HecVelaz/keepon-pro/docs/hardware/README.md

# Hardware

El detalle técnico (calibración de cada servo, alimentación, pines y problemas encontrados) está en
[`../HARDWARE.md`](../HARDWARE.md). Acá están las imágenes y los documentos de apoyo.

| Carpeta | Contenido |
|---|---|
| [`fotos/`](fotos/) | Wall-E armado (`Wall-e_frontal.jpeg`, `Wall-e_costado1.jpeg`, `Wall-e_costado2.jpeg`) y fotos o capturas de cada componente: Raspberry Pi 5, Camera Module 3 NoIR, ESP32-C3, servos, buzzer, powerbank y brazo de servo |
| [`diagrama_sistema/`](diagrama_sistema/index.html) | Diagrama eléctrico y del sistema, interactivo (abrir `index.html` en el navegador), con sus fotos |
| [`hojas_de_datos/`](hojas_de_datos/) | Hojas de datos y capturas de los servos que se probaron y no quedaron en el robot (SG90, MG90S, HS-7955TG) |

El diagrama de componentes del informe y del README (`../img/diagrama_componentes.png`) se genera con
`scripts/diagrama_componentes.py` a partir de estas fotos.
