HecVelaz/keepon-pro/docs/revisiones/README.md

# Revisiones externas

Durante el proyecto se pidieron revisiones a otro modelo (Codex, en modo solo lectura) para encontrar fallas antes de
construir. Cada una dice sobre qué versión se hizo; lo que se corrigió quedó anotado en
[`../HOJA_DE_RUTA.md`](../HOJA_DE_RUTA.md) y en [`../DECISIONES.md`](../DECISIONES.md).

| Archivo | Qué se revisó |
|---|---|
| [`REVISION_CODEX.md`](REVISION_CODEX.md) | El plan inicial frente a la consigna (30/09) |
| [`REVISION_CODEX_M0.md`](REVISION_CODEX_M0.md) | El primer código del robot: 8 fallos, todos corregidos y con test de regresión en `tests/test_regresiones_codex.py` |
| [`REVISION_CODEX_PI.md`](REVISION_CODEX_PI.md) | La Raspberry Pi real y el rendimiento de la percepción |
| [`REVISION_CODEX_ARQ.md`](REVISION_CODEX_ARQ.md) | La arquitectura: qué va en la Pi y qué en la ESP32 |
| [`REVISION_CODEX_HW.md`](REVISION_CODEX_HW.md) | El hardware: servos, pines de la ESP32 y alimentación |
