HecVelaz/keepon-pro/docs/HARDWARE.md

# Hardware real de Keepon pro

Movido desde `CLAUDE.md` el 22/10/2026. Referencia del hardware: Pi, cámara, ESP32-C3, servos y alimentación.
Las pruebas de banco de los servos están en `pruebas_servos/` (ver `pruebas_servos/CLAUDE.md`).

- **Raspberry Pi 5, 4 GB**, Ubuntu 24.04 + ROS 2 Jazzy. **No se puede cambiar el SO**: la Pi se usa en otros proyectos.
- **Camera Module 3 NoIR estándar** (RSP-CAM-V3-NOIR, **no la Wide**: 66° H nominal, lente de 11,5 mm; la foto de `docs/hardware/fotos/camera_Noir_module_3/` es de la Wide, solo ilustrativa) (IMX708) en `i2c@88000` desde el 03/11 (antes `i2c@80000`), **montada invertida: `orientation_deg: 180`** en `config.yaml`, que aplica `camera_ros`. Cinta disponible: **~150 mm** (15→22 pines): por eso la Pi tiene que ir en la cabeza, sobre roll (`docs/revisiones/REVISION_CODEX_ARQ.md`). Es NoIR, sin filtro IR, así que hay riesgo con los colores de las camisetas. La segunda NoIR (`i2c@88000`) aparece en libcamera pero no transmite ("Camera frontend has timed out": revisar el flex) y corre los índices: los scripts eligen la cámara **por nombre** (`camera.ros_camera` de `config.yaml`; `CAMARA=...` la cambia), no con `camera:=0`.
- **ESP32-C3-DevKitM-1** (no S3) para los 3 servos y el buzzer, por el micro-USB con puente UART (`/dev/ttyUSB0`; preferir `/dev/serial/by-id/...`). Pines: yaw GPIO0, pitch GPIO1, roll **GPIO4** (antes GPIO3; se cambió el 12/10 buscando una vibración que al final era del servo, y quedó así: el GPIO3 está al lado del GPIO2, de strapping), buzzer **GPIO5** desde el 03/11 (`buzzer.pin` de `config.yaml`; en el GPIO10 dejó de sonar con la cabeza v6 armada) (módulo pasivo MH-FMD desde el 26/10: VCC a **3V3**, activo en bajo, ver `pruebas_buzzer/README.md`); evitar 2/8/9 (strapping), 18/19 (USB) y 20/21 (UART0). Análisis completo en `docs/revisiones/REVISION_CODEX_HW.md` (escrito para microservos). Es un **clon con conversor CH340** (`1a86:7523`, `/dev/serial/by-id/usb-1a86_USB_Serial-if00-port0`). **Desde el 14/10 está conectada a la Pi y tiene cargado el firmware del robot** (`firmware/keepon_fw/`). Abrir el puerto no la reinicia; un pulso de RTS (con DTR bajo) sí. Para volver a las pruebas de banco, cargar `pruebas_servos/prueba_servo/prueba_servo.ino`.
- **Servos (asignación del 12/10, todos en `neck.servos` de `config.yaml`; planilla completa en `pruebas_servos/README.md`).** En el modelo vigente (v6 R4, `docs/diseno_v6/LEEME_GIT.md`): el RDS3218 va en la base y gira la horquilla; un MG996R va en la horquilla y mueve la cuna (pitch); otro MG996R va en la cuna y mueve la cabeza con el disco de 25T (roll). **Desde el 05/11 pitch y roll son dos TowerPro MG996R nuevos** (reemplazan al HS-7955TG y al MG996R con zona muerta). **Calibración montada (05/11):** ceros yaw 1500 / pitch 1500 / roll 1500 µs, signos −1 / −1 / −1 (el del roll sin verificar montado), sin compensación de zona muerta; detalle en `config.yaml`.
  - **yaw = DSSERVO RDS3218 n.º 2** (GPIO0): 270°, asimétrico 0,13/0,136 °/µs (lista `[lado <1500, lado >1500]`), ±70° ≈ 960/2010 µs, límites 950/2020 (no tiene tope: los límites protegen el cableado), banda muerta ≤ 2 µs abajo y 4–6 µs arriba, picos de ~1 A a 260 °/s. **Sin pulso mantiene la posición.**
  - **pitch = TowerPro MG996R nuevo** (GPIO1, desde el 05/11, ~10 kgf·cm a 6 V): 0,092 °/µs; montado, +30° = 1174 µs y −20° = 1717 µs (pulso mayor = la cara BAJA, signo −1); límites 1100/1800 µs. **Sin pulso queda flojo: la cabeza cae** al cortar el pulso o los 6 V (sostenerla al cargar el firmware y al apagar).
  - Antes (09/10–05/11), **pitch = Hitec HS-7955TG** (GPIO1, ~18 kgf·cm): 0,090 °/µs lineal, límites electrónicos 750/2250 µs (≈ ±68°; en el firmware 760/2240), banda muerta ≤ 2 µs, holgura ≤ 1°, 6 mA en reposo. **Sin pulso mantiene la posición con fuerza**: el STOP/watchdog la congela, no la afloja (para aflojarlo hay que cortar los 6 V). El primer pulso después de encender salta a velocidad máxima: el firmware tiene que arrancar en una postura conocida. Es el servo que más ruido mete en la alimentación.
  - **roll = TowerPro MG996R nuevo** (GPIO4, desde el 05/11): sin carga, +217 µs = +20° justos y −217 µs casi 20°; vuelve a 0 sin la zona muerta del anterior. Montado vibra un poco quieto en 0 al volver de −20°. Sin pulso queda flojo.
  - Antes (13/10–05/11), **roll = TowerPro MG996R n.º 1** (GPIO4): lineal y simétrico 0,092 °/µs, límites 1000/2000 µs (roll pide ±20°), sin tope hasta 800/2300 µs. **Banda muerta de ~100–110 µs (≈ 10°) e intermitente**: de +10° a 0° no volvió en 3 de 10 intentos; pasos de 20° andan siempre. Se aceptó porque roll hace gestos grandes; el firmware tiene que mandarle el objetivo de un solo movimiento. **Sin pulso queda flojo**. Pesa 55 g. Sentido de giro sin anotar. El MG90S (0,090/0,085 °/µs, banda muerta 20–30 µs, al máximo de su tensión a 6 V) queda de repuesto.
  - **Sentido de giro** (12/10, visto de frente al eje): pulso mayor = **antihorario** en los RDS3218 y el MG90S (el MG996R, sin anotar); **horario** en el HS. Para que yaw y pitch giren juntos en el banco hay que mandarle al HS el pulso en espejo (1500 − Δ). En el robot lo resuelve `signo` por eje, que se define al montar.
  - **Descartado: RDS3218 n.º 1.** Vibra (≈ 0,5 A) al quedar quieto cerca de 1500 µs, sobre todo con el HS activo; intercambiándolo con el n.º 2, la vibración siguió al servo (no era pin, señal ni cableado). Repuestos: SG90 (0,090 °/µs, engranajes plásticos, sin pulso queda flojo). El SM-S4315R es de rotación continua.
  - Los tres juntos andan bien a velocidad alta (12/10, fuente de laboratorio a 6 V). GND en estrella. El capacitor de 2200 µF + 100 nF en la bornera **se sacó del diseño el 26/10** (con la fuente de laboratorio los tres anduvieron bien sin él): si en el robot armado los servos tiemblan en los giros rápidos, es lo primero que hay que volver a poner. **Sin GND común entre la ESP32 y la fuente, ningún servo se mueve.** Son servos estándar (13–65 g). **No hay rodamiento de yaw** (no se consigue): desde el 14/10 la v3 apoya el plato solo en el horn del RDS3218 (≈ 330 g, ≈ 1,3 kgf·cm de vuelco; ver `docs/cad_anteriores/keepon_v3_cad/README.md`).
- **Alimentación (decisión del 14/10): fuente de laboratorio para los servos y powerbank para la Pi.** La LiPo Zeee y los reguladores salieron del diseño. Son dos fuentes separadas, unidas solo por el GND.
  - **Servos:** fuente de laboratorio externa a **6,0 V** (máximo 7,4 V), con el **límite de corriente en 4–5 A** (≥ 6 A ideal). En uso normal piden 2–3 A; trabados, 2,5–4,2 A por servo. Entra por dos bornes banana en la pared de atrás de la caja → interruptor (solo +6 V, ≥ 10 A: parada de emergencia y única forma de aflojar el HS) → bornera de 6 V.
  - **Pi 5:** powerbank **Xiaomi PB2020MI** (el mismo del recolector de frutas: se usan por separado; 20 000 mAh, 74 Wh, 5 V/3 A por puerto; ficha en `docs/hardware/fotos/Bateria_powerbank_xiaomi/`), desde su salida **USB-A** (da 5 V sin negociar: no hace falta placa USB-C con 5,1 kΩ en CC) con un cable USB-A cortado a 2 hilos (≥ 22 AWG) → bornera de 5 V en la base → pines 2/4 y 6 del GPIO, con cable de 20 AWG. **Conectado directo por USB-C, el powerbank alimenta bien a la Pi** (14/10, en el banco): si al armar la cabeza el USB-C queda libre (`PI_CSI_SALIDA`), usar un cable USB-C acodado directo y eliminar el camino por el GPIO. Sin los 5 A de PD, la Pi limita los USB a 600 mA (a la ESP32 le alcanza): no forzar `usb_max_current_enable`. Dura ~9 h. Medir ≥ 4,9 V en los pines.
  - **Encender:** primero el powerbank y después los 6 V, con la cabeza cerca de home. **Apagar:** al revés.
- La ALP002 ajustable (3–24 V, **1,5 A**, **entrada 100–120 V de alterna: no enchufar a 220 V sin transformador**) sirve solo para probar un servo sin carga. Para las pruebas individuales, mejor la fuente de laboratorio con límite de corriente.
- La notebook (x86, GPU vieja, sin CUDA) sirve solo para desarrollar.
