HecVelaz/keepon-pro/docs/diseno_v6/INFORME_ENTREGA_V6.md

# Resultado de la entrega V6

Se guardaron y reabrieron 18 piezas individuales y
el ensamblaje SolidWorks 2021 con cuatro grupos rígidos, seis relaciones y
diez poses resueltas. Los tres acoples eje/horn se identificaron por pareja y
volumen; no hubo otras interferencias nativas reportadas.

R2 retira la tapa14 y sus cuatro M3, crea dos aberturas posteriores simétricas
de36 ×26 mm y conserva la cuna R1. Actualiza soporte15 al PCB medido RLBZ23
de13 ×31,8 ×1,5 mm, agujeroØ3 con centro a6,3/16,4 desde bordes; buzzer abajo
y pines arriba. Carcasas16/17 espejadas con estética WALL-E y lentes19/20
pegables aparte; arandela21 y M3×5 para el PCB.

Se repitió el barrido B-Rep completo de 495 poses con los M3×6 finales.
Una reserva USB de diseño pasa 41 poses de roll cada grado, con mínimo
muestreado 0,69 mm del lado Y negativo. No representa un enchufe físico.
Los 17 STEP/STL de revisión pasaron geometría de archivo y
orientación; 13 regresiones están aprobadas.

La base V5 no se modificó. El modelo integrado incorpora soportes, encastres
nominales, retenciones, salida USB, cámara, portamódulo y ojos. El perfil de
pitch es una referencia de estudio de una rama. Se modela el PCB del RLBZ23;
alturas/componentes/pines y enchufes aún faltan medir. Por eso el conjunto
no se libera para fabricar. Consultar README y MEDICIONES_PENDIENTES.

Para abrir la entrega, extraer el ZIP y mantener todos los SLDPRT junto al
SLDASM dentro de SOLIDWORKS_V6. Se leyeron las dependencias guardadas de
los cuatro grupos: no tienen referencias externas ni requieren los STEP.
Para regenerar el CAD se requiere el repositorio con las fuentes V2–V5,
CadQuery y la instalación local indicada; el ZIP permite revisar los modelos
sin disponer de Python.
