HecVelaz/keepon-pro/docs/diseno_v6/revision_R4/interfaces_R4.csv

pieza | uso | eje | diametro_mm | centro_x_mm | centro_y_mm | centro_z_mm | inicio_eje_mm | fin_eje_mm | nota
Soporte_servo_base | Paso M3 centrado en pilar | Z | 3.4 | -18 | -6 | 0 | 38 | 44
Base_con_pilares | Alojamiento inserto M3 L5 | Z | 4 | -18 | -6 | 0 | 31.4 | 38 | Diámetro de inserto provisional
Soporte_servo_base | Paso M3 centrado en pilar | Z | 3.4 | -18 | 6 | 0 | 38 | 44
Base_con_pilares | Alojamiento inserto M3 L5 | Z | 4 | -18 | 6 | 0 | 31.4 | 38 | Diámetro de inserto provisional
Soporte_servo_base | Paso M3 centrado en pilar | Z | 3.4 | 38 | -6 | 0 | 38 | 44
Base_con_pilares | Alojamiento inserto M3 L5 | Z | 4 | 38 | -6 | 0 | 31.4 | 38 | Diámetro de inserto provisional
Soporte_servo_base | Paso M3 centrado en pilar | Z | 3.4 | 38 | 6 | 0 | 38 | 44
Base_con_pilares | Alojamiento inserto M3 L5 | Z | 4 | 38 | 6 | 0 | 31.4 | 38 | Diámetro de inserto provisional
Carcasa_cabeza | Piloto Pi | Z | 2.2 | -3.5 | -44 | 0 | 111.4 | 119.4 | Poste Ø9×8
Carcasa_cabeza | Piloto Pi | Z | 2.2 | -3.5 | 5 | 0 | 111.4 | 119.4 | Poste Ø9×8
Carcasa_cabeza | Piloto Pi | Z | 2.2 | 54.5 | -44 | 0 | 111.4 | 119.4 | Poste Ø9×8
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
