HecVelaz/keepon-pro/docs/consigna/README.md

# Consigna

| Archivo | Contenido |
|---|---|
| [`2026S2uTP_RoboticaSocial.pdf`](2026S2uTP_RoboticaSocial.pdf) | Enunciado original de la cátedra (Robótica II, FIUNA) |
| [`2026S2uTP_RoboticaSocial.md`](2026S2uTP_RoboticaSocial.md) | El mismo enunciado en Markdown, para leerlo y buscar en GitHub |
| [`CHECKLIST_TP.md`](CHECKLIST_TP.md) | Cada punto de la consigna (T1 a T7 y la entrega) con su estado y dónde está en el código |
| [`checklist_robotica_social.html`](checklist_robotica_social.html) | El mismo checklist, interactivo (se abre en el navegador) |
