HecVelaz/keepon-pro/docs/diseno_v6/revision_R4/ESTADO_TRABAJO.md

# R4 actualizada: extremo del buzzer despejado

Se retiraron los dos apoyos cilindricos y la guia rectangular seleccionados por el usuario. Se conserva el poste con piloto ciego para el unico tornillo trasero del buzzer.

33 regresiones geometricas y barrido sin interferencias imprevistas aprobados; 12 STL cerrados y orientados. Cuatro grupos nativos verificados, seis relaciones, diez posiciones y ensamblaje guardado y reabierto. Copia de los archivos nativos anteriores en HISTORIAL/antes_retirar_apoyos_buzzer/.

Ensamblaje actualizado: SOLIDWORKS_R4/Keepon_V6_R4.SLDASM, abierto en SolidWorks. Entrega actualizada: ../Keepon_V6_R4.zip.
