HecVelaz/keepon-pro/docs/cad_anteriores/keepon_v4_cad/cabeza.png

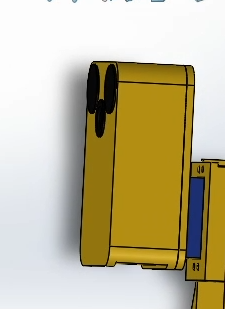
docs/cad_anteriores/keepon_v4_cad/cabeza.png
