HecVelaz/keepon-pro/docs/cad_anteriores/keepon_v4_cad/cuerpo.png

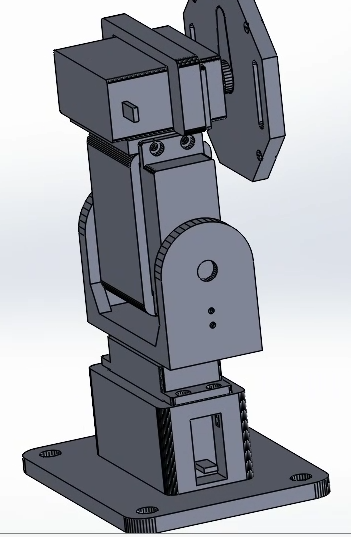
docs/cad_anteriores/keepon_v4_cad/cuerpo.png
