HecVelaz/keepon-pro/docs/cad_anteriores/keepon_v4_cad/vistas/02_atras_iso.png

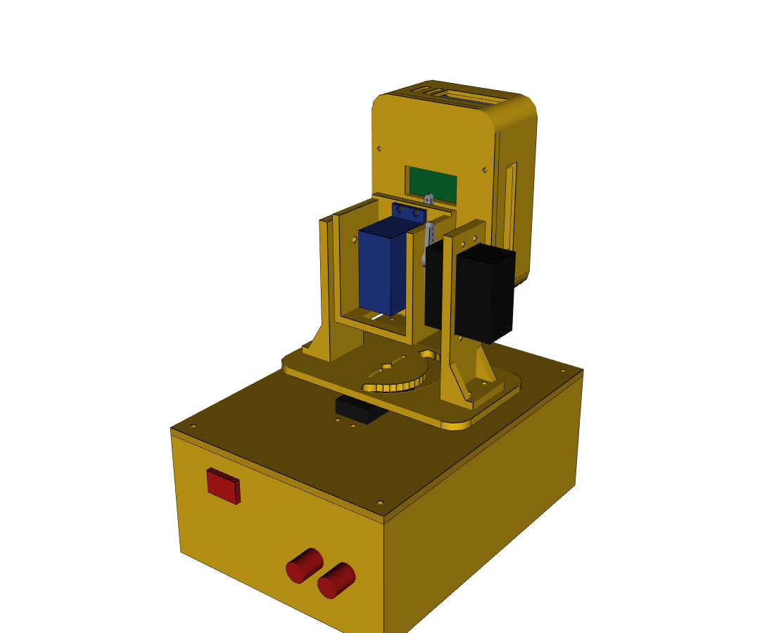
docs/cad_anteriores/keepon_v4_cad/vistas/02_atras_iso.png
