HecVelaz/keepon-pro/docs/cad_anteriores/keepon_v4_cad/vistas/03_costado.png

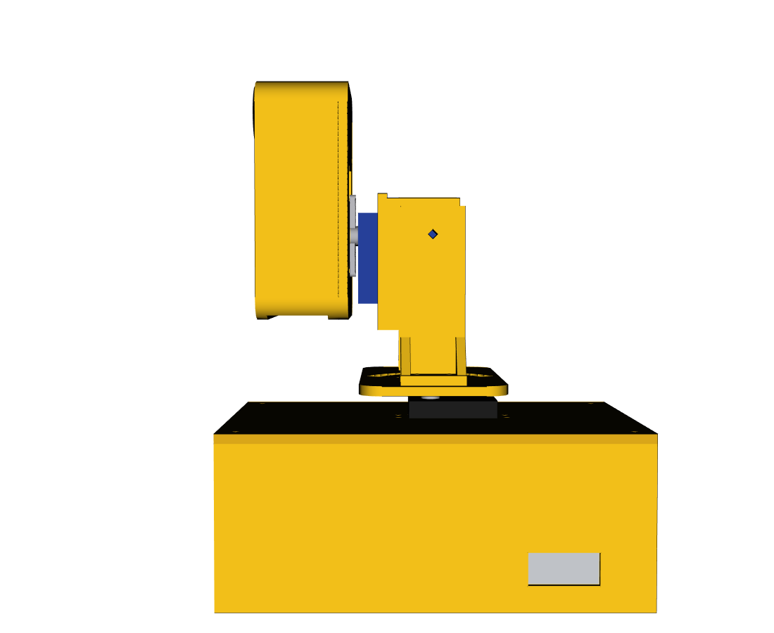
docs/cad_anteriores/keepon_v4_cad/vistas/03_costado.png
