HecVelaz/keepon-pro/docs/cad_anteriores/keepon_v4_cad/vistas/04_frente.png

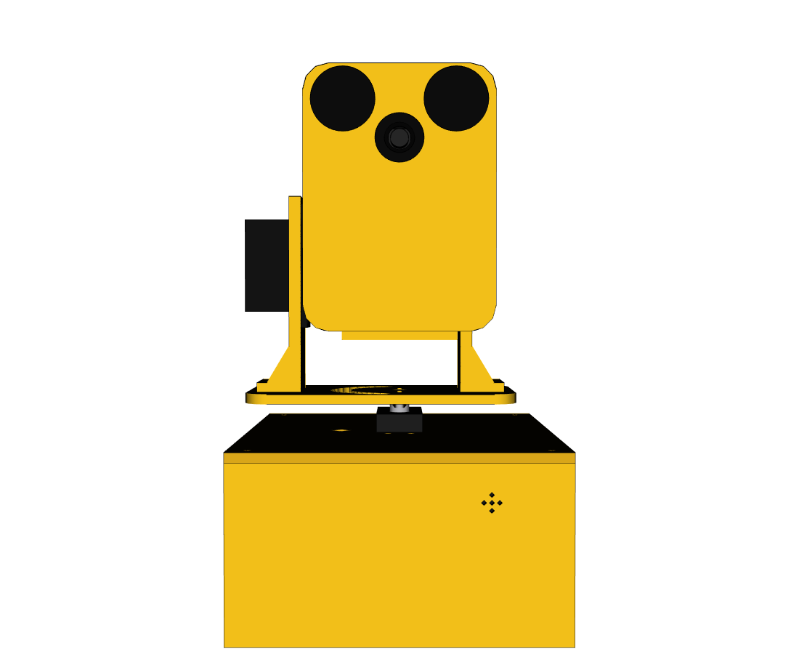
docs/cad_anteriores/keepon_v4_cad/vistas/04_frente.png
