HecVelaz/keepon-pro/docs/cad_anteriores/keepon_v4_cad/vistas/07_mira_arriba_yaw.png

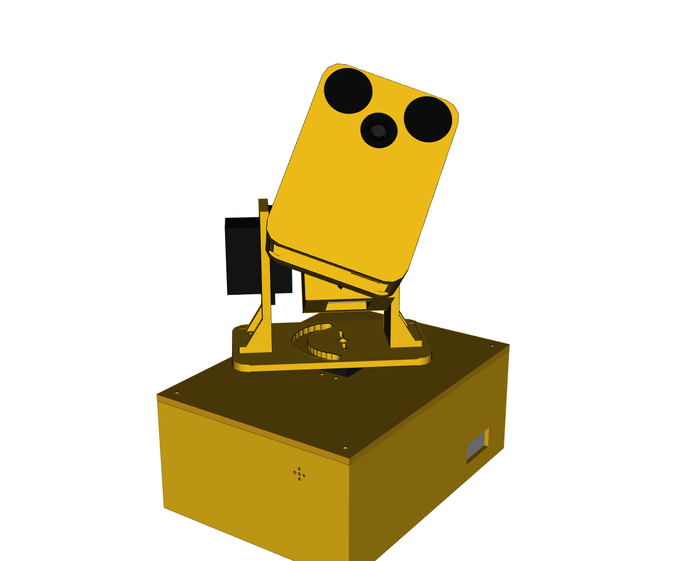
docs/cad_anteriores/keepon_v4_cad/vistas/07_mira_arriba_yaw.png
