HecVelaz/keepon-pro/docs/diseno_v6/revision_R4/vistas/02_R4_disco_roll.png

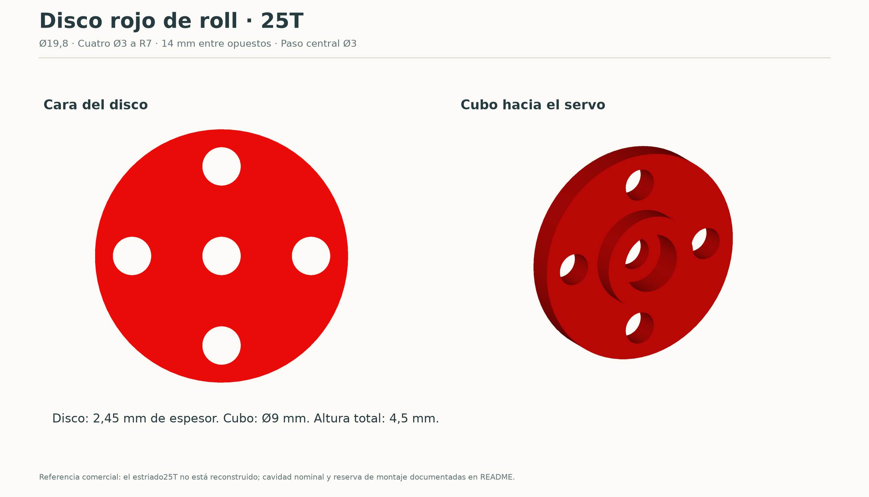
docs/diseno_v6/revision_R4/vistas/02_R4_disco_roll.png
