HecVelaz/keepon-pro/docs/hardware/diagrama_sistema/fotos/camara.jpg

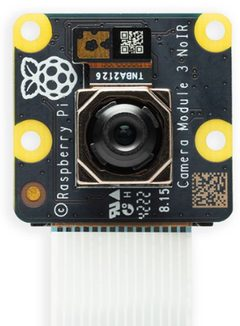
docs/hardware/diagrama_sistema/fotos/camara.jpg
