HecVelaz/keepon-pro/docs/hardware/diagrama_sistema/fotos/hs7955tg.jpg

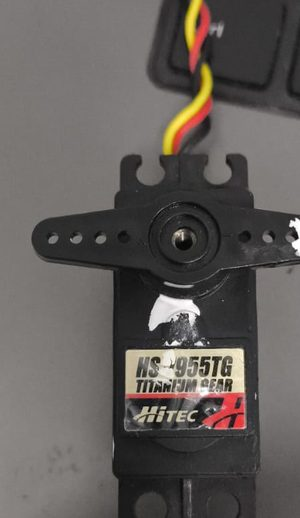
docs/hardware/diagrama_sistema/fotos/hs7955tg.jpg
