HecVelaz/keepon-pro/docs/hardware/diagrama_sistema/fotos/mg996r.jpg

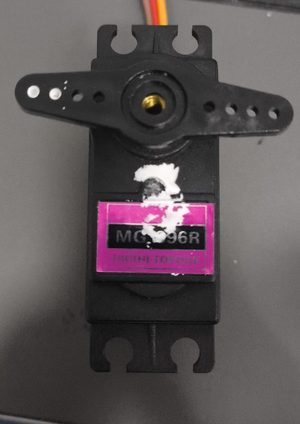
docs/hardware/diagrama_sistema/fotos/mg996r.jpg
