HecVelaz/keepon-pro/docs/hardware/diagrama_sistema/fotos/mg996r_nuevo.jpg

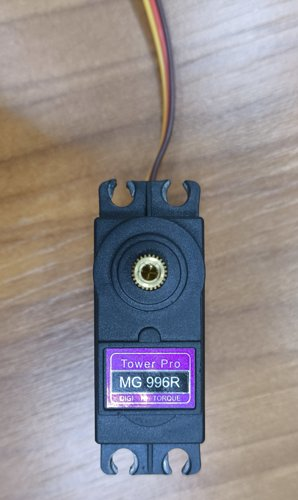
docs/hardware/diagrama_sistema/fotos/mg996r_nuevo.jpg
