HecVelaz/keepon-pro/docs/hardware/diagrama_sistema/fotos/pi5.jpg

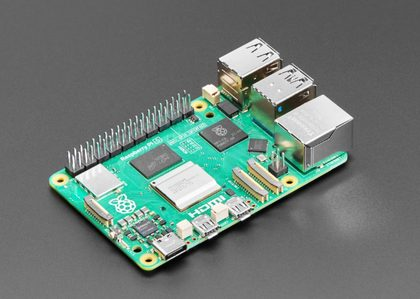
docs/hardware/diagrama_sistema/fotos/pi5.jpg
