HecVelaz/keepon-pro/docs/hardware/diagrama_sistema/fotos/powerbank.jpg

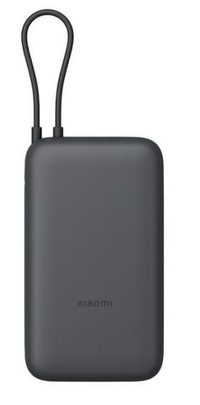
docs/hardware/diagrama_sistema/fotos/powerbank.jpg
