HecVelaz/keepon-pro/docs/hardware/diagrama_sistema/fotos/rds3218.jpg

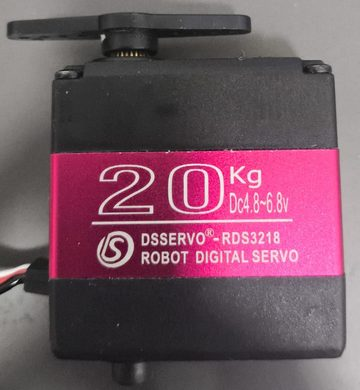
docs/hardware/diagrama_sistema/fotos/rds3218.jpg
