HecVelaz/keepon-pro/docs/hardware/fotos/Bateria_powerbank_xiaomi/Captura_desde_2026-10-14_18-55-17.png

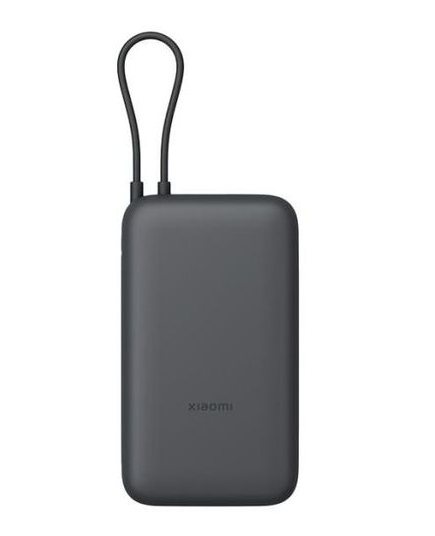
docs/hardware/fotos/Bateria_powerbank_xiaomi/Captura_desde_2026-10-14_18-55-17.png
