HecVelaz/keepon-pro/docs/hardware/fotos/bateria_zee/Captura_desde_2026-10-05_20-32-26.png

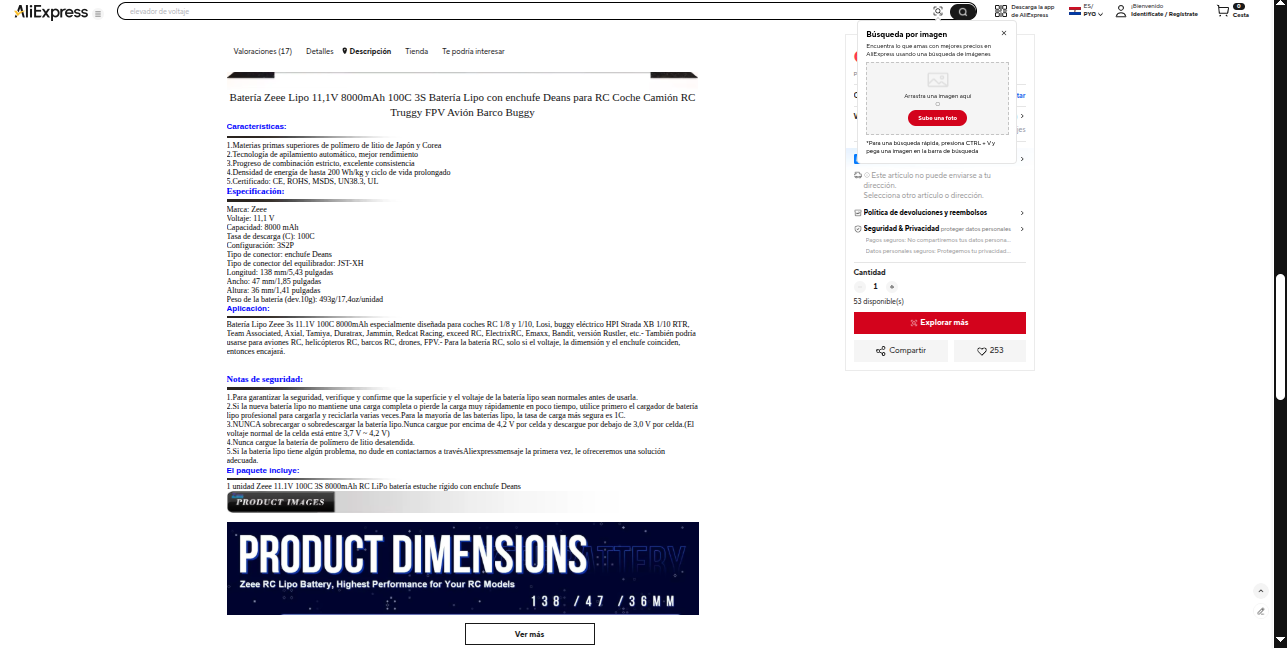
docs/hardware/fotos/bateria_zee/Captura_desde_2026-10-05_20-32-26.png
