HecVelaz/keepon-pro/docs/hardware/fotos/brazo_servo/brazo_servo.jpeg

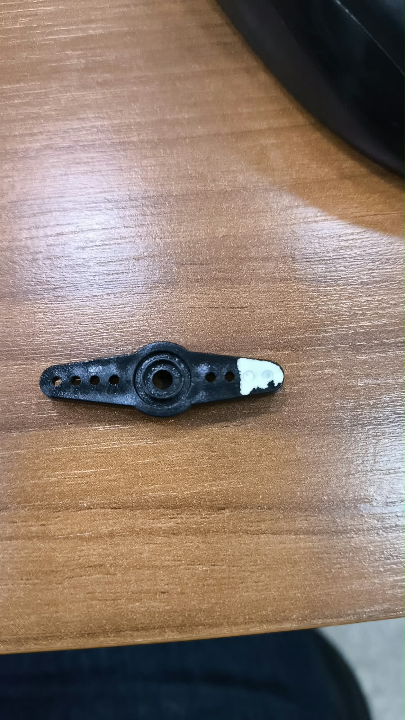
docs/hardware/fotos/brazo_servo/brazo_servo.jpeg
