HecVelaz/keepon-pro/docs/hardware/fotos/camera_Noir_module_3/Captura_desde_2026-10-14_11-50-46.png

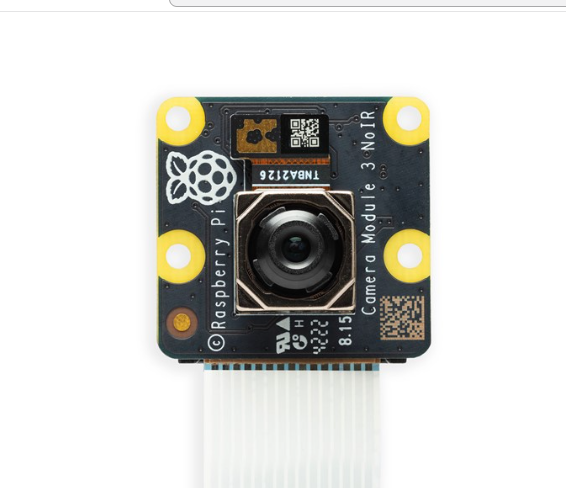
docs/hardware/fotos/camera_Noir_module_3/Captura_desde_2026-10-14_11-50-46.png
