HecVelaz/keepon-pro/docs/hardware/fotos/esp32_c3_mini_1/51aC5YsjEjL.webp

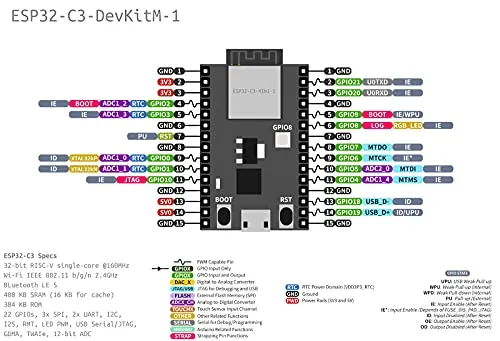
docs/hardware/fotos/esp32_c3_mini_1/51aC5YsjEjL.webp
