HecVelaz/keepon-pro/docs/hardware/fotos/esp32_c3_mini_1/51gB6Uad4BL._AC_SX425_.jpg

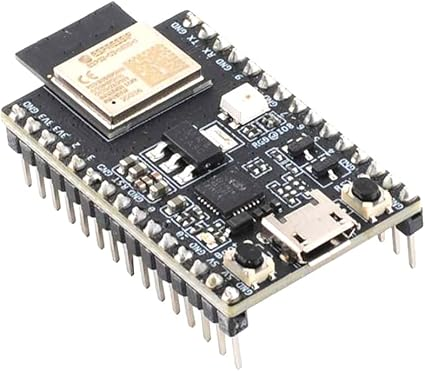
docs/hardware/fotos/esp32_c3_mini_1/51gB6Uad4BL._AC_SX425_.jpg
