HecVelaz/keepon-pro/docs/hardware/fotos/esp32_c3_mini_1/Captura_desde_2026-10-07_15-21-32.png

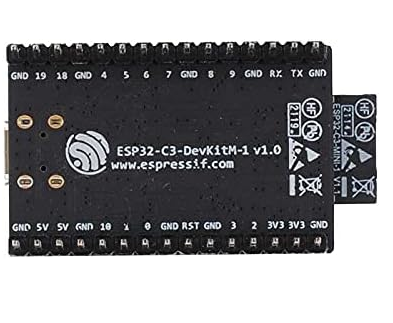
docs/hardware/fotos/esp32_c3_mini_1/Captura_desde_2026-10-07_15-21-32.png
