HecVelaz/keepon-pro/docs/hardware/fotos/MG_996r_nuevo/mg_996r.jpg

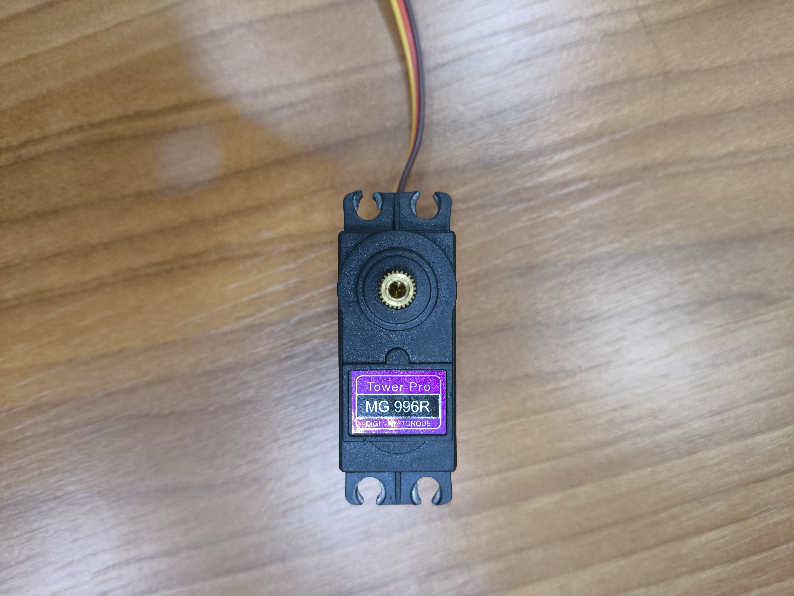
docs/hardware/fotos/MG_996r_nuevo/mg_996r.jpg
