HecVelaz/keepon-pro/docs/hardware/fotos/modulo_buzzer_pasivo/buzzer_pasivo.png

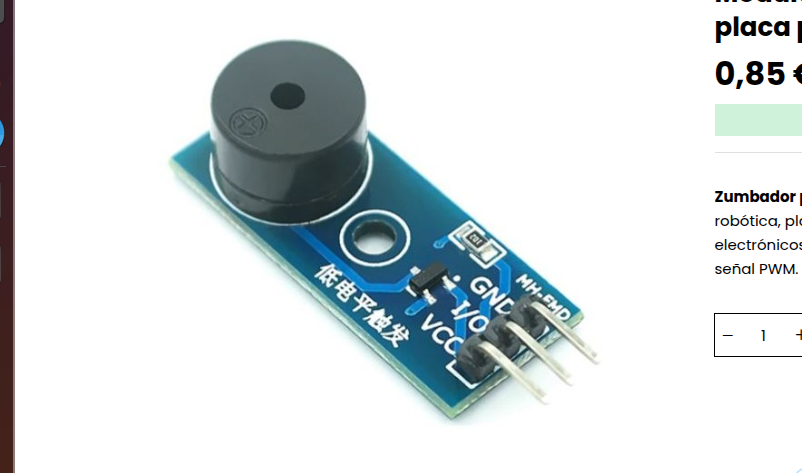
docs/hardware/fotos/modulo_buzzer_pasivo/buzzer_pasivo.png
