HecVelaz/keepon-pro/docs/hardware/fotos/raspberry_pi/Captura_desde_2026-10-14_11-07-33.png

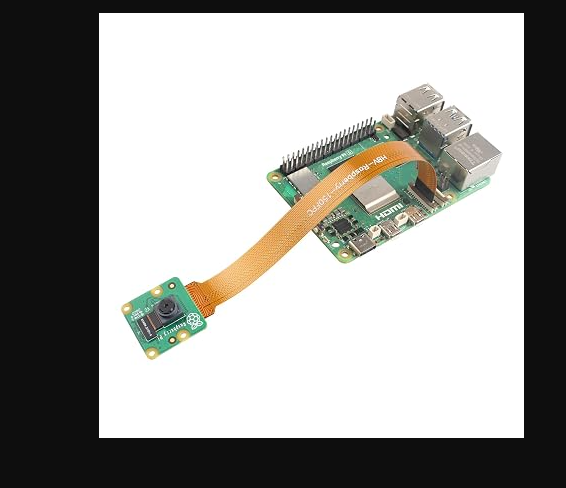
docs/hardware/fotos/raspberry_pi/Captura_desde_2026-10-14_11-07-33.png
