HecVelaz/keepon-pro/docs/hardware/fotos/servo_HS_7955TG/hs7955tg.jpeg

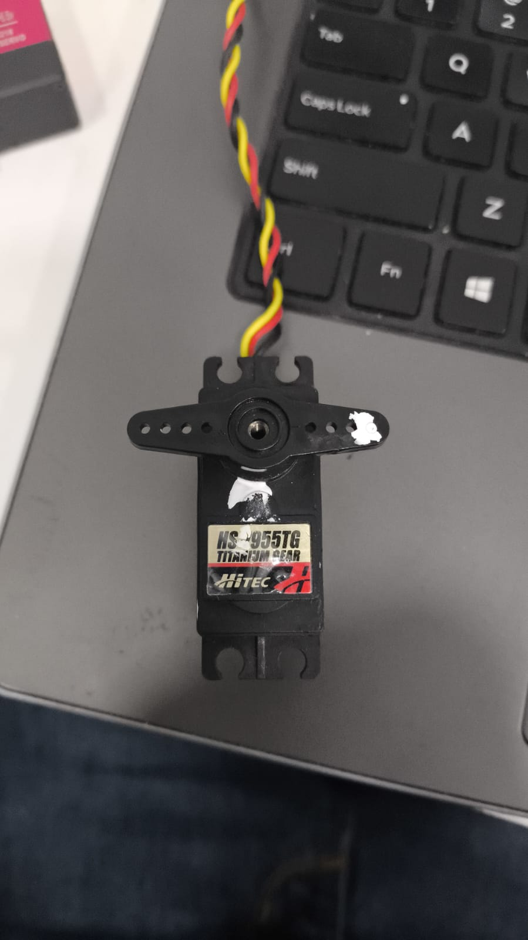
docs/hardware/fotos/servo_HS_7955TG/hs7955tg.jpeg
