HecVelaz/keepon-pro/docs/hardware/fotos/servo_MG_996R/mg996r.jpeg

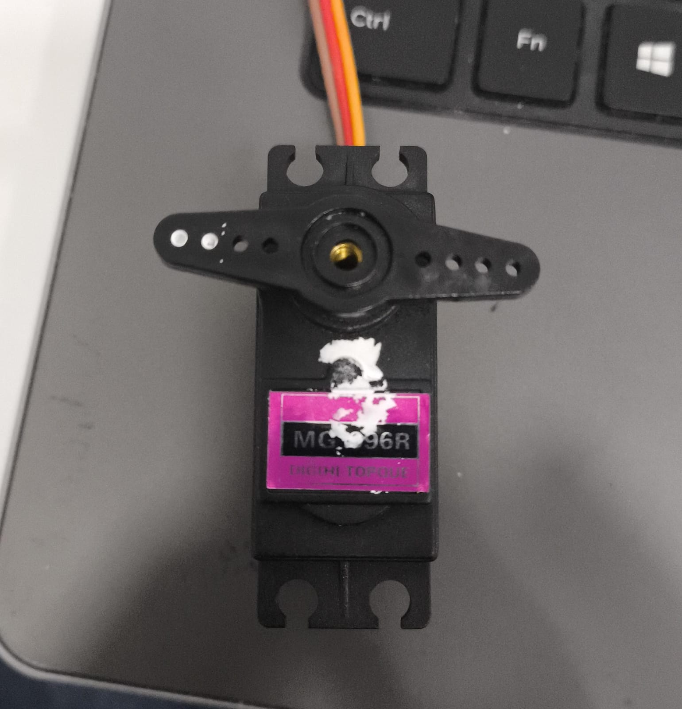
docs/hardware/fotos/servo_MG_996R/mg996r.jpeg
