HecVelaz/keepon-pro/docs/hardware/fotos/servo_RDS3218/rds3218.jpeg

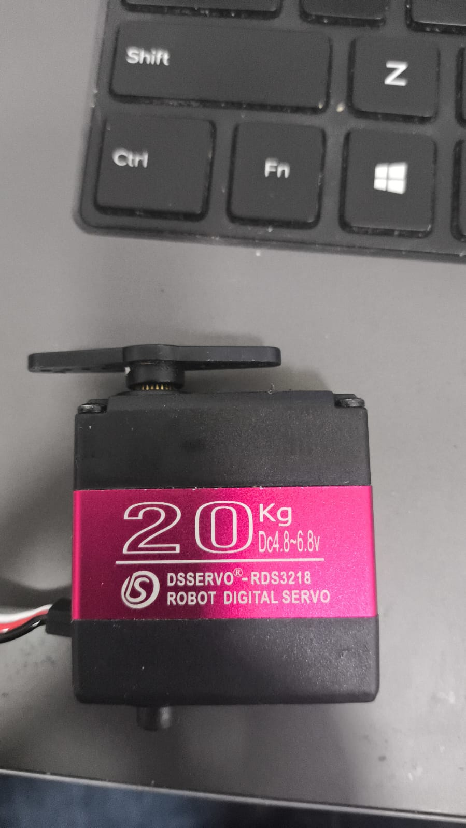
docs/hardware/fotos/servo_RDS3218/rds3218.jpeg
