HecVelaz/keepon-pro/docs/hardware/hojas_de_datos/micro_servo_mg90s/Captura_desde_2026-10-07_15-32-10.png

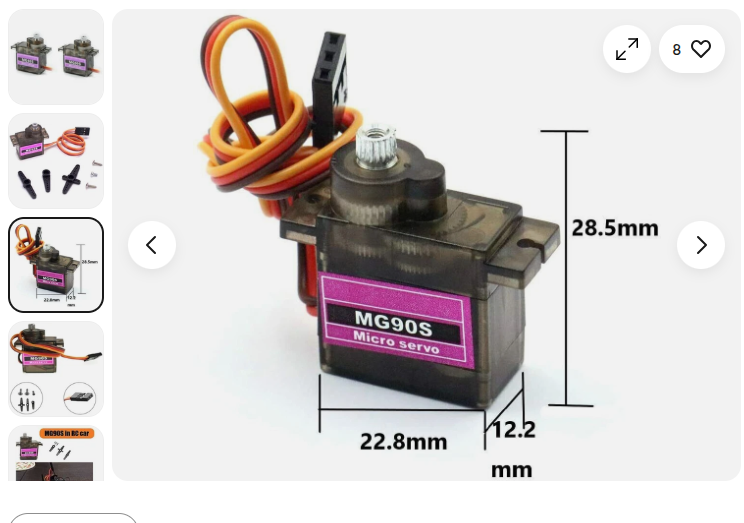
docs/hardware/hojas_de_datos/micro_servo_mg90s/Captura_desde_2026-10-07_15-32-10.png
