HecVelaz/keepon-pro/docs/hardware/hojas_de_datos/micro_servo_sg90/Captura_desde_2026-10-07_15-35-38.png

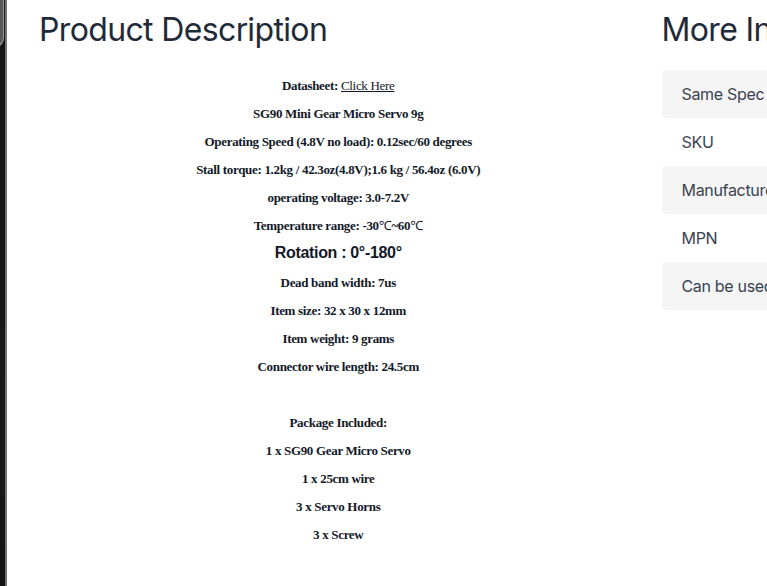
docs/hardware/hojas_de_datos/micro_servo_sg90/Captura_desde_2026-10-07_15-35-38.png
