HecVelaz/keepon-pro/docs/hardware/hojas_de_datos/servo_HS-7955TG_titanium_gear/Captura_desde_2026-10-07_16-58-57.png

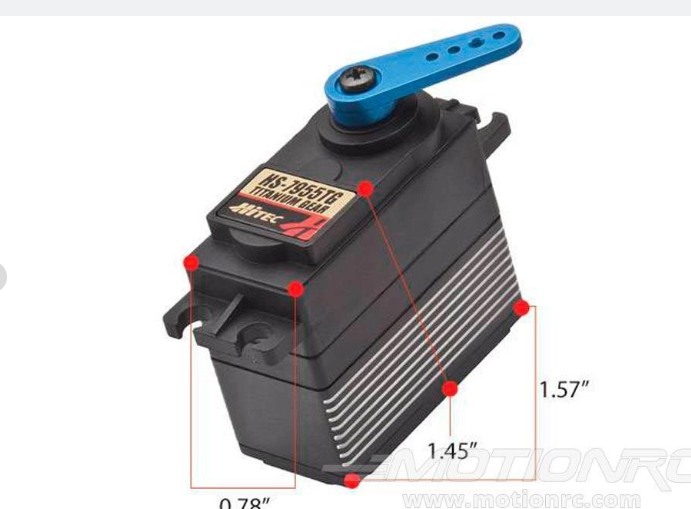
docs/hardware/hojas_de_datos/servo_HS-7955TG_titanium_gear/Captura_desde_2026-10-07_16-58-57.png
