HecVelaz/keepon-pro/docs/img/panel_celular_completo.png

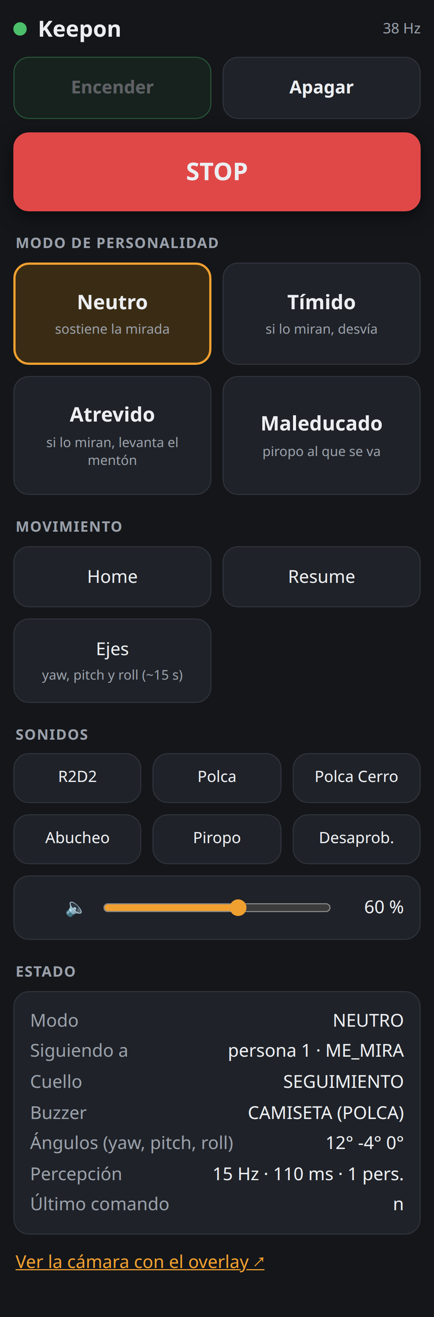
docs/img/panel_celular_completo.png
