HecVelaz/keepon-pro/docs/benchmark_pi_20260930_2personas.csv

fecha | label | modelo | imgsz | hilos | yolo | face | pose | cam_hz | proc_hz | yolo_ms | yolo_p95 | face_ms | pose_ms | total_ms | total_p95 | edad_ms | edad_p95 | cpu_pct | ram_mb | personas | rostros | poses | temp_c
2026-09-30 20:35:21 | P_yolo256_t4 | yolo26n_256_ncnn_model | 256 | 0 | 1 | 0 | 0 | 29.8 | 29.9 | 18.6 | 19.5 | 0.0 | 0.0 | 18.6 | 19.5 | 33.9 | 35.1 | 203 | 786 | 2 | nan | nan | 54.55
2026-09-30 20:35:42 | P_mediapipe | yolo26n_320_ncnn_model | 320 | 0 | 0 | 1 | 1 | 29.6 | 11.5 | 0.0 | 0.0 | 22.6 | 63.5 | 86.2 | 105.8 | 118.9 | 141.9 | 120 | 296 | nan | 0.72 | 1.28 | 52.9
2026-09-30 20:36:04 | P_full256 | yolo26n_256_ncnn_model | 256 | 0 | 1 | 1 | 1 | 26.6 | 9.0 | 20.2 | 24.2 | 24.2 | 66.4 | 110.8 | 132.8 | 144.6 | 166.0 | 153 | 951 | 2 | 0.39 | 1.96 | 52.9
2026-09-30 20:36:27 | P_full320 | yolo26n_320_ncnn_model | 320 | 0 | 1 | 1 | 1 | 24.5 | 8.0 | 29.5 | 32.0 | 26.1 | 68.7 | 124.3 | 129.7 | 156.4 | 168.4 | 166 | 954 | 2 | 0.62 | 1.95 | 54.55
