HecVelaz/keepon-pro/docs/cad_anteriores/keepon_mg996r_step/0_ensamble_referencia.step

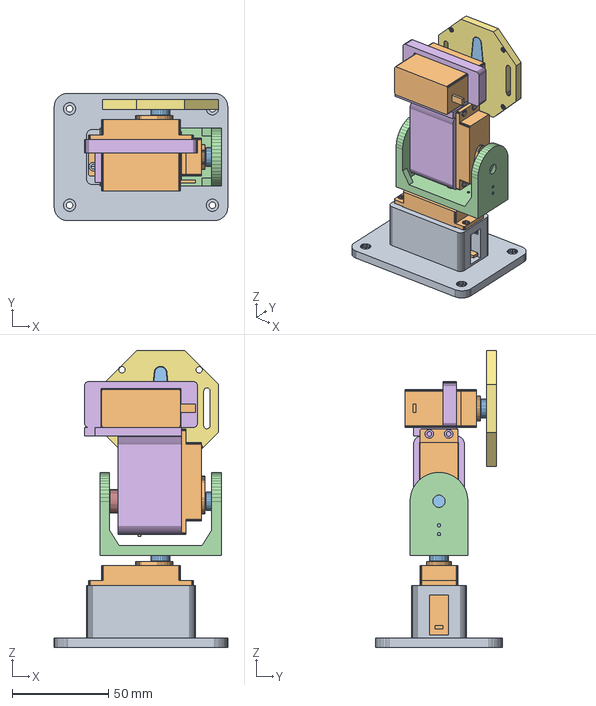
[picture p58: CAD file, 2026-10-14]
docs/cad_anteriores/keepon_mg996r_step/0_ensamble_referencia.step
90.0 x 66.0 x 153.9 mm
