HecVelaz/keepon-pro/docs/cad_anteriores/keepon_v4_cad/step/keepon_v4_ensamble.step

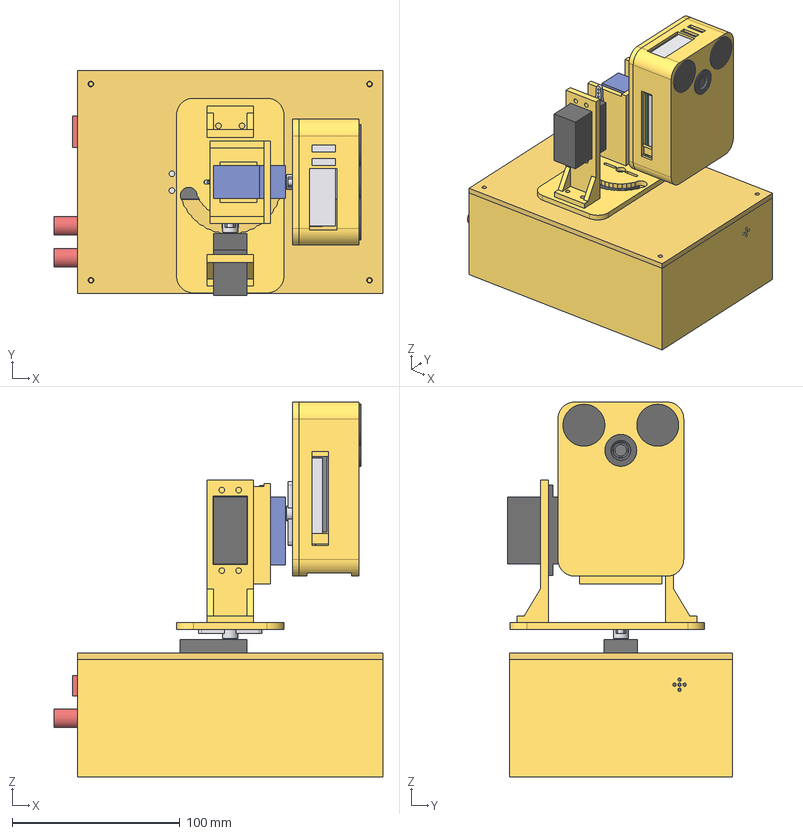
[picture p59: CAD file, 2026-10-14]
docs/cad_anteriores/keepon_v4_cad/step/keepon_v4_ensamble.step
196.0 x 134.0 x 223.5 mm
caja_base
tapa_base
powerbank_xiaomi_pb2020mi
bornera_6v
capacitor_2200uf
bornes_fuente_6v
esp32c3
porta_esp32
buzzer
interruptor
bornera_5v
plato_yaw
servo_yaw_rds3218
horn_yaw
soporte_pitch_izq
soporte_pitch_der
servo_pitch_hs7955tg
horn_pitch
horquilla_cabeza
servo_roll_mg996r
horn_roll
placa_roll
pi5_pcb
pi5_puertos
pi5_conectores_csi
pi5_active_cooler
camara_pcb
camara_lente
camara_conector
cinta_ffc
caja_cabeza
nariz_camara
ojo_izq
ojo_der
