HecVelaz/keepon-pro/docs/diseno_v6/revision_R4/STEP_V6/00_ensamble_V6_R4.step

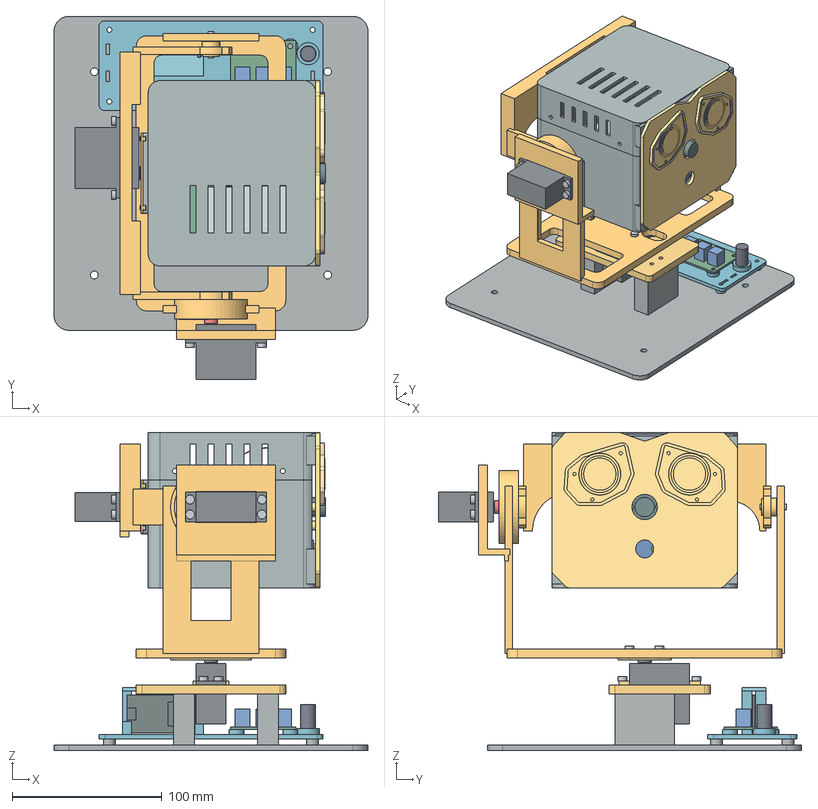
[picture p60: CAD file, 2026-11-08]
docs/diseno_v6/revision_R4/STEP_V6/00_ensamble_V6_R4.step
210.0 x 243.0 x 213.0 mm
01_base_con_pilares
02_horquilla_de_giro
03_cuna_de_inclinacion
04_carcasa_inferior_cabeza
05_tapa_superior_ventilada
06_cara_con_ojos_integrados
Referencia_pivote_M4
Referencia_Raspberry_Pi_5
Reserva_refrigerador_Raspberry_Pi
Referencia_camara_NoIR_3
Referencia_cinta_camara_150
08_bandeja_de_electronica
09_abrazadera_ESP32
Referencia_ESP32_C3_CH340
Referencia_placa_distribucion
Referencia_conector_base
Referencia_conector_inclinacion
Referencia_conector_balanceo
Referencia_capacitor_2200uF
10_soporte_centrado_servo_base
11_retencion_brazo_doble_base
13_retencion_disco_balanceo
Referencia_modulo_buzzer_31_8x12_8x10
Referencia_servo_base_RDS3218
Referencia_servo_inclinacion_HS7955TG
Referencia_servo_balanceo_MG996R
Referencia_brazo_doble_base
Referencia_disco_balanceo
Referencia_brazo_simple_inclinacion
Tornillo_M3_retencion_base_0
Tornillo_M3_retencion_base_1
Tornillo_M3_retencion_base_2
Tornillo_M3_retencion_base_3
Tornillo_M3_retencion_balanceo_0
Tornillo_M3_retencion_balanceo_1
Tornillo_M3_retencion_balanceo_2
Tornillo_M3_retencion_balanceo_3
Tornillo_M3_servo_base_0
Tornillo_M3_servo_base_1
Tornillo_M3_servo_base_2
Tornillo_M3_servo_base_3
Tornillo_M3_servo_inclinacion_0
Tornillo_M3_servo_inclinacion_1
Tornillo_M3_servo_inclinacion_2
Tornillo_M3_servo_inclinacion_3
Tornillo_M3_servo_balanceo_0
Tornillo_M3_servo_balanceo_1
Tornillo_M3_servo_balanceo_2
Tornillo_M3_servo_balanceo_3
Tornillo_M3_buzzer_placa
22_casquillo_extraible_pivote_inclinacion
