HecVelaz/keepon-pro/docs/diseno_v6/revision_R4/SOLIDWORKS_R4/Keepon_V6_R4.SLDASM

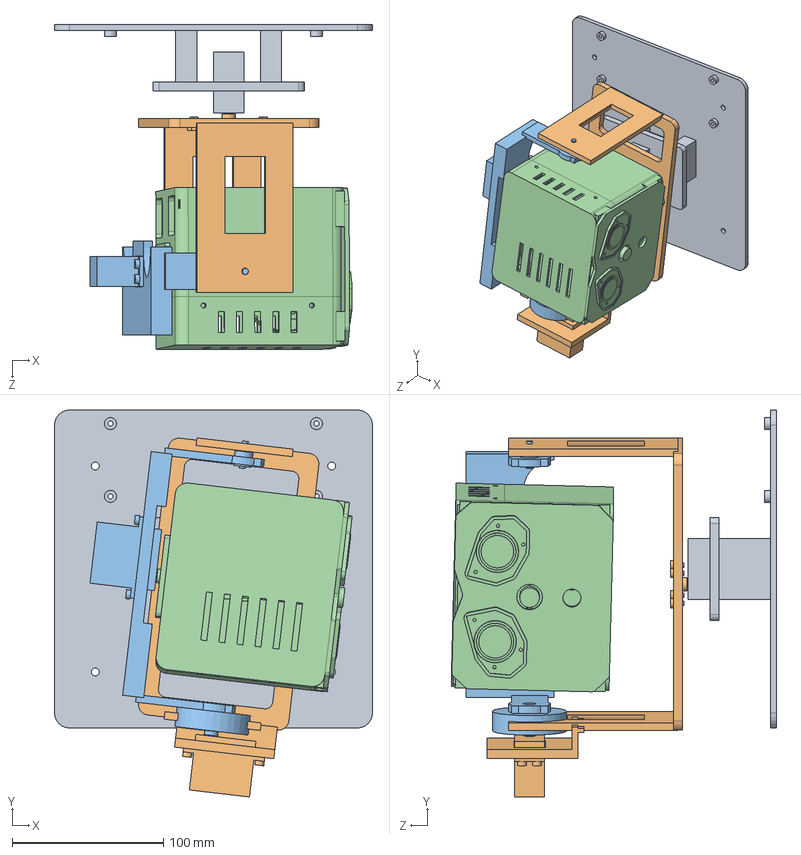
[picture p61: CAD file, 2026-11-08]
docs/diseno_v6/revision_R4/SOLIDWORKS_R4/Keepon_V6_R4.SLDASM
210.0 x 255.6 x 214.5 mm
Base_y_electronica
Horquilla_de_giro
Cuna_de_inclinacion
Cabeza_y_cara
