HecVelaz/keepon-pro/docs/cad_anteriores/keepon_mg996r_step/3_soporte_tilt_y_roll.step

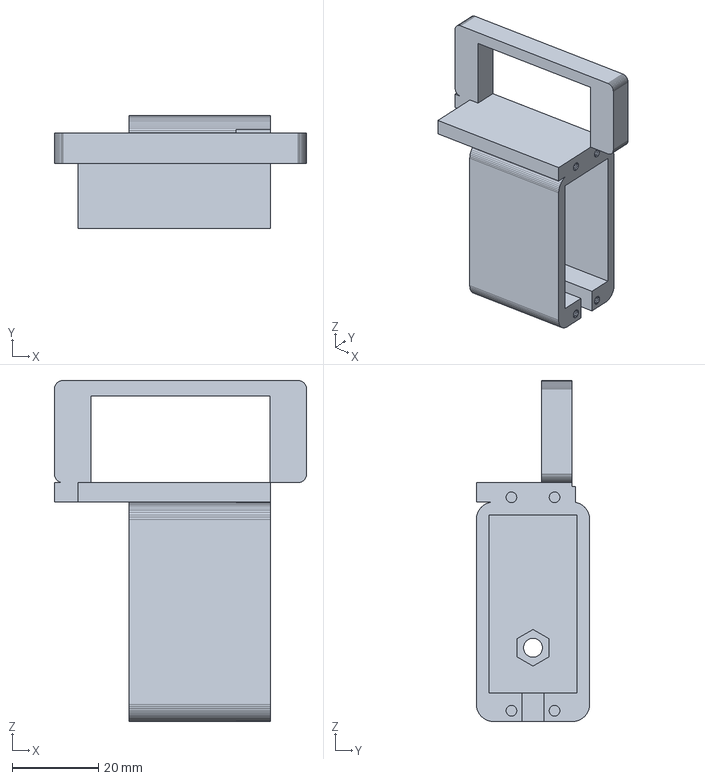
[picture p62: CAD file, 2026-10-14]
docs/cad_anteriores/keepon_mg996r_step/3_soporte_tilt_y_roll.step
58.5 x 26.3 x 79.1 mm
