HecVelaz/keepon-pro/docs/cad_anteriores/keepon_v4_cad/step/componentes/bornera_6v.step

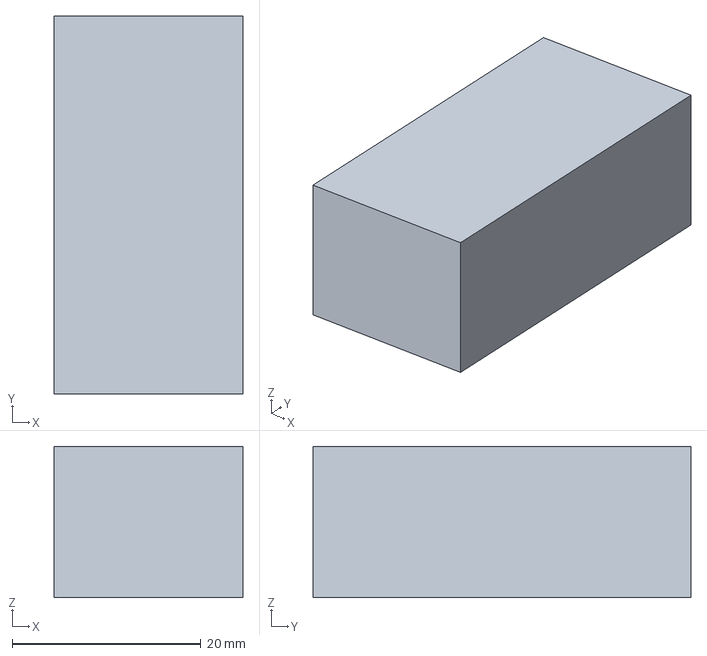
[picture p63: CAD file, 2026-10-14]
docs/cad_anteriores/keepon_v4_cad/step/componentes/bornera_6v.step
20.0 x 40.0 x 16.0 mm
