HecVelaz/keepon-pro/docs/cad_anteriores/keepon_v4_cad/step/soporte_pitch_izq.step

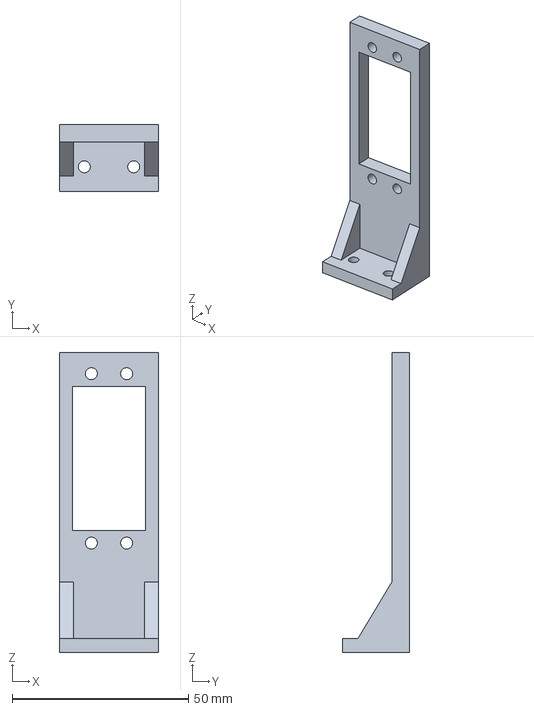
[picture p64: CAD file, 2026-10-14]
docs/cad_anteriores/keepon_v4_cad/step/soporte_pitch_izq.step
28.0 x 19.0 x 85.0 mm
