HecVelaz/keepon-pro/docs/diseno_v6/IMPRESION_STL/18_cupon_insertos.stl

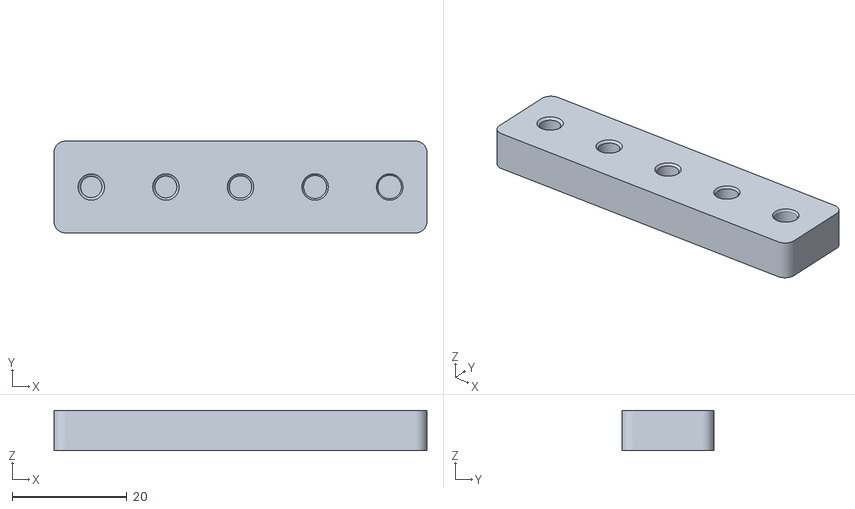
[picture p65: CAD file, 2026-11-08]
docs/diseno_v6/IMPRESION_STL/18_cupon_insertos.stl
65.0 x 16.0 x 7.00
