HecVelaz/keepon-pro/docs/diseno_v6/revision_R4/SOLIDWORKS_R4/Base_y_electronica.SLDPRT

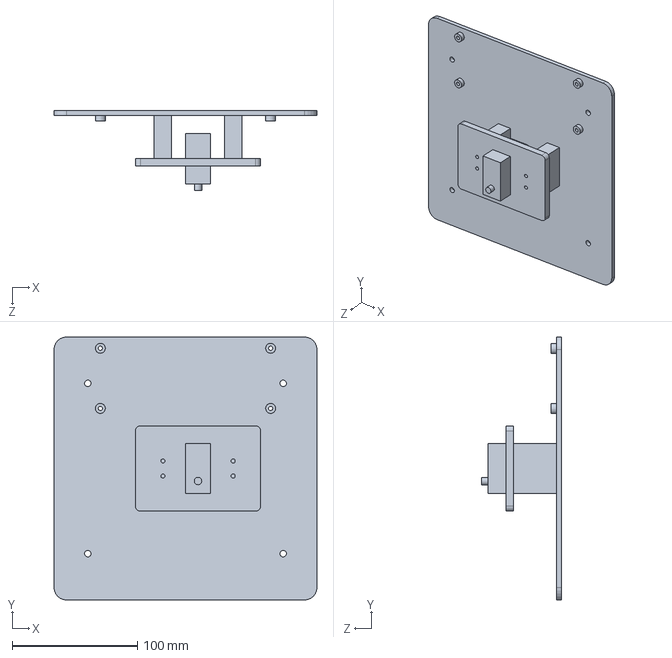
[picture p66: CAD file, 2026-11-08]
docs/diseno_v6/revision_R4/SOLIDWORKS_R4/Base_y_electronica.SLDPRT
210.0 x 210.0 x 63.5 mm
