HecVelaz/keepon-pro/docs/diseno_v6/revision_R4/STEP_V6/13_retencion_disco_balanceo.step

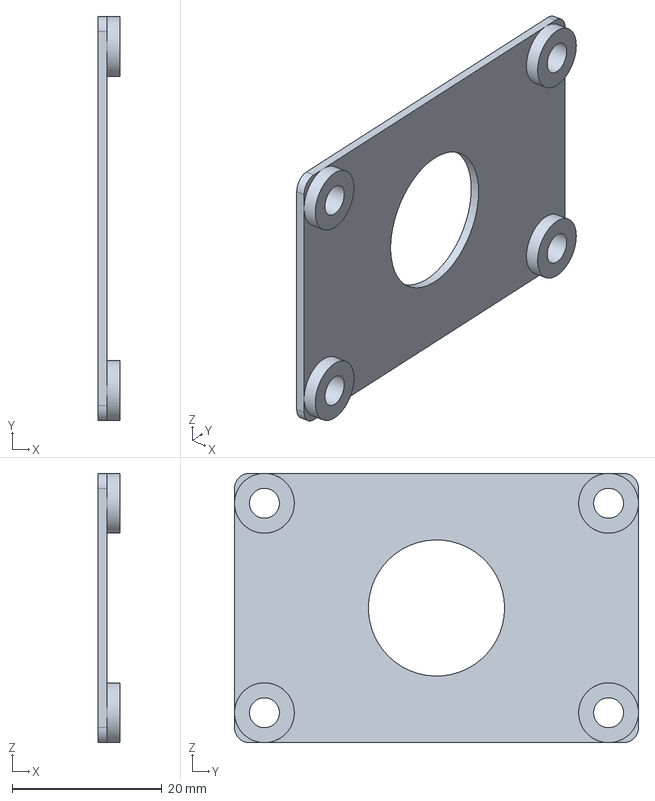
[picture p67: CAD file, 2026-11-08]
docs/diseno_v6/revision_R4/STEP_V6/13_retencion_disco_balanceo.step
3.00 x 54.0 x 36.0 mm
