HecVelaz/keepon-pro/docs/keepon_v4_cad/step/componentes/usb_c_bornera.step

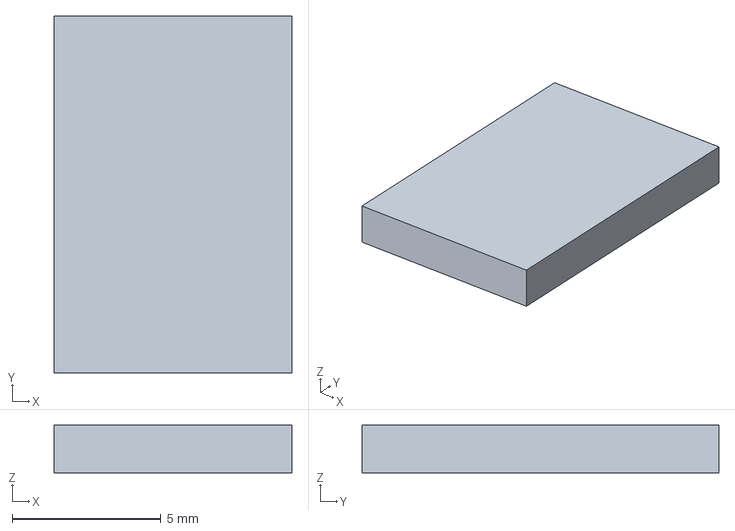
[picture p68: CAD file, 2026-10-14]
docs/keepon_v4_cad/step/componentes/usb_c_bornera.step
8.00 x 12.0 x 1.60 mm
