HecVelaz/keepon-pro/docs/cad_anteriores/keepon_v4_cad/step/componentes/pi5_pcb.step

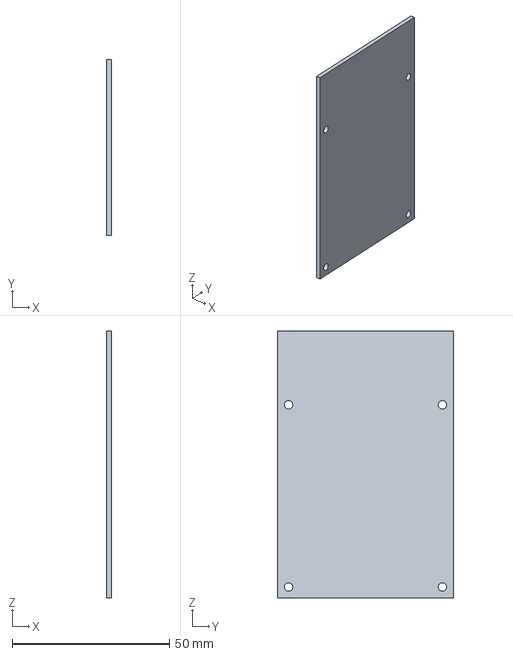
[picture p70: CAD file, 2026-10-14]
docs/cad_anteriores/keepon_v4_cad/step/componentes/pi5_pcb.step
1.60 x 56.0 x 85.0 mm
