HecVelaz/keepon-pro/docs/diseno_v6/revision_R4/SOLIDWORKS_R4/01_base_con_pilares.SLDPRT

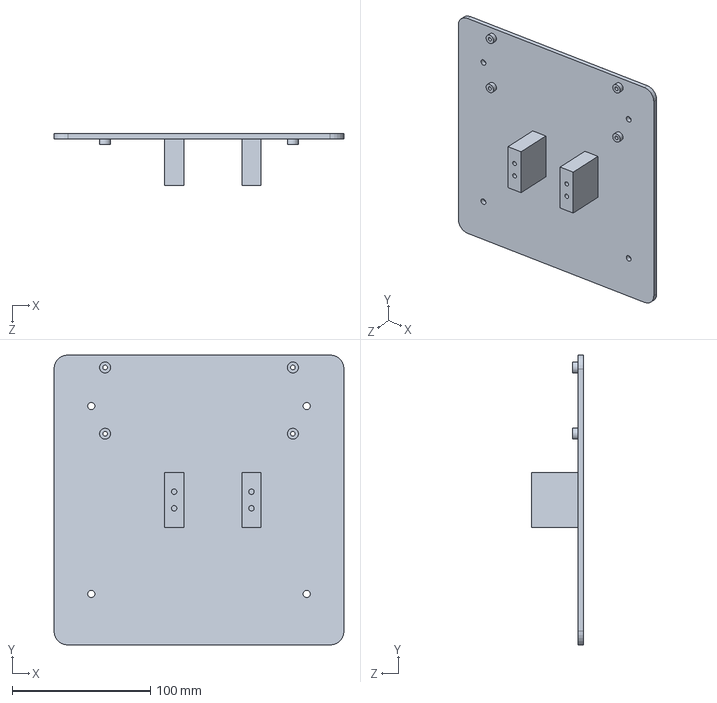
[picture p71: CAD file, 2026-11-08]
docs/diseno_v6/revision_R4/SOLIDWORKS_R4/01_base_con_pilares.SLDPRT
210.0 x 210.0 x 38.0 mm
