HecVelaz/keepon-pro/docs/diseno_v6/revision_R4/STEP_V6/11_retencion_brazo_doble_base.step

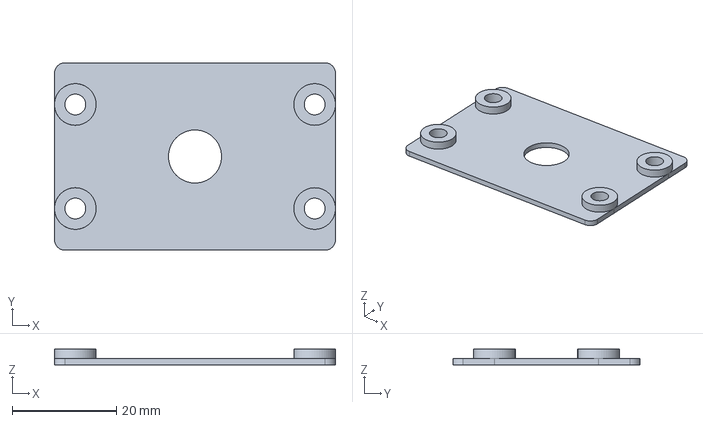
[picture p72: CAD file, 2026-11-08]
docs/diseno_v6/revision_R4/STEP_V6/11_retencion_brazo_doble_base.step
54.0 x 36.0 x 3.00 mm
