HecVelaz/keepon-pro/docs/keepon_v4_cad/step/componentes/bateria_zeee_3s_8000.step

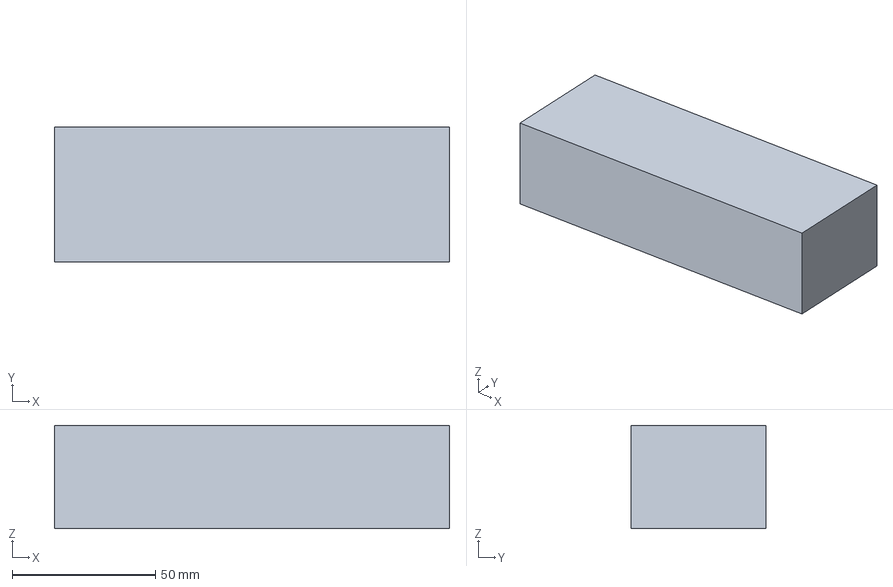
[picture p73: CAD file, 2026-10-14]
docs/keepon_v4_cad/step/componentes/bateria_zeee_3s_8000.step
138.0 x 47.0 x 36.0 mm
