HecVelaz/keepon-pro/docs/cad_anteriores/keepon_mg996r_step/5_separador_pivote.step

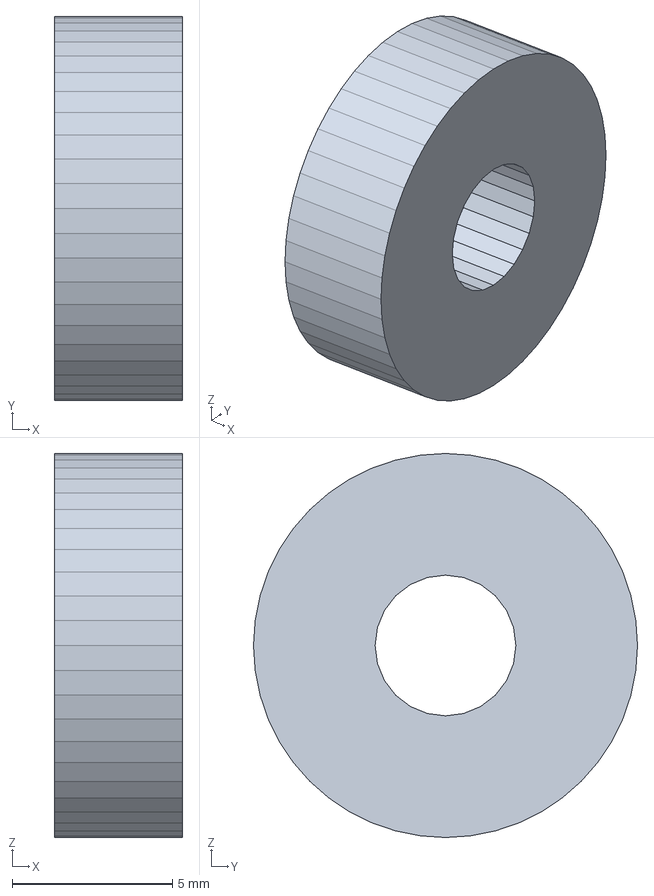
[picture p74: CAD file, 2026-10-14]
docs/cad_anteriores/keepon_mg996r_step/5_separador_pivote.step
4.00 x 12.0 x 12.0 mm
