HecVelaz/keepon-pro/docs/cad_anteriores/keepon_v4_cad/step/componentes/camara_pcb.step

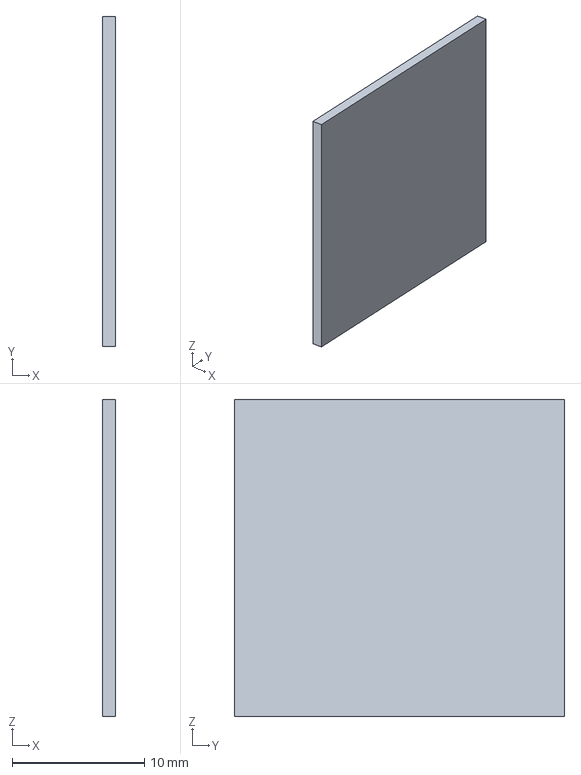
[picture p75: CAD file, 2026-10-14]
docs/cad_anteriores/keepon_v4_cad/step/componentes/camara_pcb.step
1.00 x 25.0 x 24.0 mm
