HecVelaz/keepon-pro/docs/diseno_v6/revision_R4/SOLIDWORKS_R4/09_abrazadera_ESP32.SLDPRT

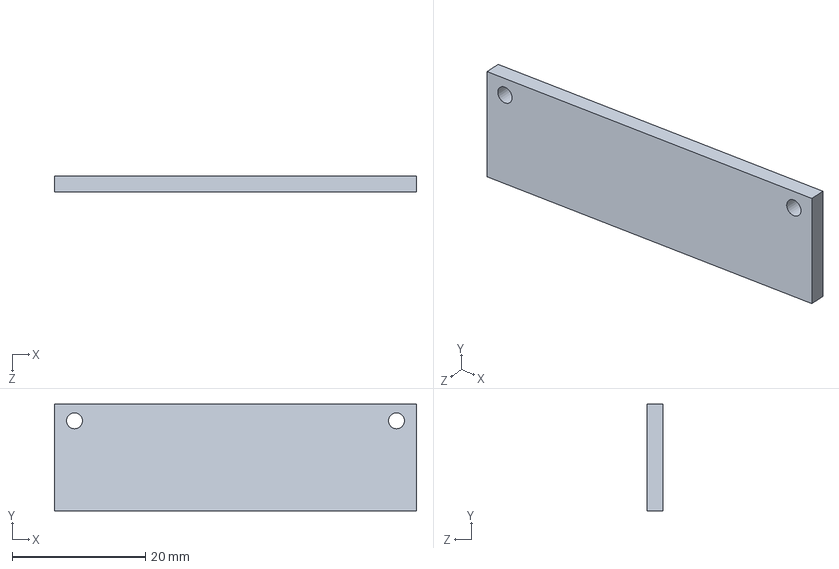
[picture p76: CAD file, 2026-11-08]
docs/diseno_v6/revision_R4/SOLIDWORKS_R4/09_abrazadera_ESP32.SLDPRT
54.3 x 16.0 x 2.40 mm
