HecVelaz/keepon-pro/docs/diseno_v6/revision_R4/STEP_V6/08_bandeja_de_electronica.step

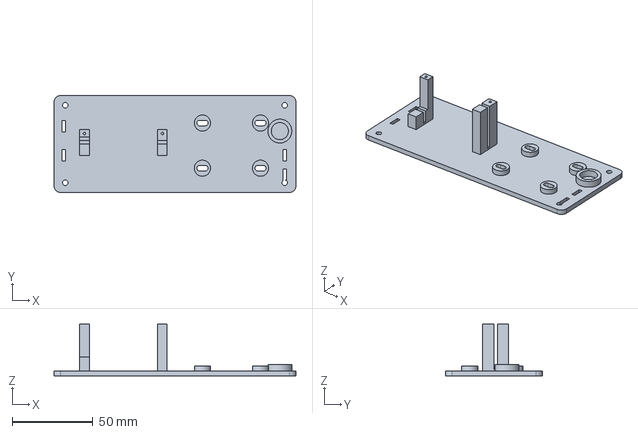
[picture p77: CAD file, 2026-11-08]
docs/diseno_v6/revision_R4/STEP_V6/08_bandeja_de_electronica.step
150.0 x 60.0 x 32.0 mm
