HecVelaz/keepon-pro/docs/cad_anteriores/keepon_mg996r_step/1_base.step

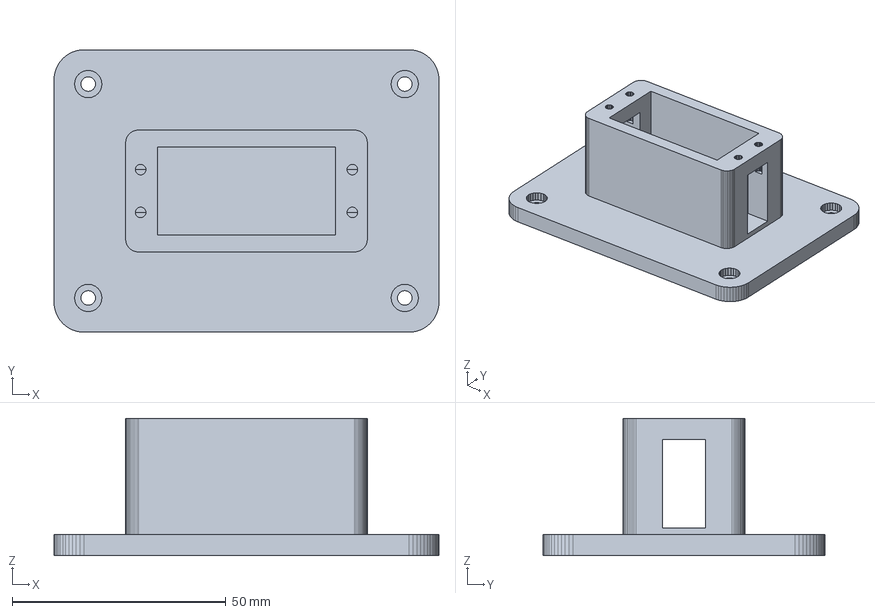
[picture p78: CAD file, 2026-10-14]
docs/cad_anteriores/keepon_mg996r_step/1_base.step
90.0 x 66.0 x 32.1 mm
