HecVelaz/keepon-pro/docs/cad_anteriores/keepon_v4_cad/step/componentes/esp32c3.step

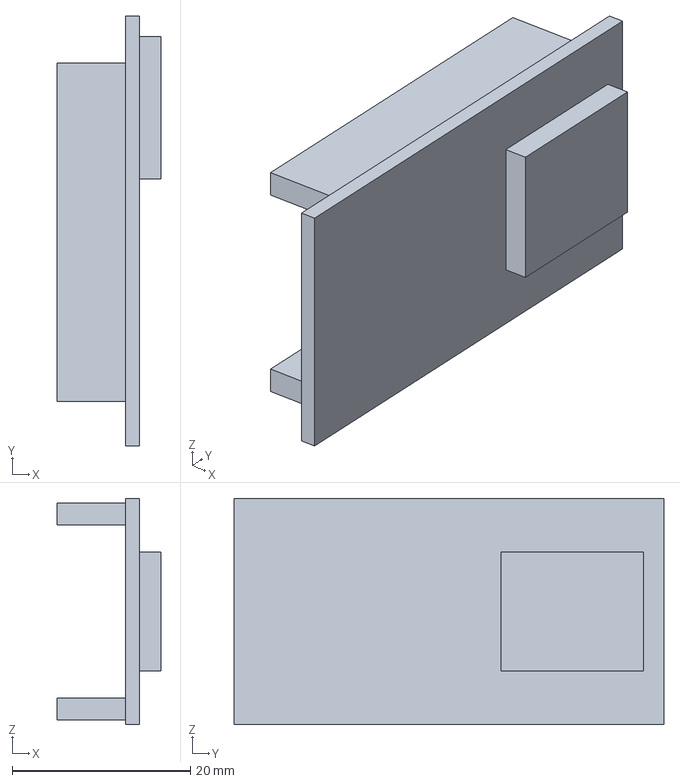
[picture p79: CAD file, 2026-10-14]
docs/cad_anteriores/keepon_v4_cad/step/componentes/esp32c3.step
11.7 x 48.3 x 25.4 mm
