HecVelaz/keepon-pro/docs/cad_anteriores/keepon_v4_cad/step/porta_esp32.step

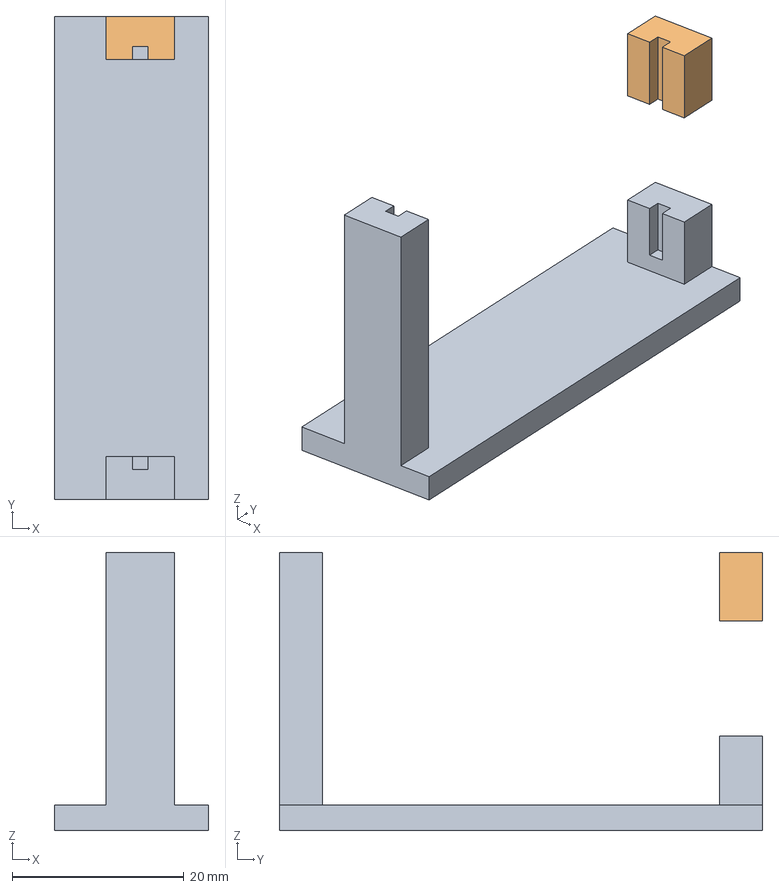
[picture p80: CAD file, 2026-10-14]
docs/cad_anteriores/keepon_v4_cad/step/porta_esp32.step
18.0 x 56.3 x 32.4 mm
