HecVelaz/keepon-pro/docs/diseno_v6/revision_R4/SOLIDWORKS_R4/04_carcasa_inferior_cabeza.SLDPRT

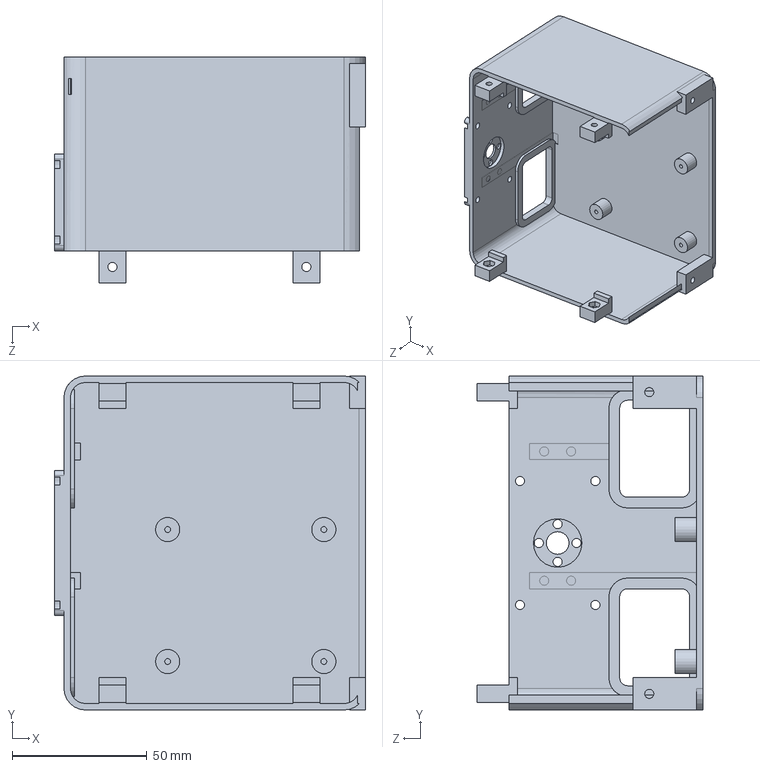
[picture p81: CAD file, 2026-11-08]
docs/diseno_v6/revision_R4/SOLIDWORKS_R4/04_carcasa_inferior_cabeza.SLDPRT
115.6 x 124.0 x 84.0 mm
