HecVelaz/keepon-pro/docs/diseno_v6/revision_R4/STEP_V6/R4_grupo_roll.step

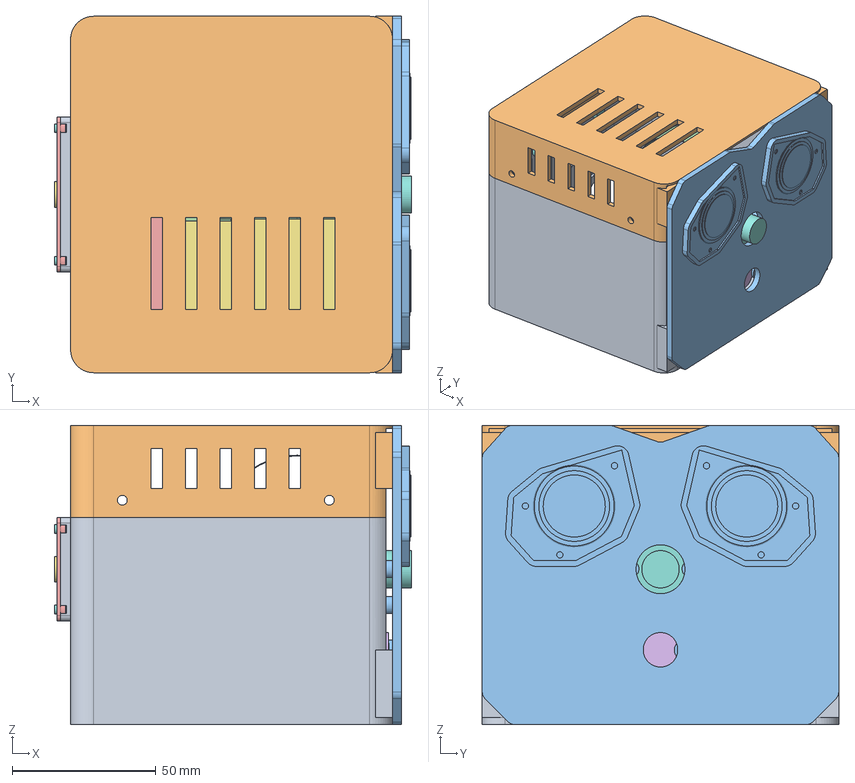
[picture p82: CAD file, 2026-11-08]
docs/diseno_v6/revision_R4/STEP_V6/R4_grupo_roll.step
124.2 x 124.0 x 104.0 mm
