HecVelaz/keepon-pro/docs/cad_anteriores/keepon_mg996r_step/2_soporte_pan_U.step

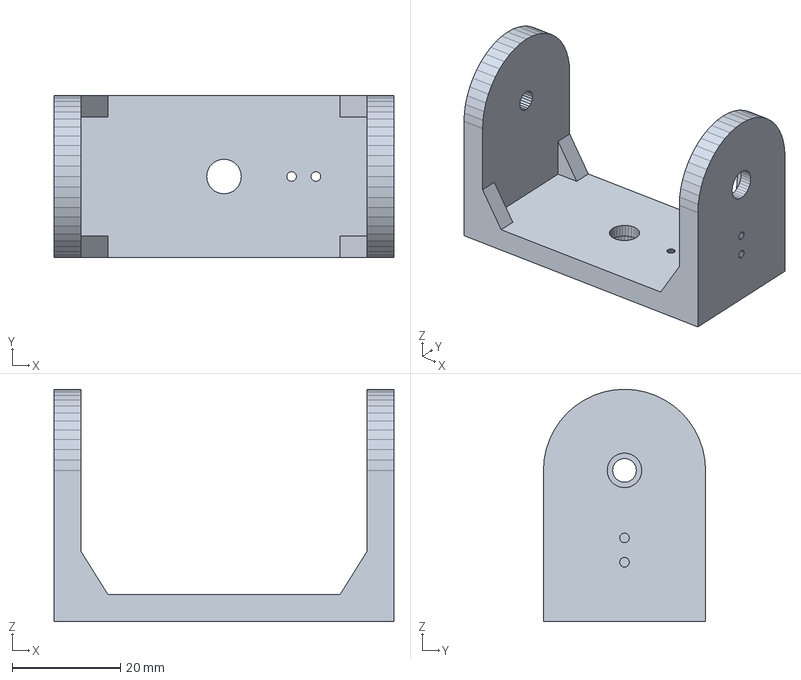
[picture p83: CAD file, 2026-10-14]
docs/cad_anteriores/keepon_mg996r_step/2_soporte_pan_U.step
62.9 x 30.0 x 43.0 mm
