HecVelaz/keepon-pro/docs/cad_anteriores/keepon_v4_cad/step/componentes/camara_conector.step

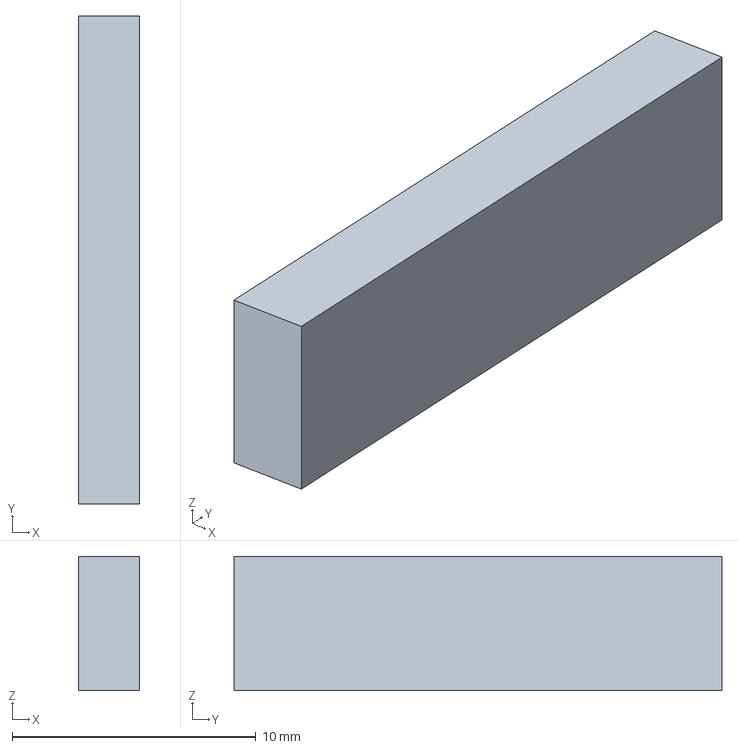
[picture p84: CAD file, 2026-10-14]
docs/cad_anteriores/keepon_v4_cad/step/componentes/camara_conector.step
2.50 x 20.0 x 5.50 mm
