HecVelaz/keepon-pro/docs/cad_anteriores/keepon_v4_cad/step/horquilla_cabeza.step

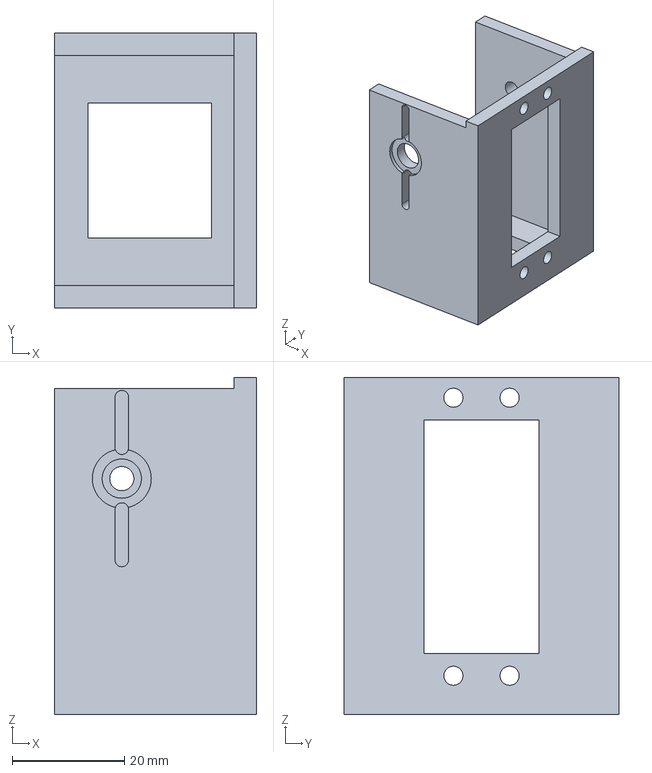
[picture p85: CAD file, 2026-10-14]
docs/cad_anteriores/keepon_v4_cad/step/horquilla_cabeza.step
36.0 x 49.0 x 60.0 mm
