HecVelaz/keepon-pro/docs/diseno_v6/revision_R4/SOLIDWORKS_R4/11_retencion_brazo_doble_base.SLDPRT

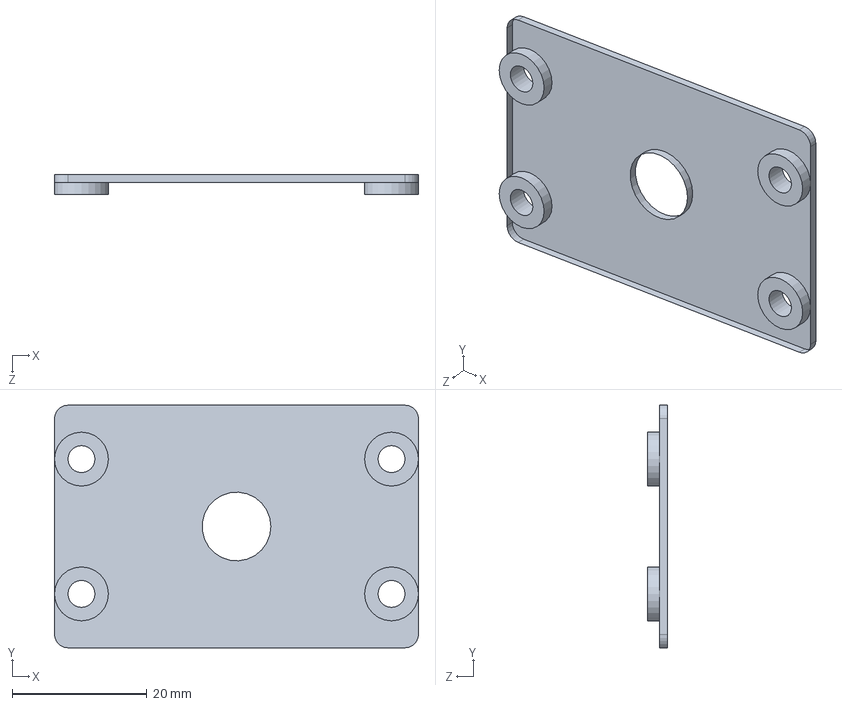
[picture p86: CAD file, 2026-11-08]
docs/diseno_v6/revision_R4/SOLIDWORKS_R4/11_retencion_brazo_doble_base.SLDPRT
54.0 x 36.0 x 3.00 mm
