HecVelaz/keepon-pro/docs/cad_anteriores/keepon_mg996r_step/4_placa_cabeza_roll.step

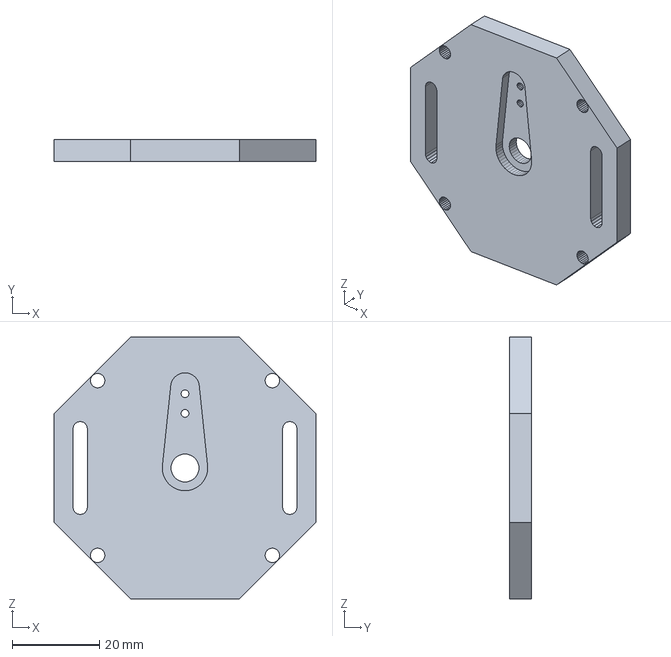
[picture p87: CAD file, 2026-10-14]
docs/cad_anteriores/keepon_mg996r_step/4_placa_cabeza_roll.step
60.0 x 5.00 x 60.0 mm
