HecVelaz/keepon-pro/docs/cad_anteriores/keepon_v4_cad/step/componentes/servo_roll_mg996r.step

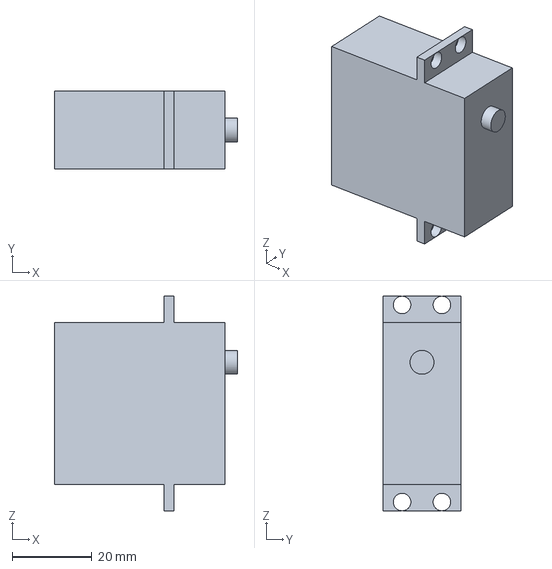
[picture p88: CAD file, 2026-10-14]
docs/cad_anteriores/keepon_v4_cad/step/componentes/servo_roll_mg996r.step
46.0 x 19.7 x 54.0 mm
