HecVelaz/keepon-pro/docs/cad_anteriores/keepon_v4_cad/step/plato_yaw.step

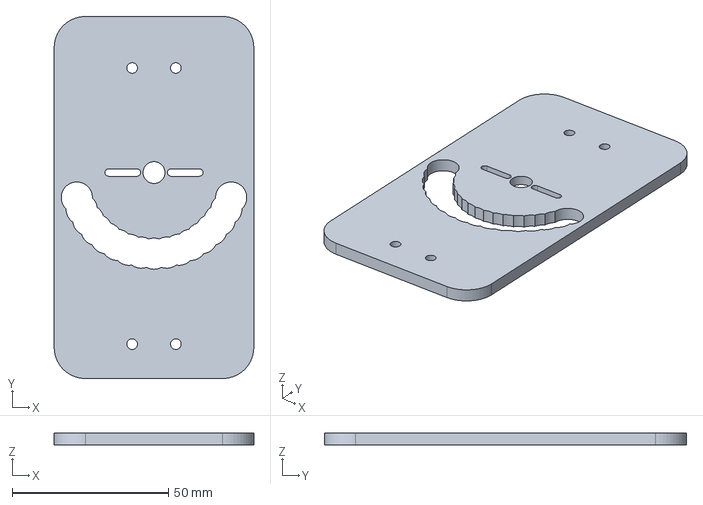
[picture p89: CAD file, 2026-10-14]
docs/cad_anteriores/keepon_v4_cad/step/plato_yaw.step
64.0 x 116.0 x 4.00 mm
