HecVelaz/keepon-pro/docs/diseno_v6/revision_R4/SOLIDWORKS_R4/02_horquilla_de_giro.SLDPRT

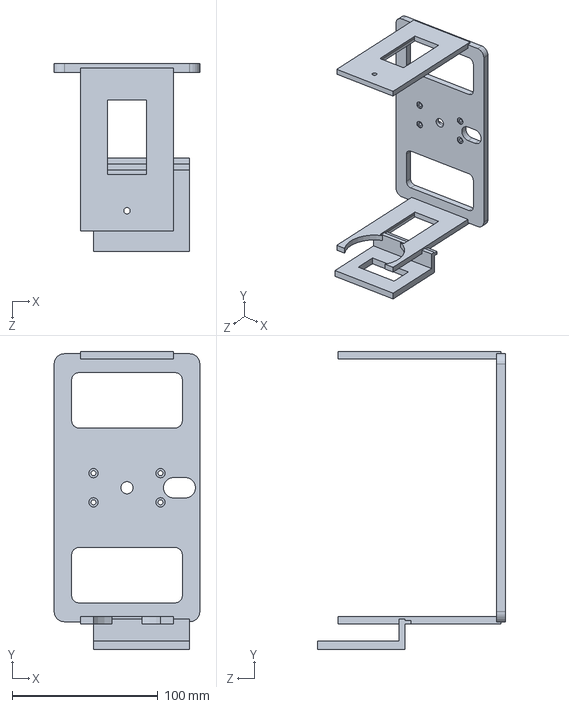
[picture p90: CAD file, 2026-11-08]
docs/diseno_v6/revision_R4/SOLIDWORKS_R4/02_horquilla_de_giro.SLDPRT
100.0 x 204.5 x 129.0 mm
