HecVelaz/keepon-pro/docs/cad_anteriores/keepon_v4_cad/step/componentes/servo_yaw_rds3218.step

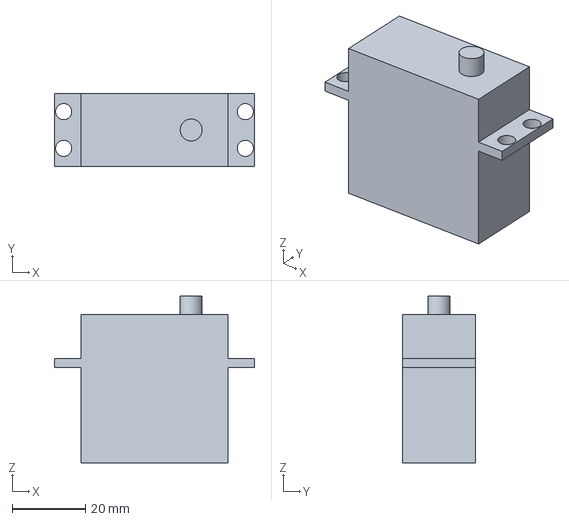
[picture p91: CAD file, 2026-10-14]
docs/cad_anteriores/keepon_v4_cad/step/componentes/servo_yaw_rds3218.step
54.5 x 20.0 x 45.5 mm
