HecVelaz/keepon-pro/docs/cad_anteriores/keepon_v4_cad/step/soporte_pitch_der.step

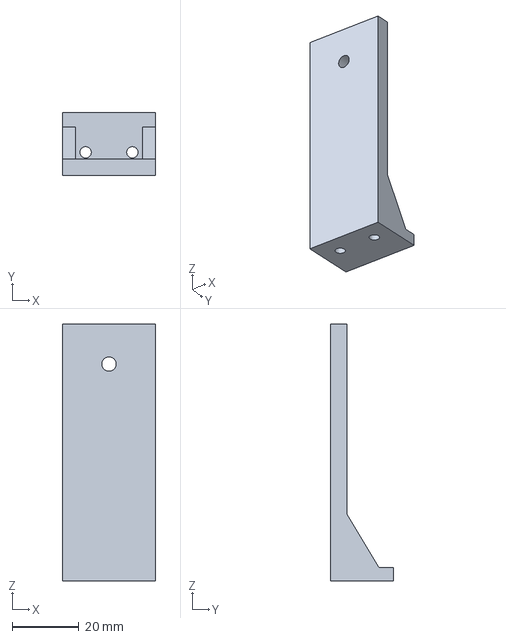
[picture p92: CAD file, 2026-10-14]
docs/cad_anteriores/keepon_v4_cad/step/soporte_pitch_der.step
28.0 x 19.0 x 77.0 mm
