HecVelaz/keepon-pro/docs/diseno_v6/revision_R4/SOLIDWORKS_R4/03_cuna_de_inclinacion.SLDPRT

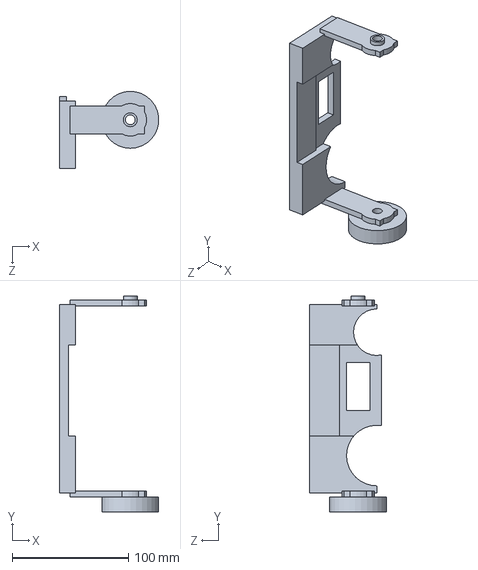
[picture p93: CAD file, 2026-11-08]
docs/diseno_v6/revision_R4/SOLIDWORKS_R4/03_cuna_de_inclinacion.SLDPRT
85.4 x 185.6 x 66.5 mm
