HecVelaz/keepon-pro/docs/diseno_v6/revision_R4/STEP_V6/10_soporte_centrado_servo_base.step

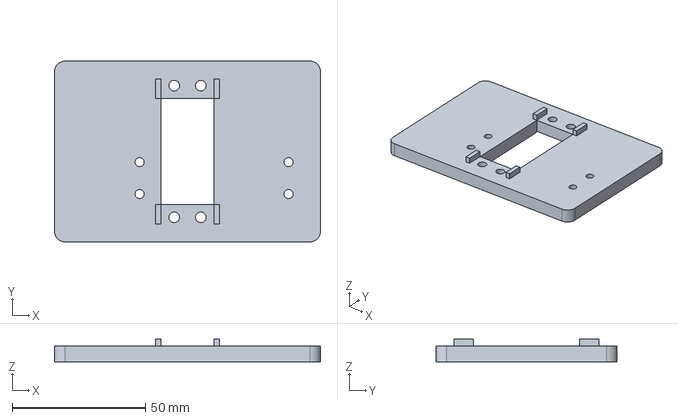
[picture p94: CAD file, 2026-11-08]
docs/diseno_v6/revision_R4/STEP_V6/10_soporte_centrado_servo_base.step
100.0 x 68.0 x 8.50 mm
