HecVelaz/keepon-pro/docs/cad_anteriores/keepon_v4_cad/step/caja_cabeza.step

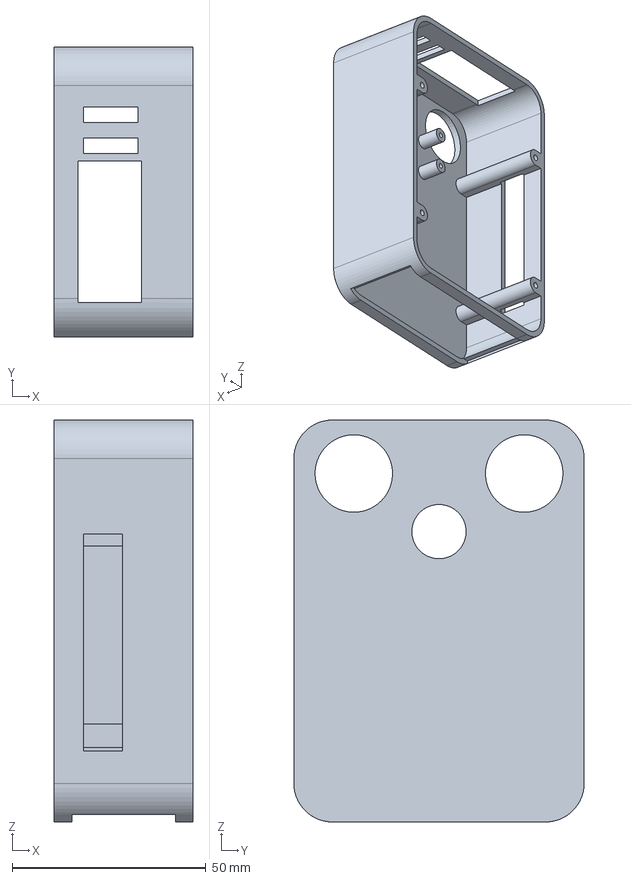
[picture p95: CAD file, 2026-10-14]
docs/cad_anteriores/keepon_v4_cad/step/caja_cabeza.step
35.8 x 75.0 x 103.8 mm
