HecVelaz/keepon-pro/docs/cad_anteriores/keepon_v4_cad/step/componentes/pi5_active_cooler.step

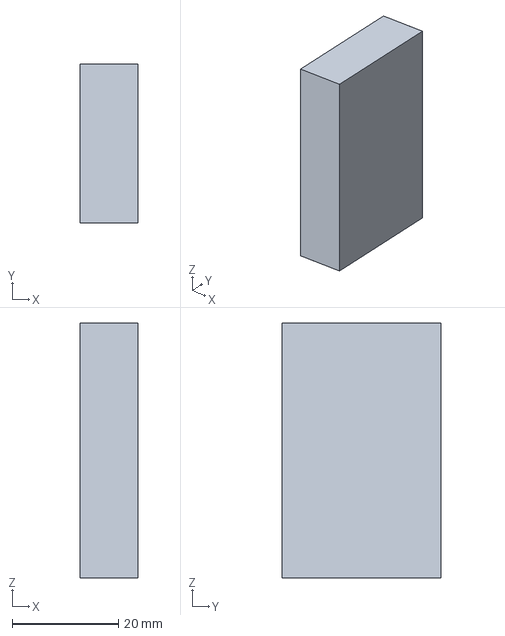
[picture p96: CAD file, 2026-10-14]
docs/cad_anteriores/keepon_v4_cad/step/componentes/pi5_active_cooler.step
11.0 x 30.0 x 48.0 mm
