HecVelaz/keepon-pro/docs/cad_anteriores/keepon_v4_cad/step/componentes/horn_pitch.step

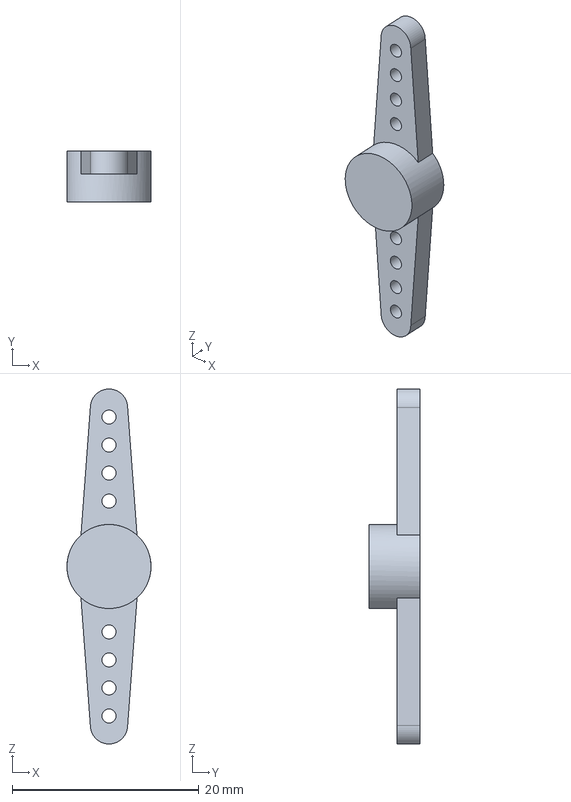
[picture p97: CAD file, 2026-10-14]
docs/cad_anteriores/keepon_v4_cad/step/componentes/horn_pitch.step
9.00 x 5.50 x 38.0 mm
