HecVelaz/keepon-pro/docs/cad_anteriores/keepon_v4_cad/step/ojo_der.step

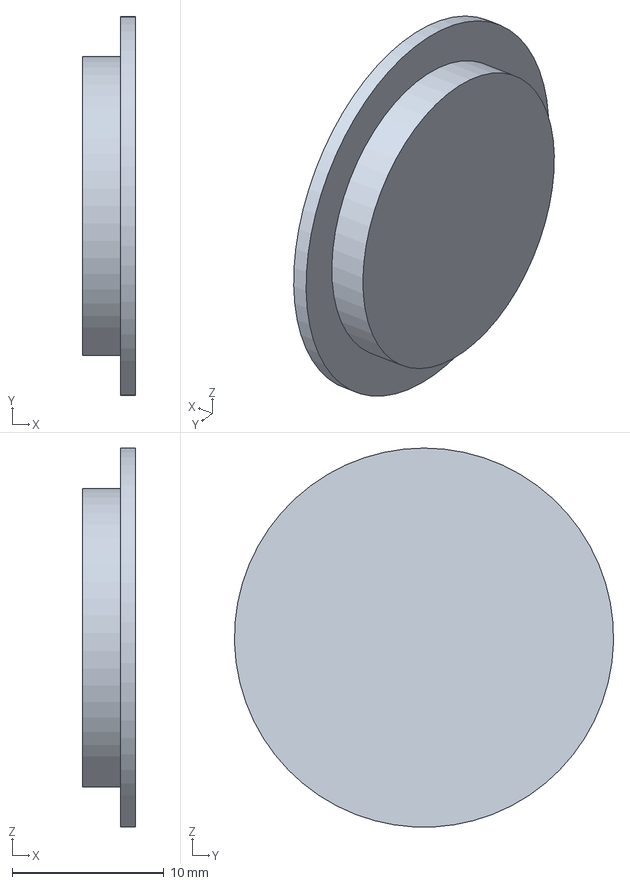
[picture p98: CAD file, 2026-10-14]
docs/cad_anteriores/keepon_v4_cad/step/ojo_der.step
3.50 x 25.0 x 25.0 mm
