HecVelaz/keepon-pro/docs/diseno_v6/revision_R4/SOLIDWORKS_R4/Horquilla_de_giro.SLDPRT

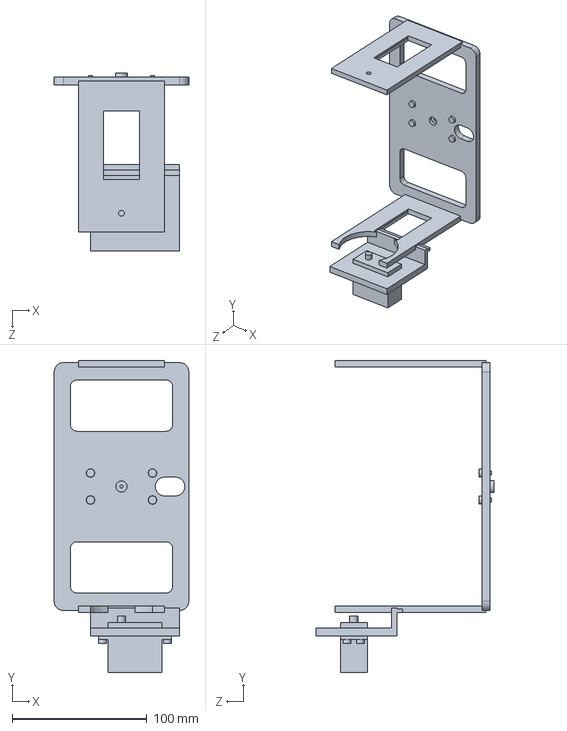
[picture p99: CAD file, 2026-11-08]
docs/diseno_v6/revision_R4/SOLIDWORKS_R4/Horquilla_de_giro.SLDPRT
100.0 x 231.5 x 132.0 mm
