HecVelaz/keepon-pro/docs/cad_anteriores/keepon_v4_cad/step/componentes/interruptor.step

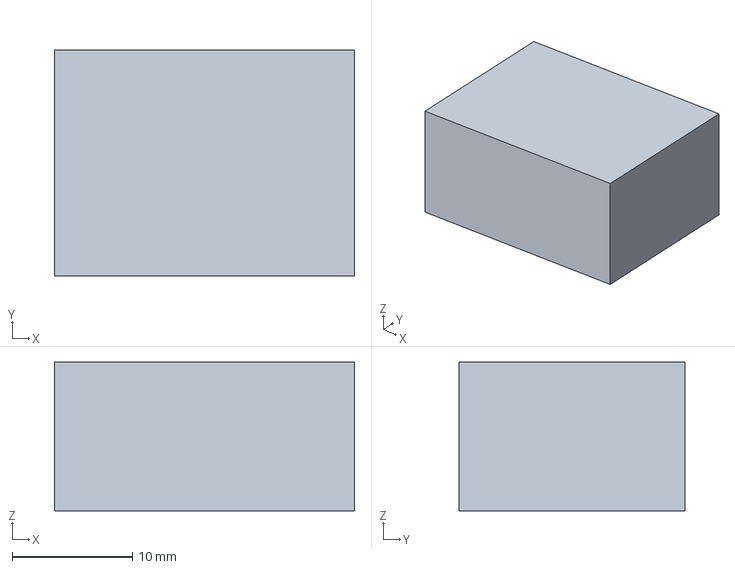
[picture p100: CAD file, 2026-10-14]
docs/cad_anteriores/keepon_v4_cad/step/componentes/interruptor.step
25.0 x 18.8 x 12.4 mm
