HecVelaz/keepon-pro/docs/cad_anteriores/keepon_v4_cad/step/tapa_base.step

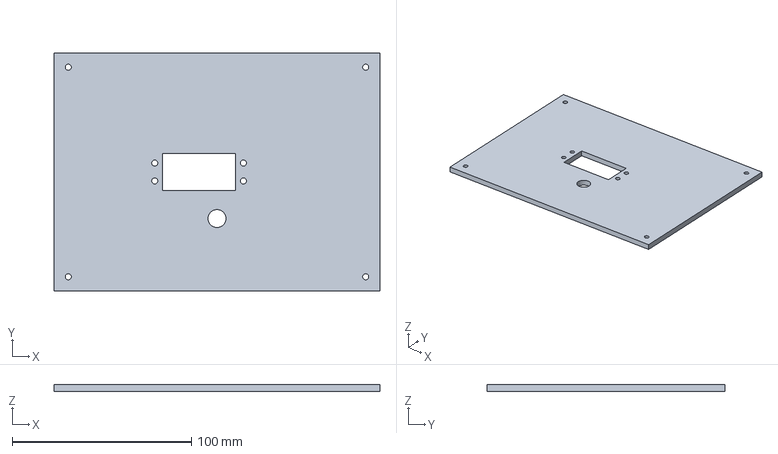
[picture p101: CAD file, 2026-10-14]
docs/cad_anteriores/keepon_v4_cad/step/tapa_base.step
182.0 x 133.0 x 4.00 mm
