HecVelaz/keepon-pro/docs/diseno_v6/revision_R4/SOLIDWORKS_R4/Cabeza_y_cara.SLDPRT

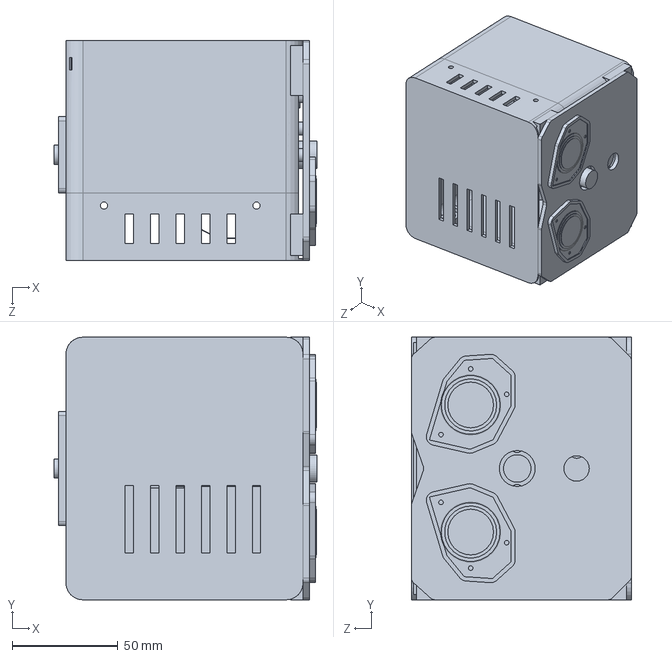
[picture p102: CAD file, 2026-11-08]
docs/diseno_v6/revision_R4/SOLIDWORKS_R4/Cabeza_y_cara.SLDPRT
124.2 x 124.0 x 104.0 mm
