HecVelaz/keepon-pro/docs/cad_anteriores/keepon_v4_cad/step/componentes/bornera_5v.step

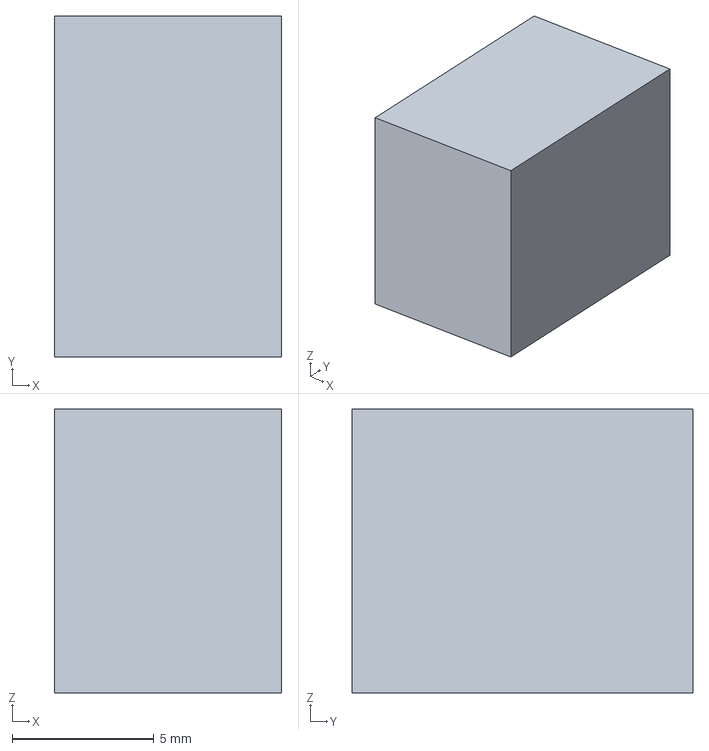
[picture p103: CAD file, 2026-10-14]
docs/cad_anteriores/keepon_v4_cad/step/componentes/bornera_5v.step
8.00 x 12.0 x 10.0 mm
