HecVelaz/keepon-pro/docs/diseno_v6/revision_R4/SOLIDWORKS_R4/Cuna_de_inclinacion.SLDPRT

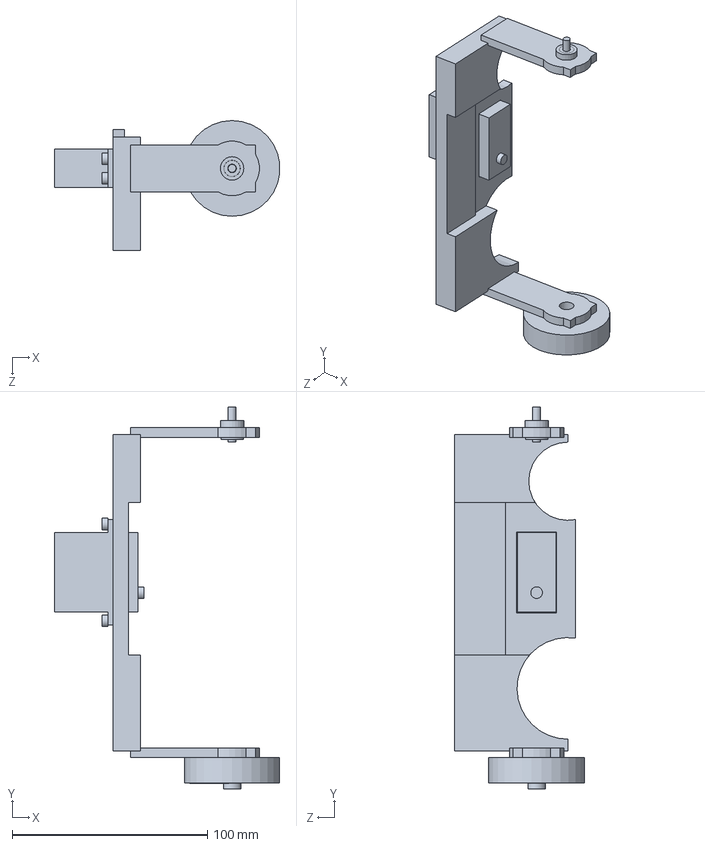
[picture p104: CAD file, 2026-11-08]
docs/diseno_v6/revision_R4/SOLIDWORKS_R4/Cuna_de_inclinacion.SLDPRT
115.4 x 195.5 x 66.5 mm
