HecVelaz/keepon-pro/docs/diseno_v6/revision_R4/STEP_V6/06_cara_con_ojos_integrados.step

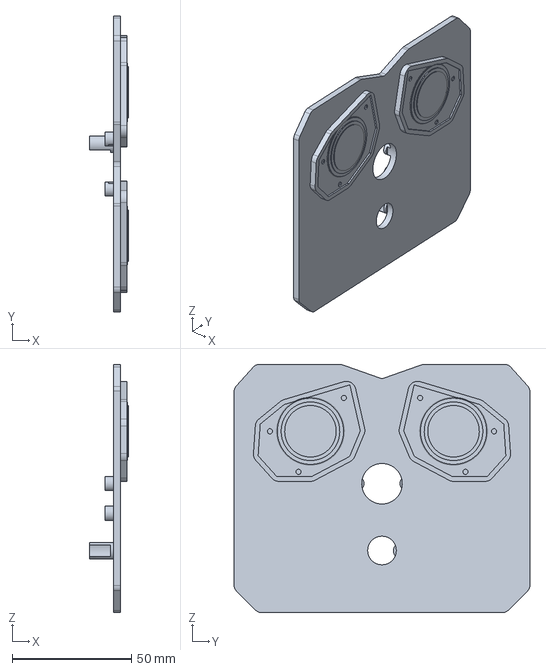
[picture p105: CAD file, 2026-11-08]
docs/diseno_v6/revision_R4/STEP_V6/06_cara_con_ojos_integrados.step
16.4 x 124.0 x 104.0 mm
