HecVelaz/keepon-pro/docs/cad_anteriores/keepon_v4_cad/step/componentes/cinta_ffc.step

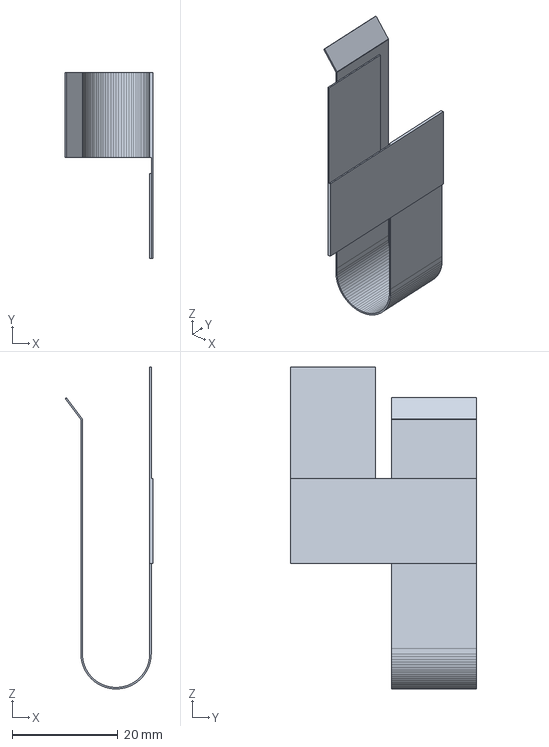
[picture p106: CAD file, 2026-10-14]
docs/cad_anteriores/keepon_v4_cad/step/componentes/cinta_ffc.step
16.6 x 35.1 x 60.8 mm
