HecVelaz/keepon-pro/docs/cad_anteriores/keepon_v4_cad/step/nariz_camara.step

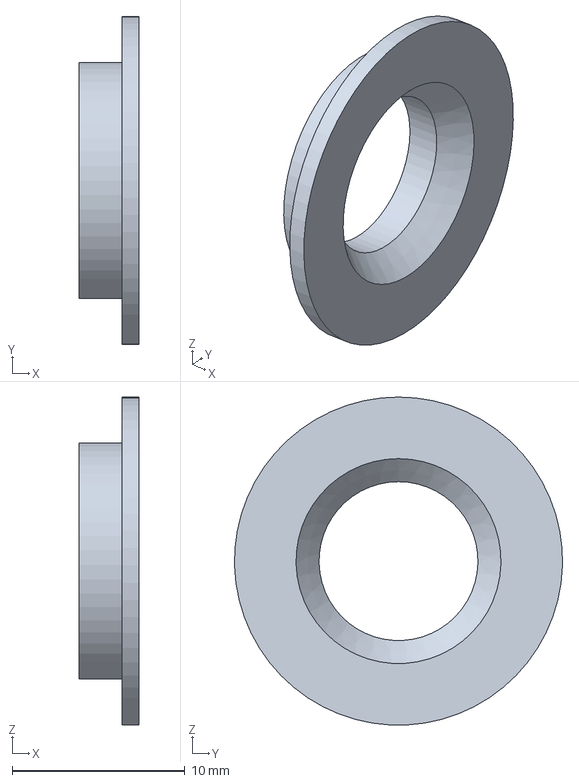
[picture p107: CAD file, 2026-10-14]
docs/cad_anteriores/keepon_v4_cad/step/nariz_camara.step
3.50 x 19.0 x 19.0 mm
