HecVelaz/keepon-pro/docs/cad_anteriores/keepon_v4_cad/step/componentes/bornes_fuente_6v.step

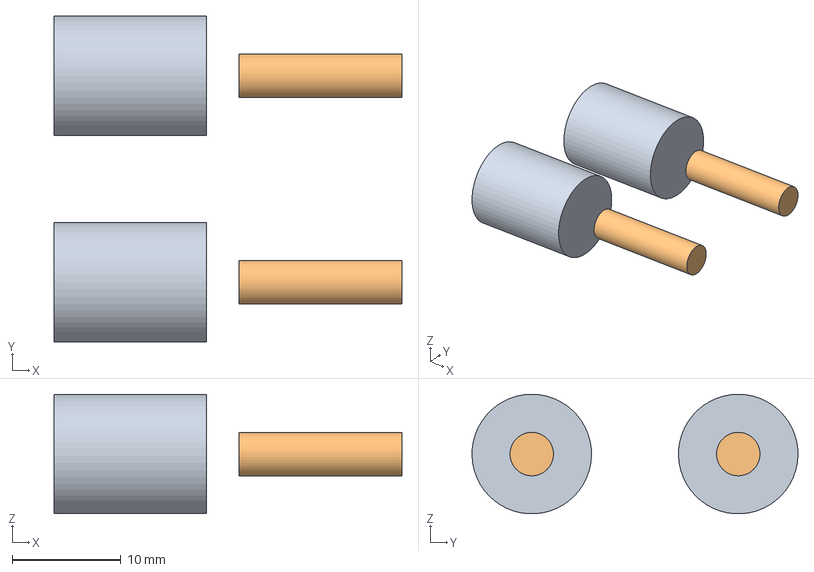
[picture p108: CAD file, 2026-10-14]
docs/cad_anteriores/keepon_v4_cad/step/componentes/bornes_fuente_6v.step
32.0 x 30.0 x 11.0 mm
