HecVelaz/keepon-pro/docs/cad_anteriores/keepon_v4_cad/step/placa_roll.step

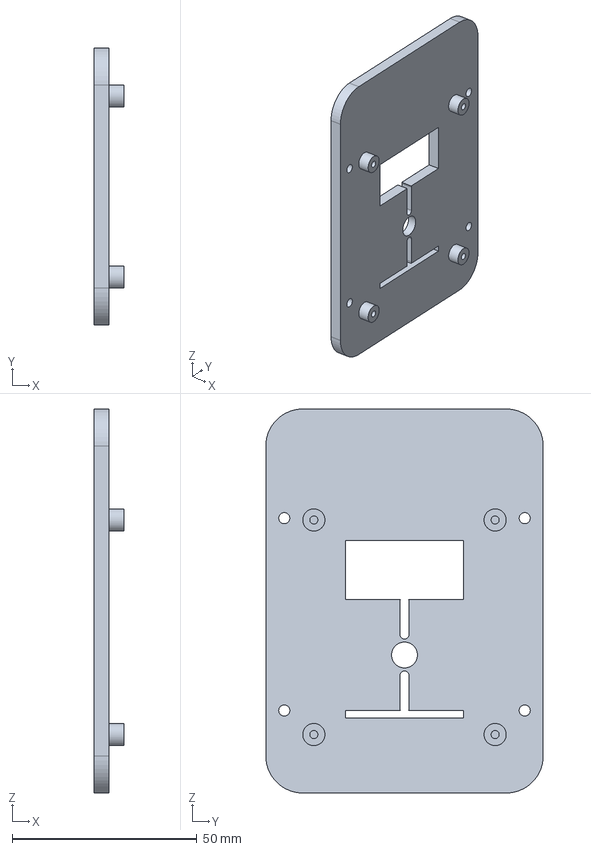
[picture p109: CAD file, 2026-10-14]
docs/cad_anteriores/keepon_v4_cad/step/placa_roll.step
8.00 x 75.0 x 103.8 mm
