HecVelaz/keepon-pro/docs/diseno_v6/revision_R4/STEP_V6/05_tapa_superior_ventilada.step

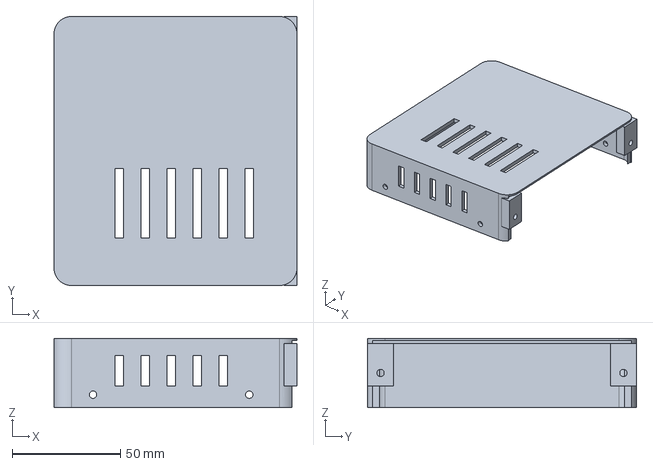
[picture p110: CAD file, 2026-11-08]
docs/diseno_v6/revision_R4/STEP_V6/05_tapa_superior_ventilada.step
112.0 x 124.0 x 32.0 mm
