HecVelaz/keepon-pro/docs/cad_anteriores/keepon_v4_cad/step/componentes/camara_lente.step

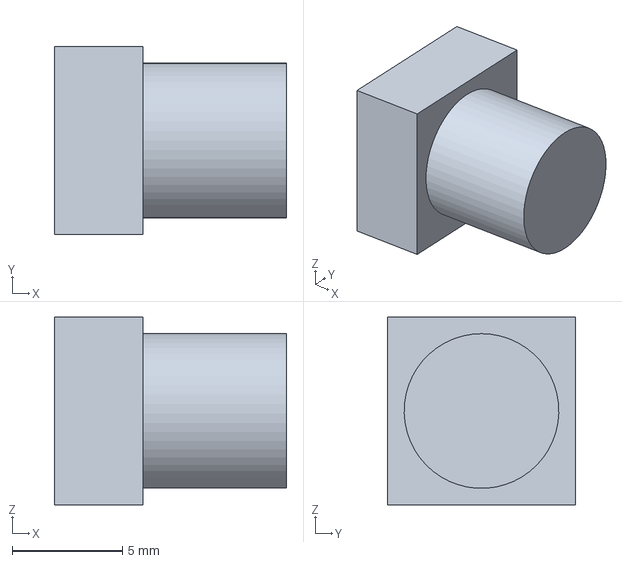
[picture p111: CAD file, 2026-10-14]
docs/cad_anteriores/keepon_v4_cad/step/componentes/camara_lente.step
10.5 x 8.50 x 8.50 mm
