HecVelaz/keepon-pro/docs/diseno_v6/revision_R4/STEP_V6/22_casquillo_extraible_pivote_inclinacion.step

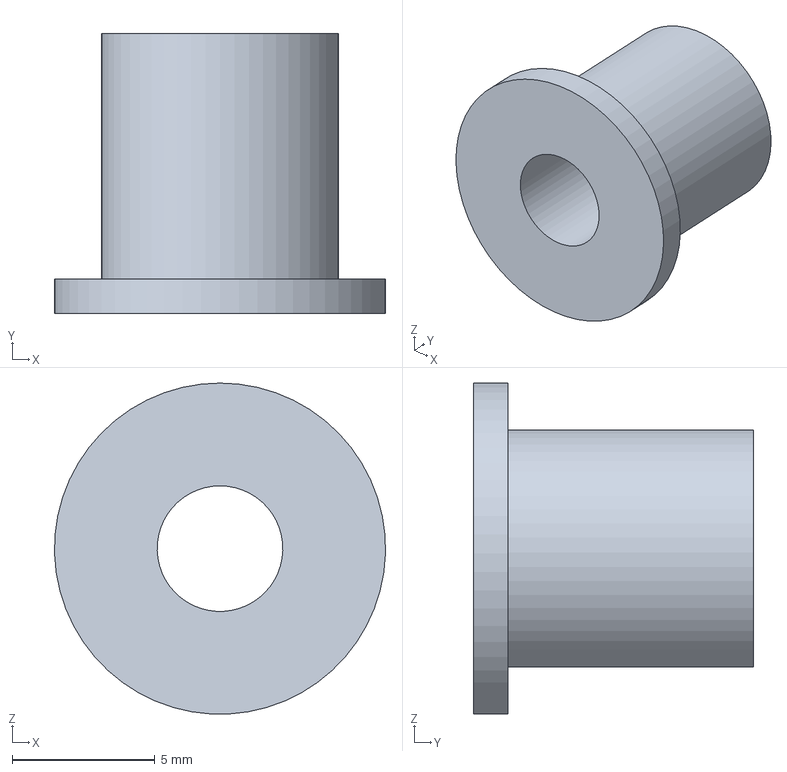
[picture p112: CAD file, 2026-11-08]
docs/diseno_v6/revision_R4/STEP_V6/22_casquillo_extraible_pivote_inclinacion.step
11.6 x 9.80 x 11.6 mm
