HecVelaz/keepon-pro/docs/cad_anteriores/keepon_v4_cad/step/componentes/capacitor_2200uf.step

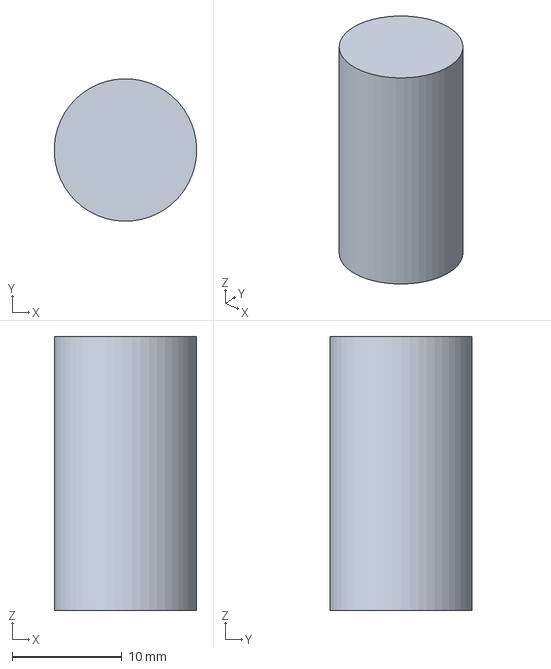
[picture p113: CAD file, 2026-10-14]
docs/cad_anteriores/keepon_v4_cad/step/componentes/capacitor_2200uf.step
13.0 x 13.0 x 25.0 mm
