HecVelaz/keepon-pro/docs/cad_anteriores/keepon_v4_cad/step/componentes/pi5_puertos.step

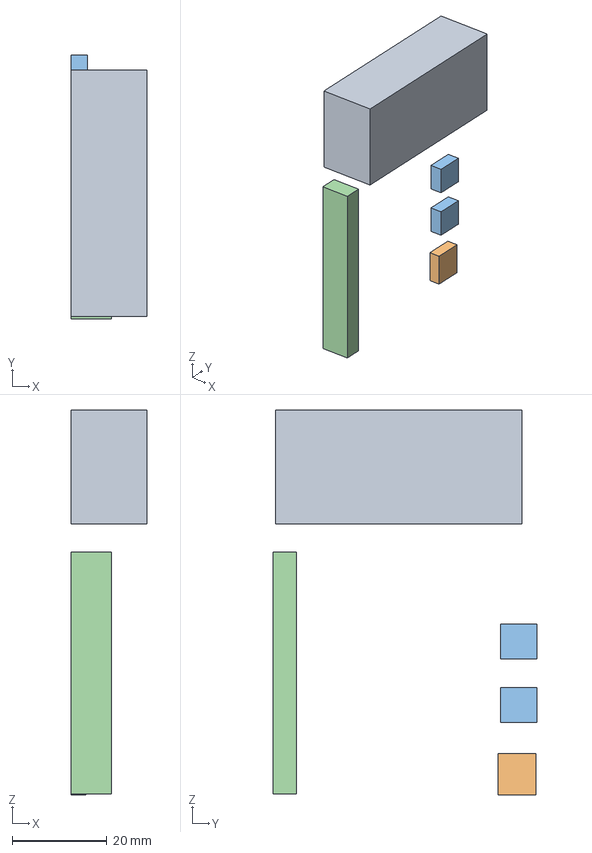
[picture p114: CAD file, 2026-10-14]
docs/cad_anteriores/keepon_v4_cad/step/componentes/pi5_puertos.step
16.0 x 55.7 x 81.2 mm
