HecVelaz/keepon-pro/docs/diseno_v6/revision_R4/STEP_V6/R4_grupo_yaw.step

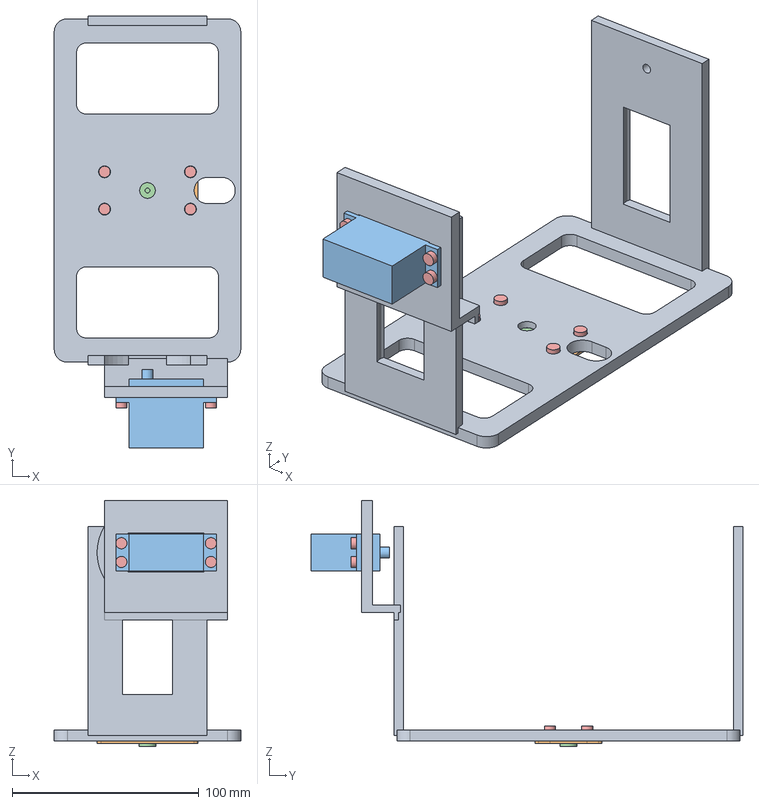
[picture p115: CAD file, 2026-11-08]
docs/diseno_v6/revision_R4/STEP_V6/R4_grupo_yaw.step
100.0 x 231.5 x 132.0 mm
