HecVelaz/keepon-pro/docs/diseno_v6/revision_R4/STEP_V6/R4_grupo_fixed.step

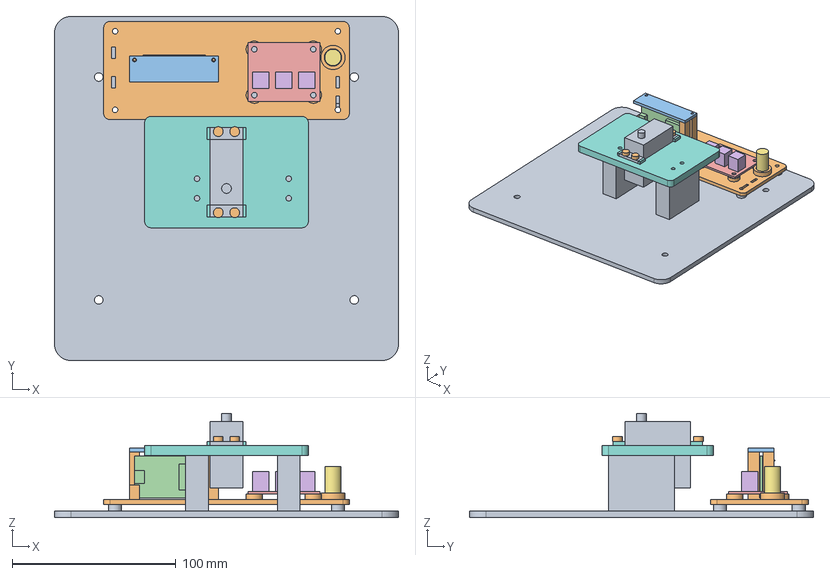
[picture p116: CAD file, 2026-11-08]
docs/diseno_v6/revision_R4/STEP_V6/R4_grupo_fixed.step
210.0 x 210.0 x 63.5 mm
