HecVelaz/keepon-pro/docs/cad_anteriores/keepon_v4_cad/step/componentes/horn_roll.step

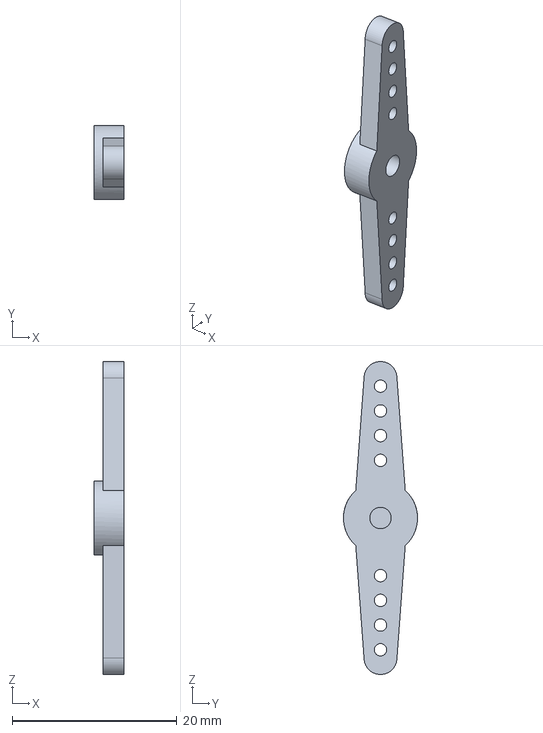
[picture p117: CAD file, 2026-10-14]
docs/cad_anteriores/keepon_v4_cad/step/componentes/horn_roll.step
3.60 x 9.00 x 38.0 mm
