HecVelaz/keepon-pro/docs/cad_anteriores/keepon_v4_cad/step/componentes/servo_pitch_hs7955tg.step

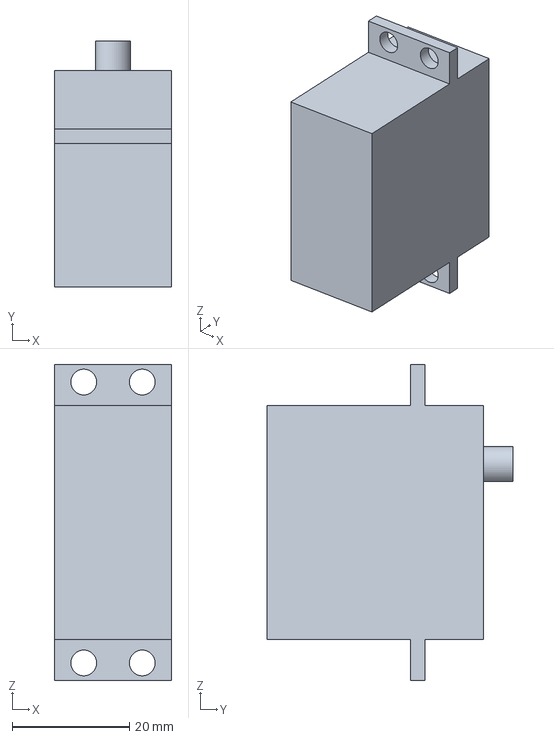
[picture p118: CAD file, 2026-10-14]
docs/cad_anteriores/keepon_v4_cad/step/componentes/servo_pitch_hs7955tg.step
20.0 x 42.0 x 54.0 mm
