HecVelaz/keepon-pro/docs/cad_anteriores/keepon_v4_cad/step/componentes/buzzer.step

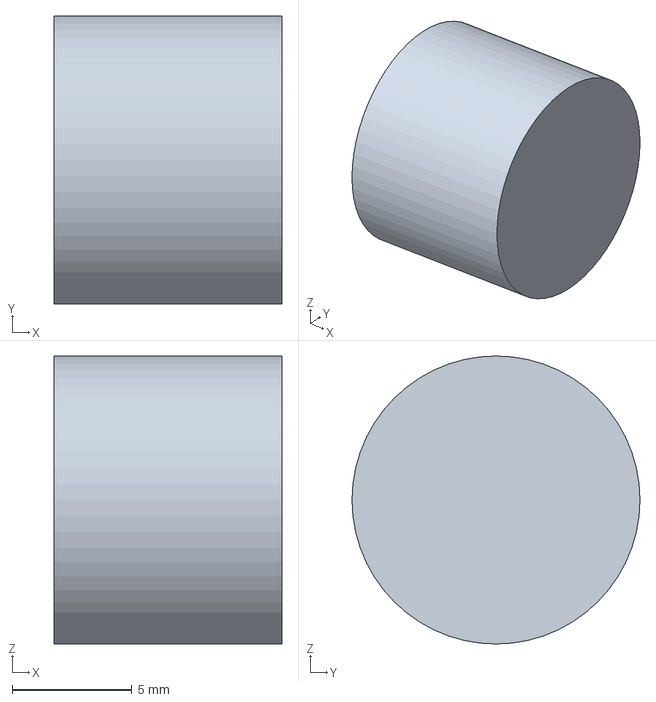
[picture p119: CAD file, 2026-10-14]
docs/cad_anteriores/keepon_v4_cad/step/componentes/buzzer.step
9.50 x 12.0 x 12.0 mm
