HecVelaz/keepon-pro/docs/cad_anteriores/keepon_v4_cad/step/componentes/powerbank_xiaomi_pb2020mi.step

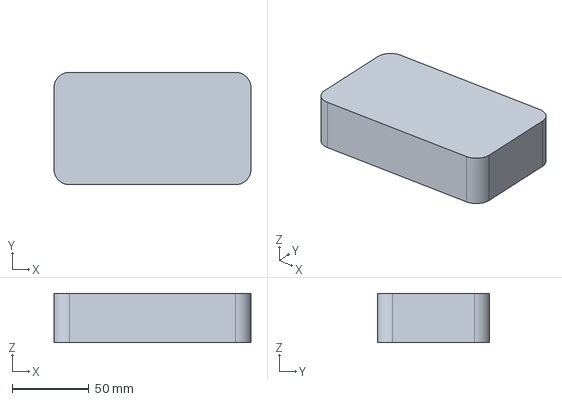
[picture p120: CAD file, 2026-10-14]
docs/cad_anteriores/keepon_v4_cad/step/componentes/powerbank_xiaomi_pb2020mi.step
128.0 x 73.0 x 32.0 mm
