HecVelaz/keepon-pro/docs/cad_anteriores/keepon_v4_cad/step/componentes/pi5_conectores_csi.step

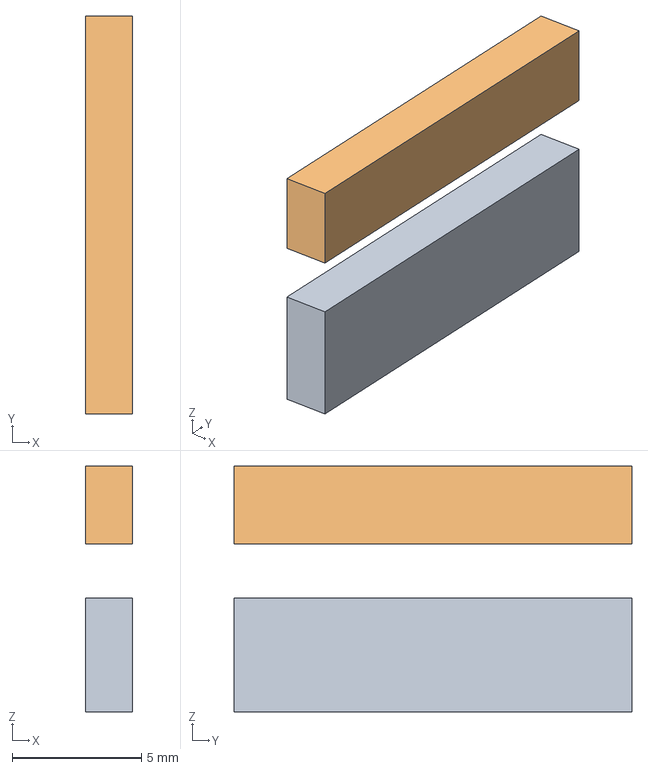
[picture p121: CAD file, 2026-10-14]
docs/cad_anteriores/keepon_v4_cad/step/componentes/pi5_conectores_csi.step
1.80 x 15.4 x 9.50 mm
