HecVelaz/keepon-pro/(list of files, cad)

Other CAD files:
docs/diseno_v6/revision_R4/STEP_V6/01_base_con_pilares.step
docs/diseno_v6/revision_R4/STEP_V6/04_carcasa_inferior_cabeza.step
docs/diseno_v6/revision_R4/SOLIDWORKS_R4/13_retencion_disco_balanceo.SLDPRT
docs/diseno_v6/revision_R4/STEP_V6/09_abrazadera_ESP32.step
docs/diseno_v6/revision_R4/STEP_V6/03_cuna_de_inclinacion.step
docs/diseno_v6/revision_R4/STEP_V6/02_horquilla_de_giro.step
docs/cad_anteriores/keepon_v4_cad/step/ojo_izq.step
docs/diseno_v6/revision_R4/SOLIDWORKS_R4/10_soporte_centrado_servo_base.SLDPRT
docs/diseno_v6/revision_R4/SOLIDWORKS_R4/08_bandeja_de_electronica.SLDPRT
docs/diseno_v6/revision_R4/SOLIDWORKS_R4/06_cara_con_ojos_integrados.SLDPRT
docs/diseno_v6/revision_R4/SOLIDWORKS_R4/22_casquillo_extraible_pivote_inclinacion.SLDPRT
docs/diseno_v6/revision_R4/STEP_V6/R4_grupo_pitch.step
docs/cad_anteriores/keepon_v4_cad/step/componentes/horn_yaw.step
docs/diseno_v6/revision_R4/SOLIDWORKS_R4/05_tapa_superior_ventilada.SLDPRT
docs/cad_anteriores/keepon_v2_cad/step/cabeza_der.step
docs/cad_anteriores/keepon_v2_cad/step/cabeza_izq.step
docs/cad_anteriores/keepon_v2_cad/step/caja_base.step
docs/cad_anteriores/keepon_v2_cad/step/cuerpo_der.step
docs/cad_anteriores/keepon_v2_cad/step/cuerpo_izq.step
docs/cad_anteriores/keepon_v2_cad/step/cuna_esp32.step
docs/cad_anteriores/keepon_v2_cad/step/horquilla_cabeza.step
docs/cad_anteriores/keepon_v2_cad/step/keepon_v2_ensamble.step
docs/cad_anteriores/keepon_v2_cad/step/ojo_der.step
docs/cad_anteriores/keepon_v2_cad/step/ojo_izq.step
docs/cad_anteriores/keepon_v2_cad/step/placa_cabeza.step
docs/cad_anteriores/keepon_v2_cad/step/plato_yaw.step
docs/cad_anteriores/keepon_v2_cad/step/porta_buzzer.step
docs/cad_anteriores/keepon_v2_cad/step/soporte_pitch_der.step
docs/cad_anteriores/keepon_v2_cad/step/soporte_pitch_izq.step
docs/cad_anteriores/keepon_v2_cad/step/tapa_base.step
docs/cad_anteriores/keepon_v2_cad/stl/cabeza_der.stl
docs/cad_anteriores/keepon_v2_cad/stl/cabeza_izq.stl
docs/cad_anteriores/keepon_v2_cad/stl/caja_base.stl
docs/cad_anteriores/keepon_v2_cad/stl/cuerpo_der.stl
docs/cad_anteriores/keepon_v2_cad/stl/cuerpo_izq.stl
docs/cad_anteriores/keepon_v2_cad/stl/cuna_esp32.stl
docs/cad_anteriores/keepon_v2_cad/stl/horquilla_cabeza.stl
docs/cad_anteriores/keepon_v2_cad/stl/ojo_der.stl
docs/cad_anteriores/keepon_v2_cad/stl/ojo_izq.stl
docs/cad_anteriores/keepon_v2_cad/stl/placa_cabeza.stl
docs/cad_anteriores/keepon_v2_cad/stl/plato_yaw.stl
docs/cad_anteriores/keepon_v2_cad/stl/porta_buzzer.stl
docs/cad_anteriores/keepon_v2_cad/stl/soporte_pitch_der.stl
docs/cad_anteriores/keepon_v2_cad/stl/soporte_pitch_izq.stl
docs/cad_anteriores/keepon_v2_cad/stl/tapa_base.stl
docs/cad_anteriores/keepon_v3_cad/step/caja_base.step
docs/cad_anteriores/keepon_v3_cad/step/caja_cabeza.step
docs/cad_anteriores/keepon_v3_cad/step/componentes/bateria_lipo_3s.step
docs/cad_anteriores/keepon_v3_cad/step/componentes/buzzer.step
docs/cad_anteriores/keepon_v3_cad/step/componentes/camara_conector.step
docs/cad_anteriores/keepon_v3_cad/step/componentes/camara_lente.step
docs/cad_anteriores/keepon_v3_cad/step/componentes/camara_pcb.step
docs/cad_anteriores/keepon_v3_cad/step/componentes/cinta_ffc.step
docs/cad_anteriores/keepon_v3_cad/step/componentes/esp32c3.step
docs/cad_anteriores/keepon_v3_cad/step/componentes/horn_pitch.step
docs/cad_anteriores/keepon_v3_cad/step/componentes/horn_roll.step
docs/cad_anteriores/keepon_v3_cad/step/componentes/horn_yaw.step
docs/cad_anteriores/keepon_v3_cad/step/componentes/interruptor.step
docs/cad_anteriores/keepon_v3_cad/step/componentes/pi5_active_cooler.step
docs/cad_anteriores/keepon_v3_cad/step/componentes/pi5_conectores_csi.step
docs/cad_anteriores/keepon_v3_cad/step/componentes/pi5_pcb.step
docs/cad_anteriores/keepon_v3_cad/step/componentes/pi5_puertos.step
docs/cad_anteriores/keepon_v3_cad/step/componentes/regulador_5v_5a.step
docs/cad_anteriores/keepon_v3_cad/step/componentes/regulador_6v_20a.step
docs/cad_anteriores/keepon_v3_cad/step/componentes/servo_pitch_hs7955tg.step
docs/cad_anteriores/keepon_v3_cad/step/componentes/servo_roll_mg996r.step
docs/cad_anteriores/keepon_v3_cad/step/componentes/servo_yaw_rds3218.step
docs/cad_anteriores/keepon_v3_cad/step/cuna_esp32.step
docs/cad_anteriores/keepon_v3_cad/step/horquilla_cabeza.step
docs/cad_anteriores/keepon_v3_cad/step/keepon_v3_componentes.step
docs/cad_anteriores/keepon_v3_cad/step/keepon_v3_ensamble.step
docs/cad_anteriores/keepon_v3_cad/step/nariz_camara.step
docs/cad_anteriores/keepon_v3_cad/step/ojo_der.step
docs/cad_anteriores/keepon_v3_cad/step/ojo_izq.step
docs/cad_anteriores/keepon_v3_cad/step/placa_roll.step
docs/cad_anteriores/keepon_v3_cad/step/plato_yaw.step
docs/cad_anteriores/keepon_v3_cad/step/porta_buzzer.step
docs/cad_anteriores/keepon_v3_cad/step/soporte_pitch_der.step
docs/cad_anteriores/keepon_v3_cad/step/soporte_pitch_izq.step
docs/cad_anteriores/keepon_v3_cad/step/tapa_base.step
docs/cad_anteriores/keepon_v3_cad/stl/caja_base.stl
docs/cad_anteriores/keepon_v3_cad/stl/caja_cabeza.stl
docs/cad_anteriores/keepon_v3_cad/stl/cuna_esp32.stl
docs/cad_anteriores/keepon_v3_cad/stl/horquilla_cabeza.stl
docs/cad_anteriores/keepon_v3_cad/stl/nariz_camara.stl
docs/cad_anteriores/keepon_v3_cad/stl/ojo_der.stl
docs/cad_anteriores/keepon_v3_cad/stl/ojo_izq.stl
docs/cad_anteriores/keepon_v3_cad/stl/placa_roll.stl
docs/cad_anteriores/keepon_v3_cad/stl/plato_yaw.stl
docs/cad_anteriores/keepon_v3_cad/stl/porta_buzzer.stl
docs/cad_anteriores/keepon_v3_cad/stl/soporte_pitch_der.stl
docs/cad_anteriores/keepon_v3_cad/stl/soporte_pitch_izq.stl
docs/cad_anteriores/keepon_v3_cad/stl/tapa_base.stl
docs/cad_anteriores/keepon_v4_cad/stl/caja_base.stl
docs/cad_anteriores/keepon_v4_cad/stl/caja_cabeza.stl
docs/cad_anteriores/keepon_v4_cad/stl/horquilla_cabeza.stl
docs/cad_anteriores/keepon_v4_cad/stl/nariz_camara.stl
docs/cad_anteriores/keepon_v4_cad/stl/ojo_der.stl
docs/cad_anteriores/keepon_v4_cad/stl/ojo_izq.stl
docs/cad_anteriores/keepon_v4_cad/stl/placa_roll.stl
docs/cad_anteriores/keepon_v4_cad/stl/plato_yaw.stl
docs/cad_anteriores/keepon_v4_cad/stl/porta_esp32.stl
docs/cad_anteriores/keepon_v4_cad/stl/soporte_pitch_der.stl
docs/cad_anteriores/keepon_v4_cad/stl/soporte_pitch_izq.stl
docs/cad_anteriores/keepon_v4_cad/stl/tapa_base.stl
docs/keepon_v3_cad/step/ojo_camara.step
docs/keepon_v3_cad/step/ojo_otro.step
