HecVelaz/keepon-pro/pruebas_buzzer/simulador_sonidos.html

Keepon pro · buzzer pasivo en GPIO5 · LEDC

# Simulador de sonidos del buzzer

Cada sonido es una tabla de segmentos {f_inicio, f_fin, ms}, el mismo formato que va a usar el firmware de la ESP32. El navegador lo toca con onda cuadrada y actualiza la frecuencia de los barridos cada pocos milisegundos, igual que ledcWriteTone(). Editá la tabla, escuchala y copiá el código C de abajo.

Volumen 35 % Simular la respuesta del buzzer Resonancia 2500 Hz Paso de barrido 5 ms

Reproducir Detener Restaurar el original

Tabla de segmentos

Formato

1800 3200 90 barrido de 1800 a 3200 Hz en 90 ms

2600 45 nota fija de 2600 Hz, 45 ms

A5 230 nota por nombre (A4 = 440 Hz; también C#6, Bb5)

- 30 silencio de 30 ms

; separa varios segmentos en una línea

# comentario hasta el final de la línea

El buzzer suena más fuerte cerca de su resonancia (franja sombreada) y débil por debajo de ~500 Hz.

## Para el firmware y config.yaml

Tablas en C (todos los sonidos)Copiar

DuracionesCopiar
