HecVelaz/keepon-pro/pruebas_servos/simulador_hs7955tg.html

# Prueba del servo HS-7955TG con la ESP32-C3

Conexiones con la fuente de laboratorio y una ESP32 simulada que acepta los mismos comandos que pruebas_servos/prueba_servo/prueba_servo.ino. El servo va en el canal de pitch (GPIO1).

## Conexiones

—pulso GPIO1

—ángulo del brazo

0 mAcorriente del servo

## Fuente de laboratorio

Encendida V Límite A

GND de la fuente unido al GND de la ESP32

## Monitor serie (ESP32 simulada)

Enviar

## Señal en GPIO1 (osciloscopio)

## Conexiones a hacer

Desde | Hacia
Fuente + (6,0 V) | Cable rojo del servo
Fuente − | Cable negro del servo
Fuente − | Pin GND de la ESP32
ESP32 pin 1 (GPIO1) | Cable amarillo del servo
ESP32 micro-USB | Notebook

No conectar nada a los pines 5V ni 3V3 de la placa.

## Secuencia de la prueba real

1. Ajustar la fuente a 6,0 V y el límite a 1,0 A con todo desconectado; verificar con el multímetro.
2. Con la fuente apagada, hacer las conexiones de la tabla.
3. Conectar la ESP32 por USB, cargar prueba_servo.ino y abrir el monitor serie a 115200 baud con "Nueva línea".
4. Encender la fuente: el servo queda flojo y en silencio, con corriente casi nula.
5. e 1 → c → p 1300 → p 1700 → b 1200 1800 → s → o.
6. Para terminar: o, apagar la fuente y recién ahí desconectar.
7. Si la fuente pasa a CC (limitación de corriente) con el servo quieto: apagar y revisar el tope mecánico o la polaridad.

Simulación aproximada: el ángulo usa 0,09 °/µs y consumos típicos de fichas de vendedores (reposo ~20 mA, en movimiento ~300 mA, trabado 3,4–4,2 A). Los valores reales se miden con la planilla de pruebas_servos/README.md.
