HecVelaz/keepon-pro/docs/benchmark_pi_20260930_sin_personas.csv

fecha | label | modelo | imgsz | hilos | yolo | face | pose | cam_hz | proc_hz | yolo_ms | yolo_p95 | face_ms | pose_ms | total_ms | total_p95 | edad_ms | edad_p95 | cpu_pct | ram_mb | personas | rostros | poses | temp_c
2026-09-30 20:19:04 | A_yolo480_t4 | yolo26n_ncnn_model | 480 | 4 | 1 | 0 | 0 | 11.4 | 11.2 | 79.0 | 87.6 | 0.0 | 0.0 | 79.0 | 87.6 | 109.8 | 158.0 | 283 | 806 | 0 | nan | nan | 56.75
2026-09-30 20:19:27 | A_yolo480_t2 | yolo26n_ncnn_model | 480 | 2 | 1 | 0 | 0 | 11.2 | 10.6 | 88.6 | 93.9 | 0.0 | 0.0 | 88.6 | 93.9 | 126.3 | 181.5 | 252 | 806 | 0 | nan | nan | 57.3
2026-09-30 20:19:50 | A_yolo320_t4 | yolo26n_320_ncnn_model | 320 | 4 | 1 | 0 | 0 | 22.5 | 22.5 | 31.7 | 36.6 | 0.0 | 0.0 | 31.7 | 36.6 | 50.1 | 56.8 | 251 | 791 | 0 | nan | nan | 57.85
2026-09-30 20:20:12 | A_yolo320_t2 | yolo26n_320_ncnn_model | 320 | 2 | 1 | 0 | 0 | 17.3 | 17.3 | 45.4 | 48.5 | 0.0 | 0.0 | 45.4 | 48.5 | 67.6 | 92.4 | 223 | 790 | 0 | nan | nan | 58.4
2026-09-30 20:20:34 | A_yolo256_t4 | yolo26n_256_ncnn_model | 256 | 4 | 1 | 0 | 0 | 29.9 | 29.9 | 18.2 | 18.9 | 0.0 | 0.0 | 18.2 | 18.9 | 33.8 | 34.8 | 201 | 784 | 0 | nan | nan | 57.3
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
