HecVelaz/keepon-pro/pruebas_buzzer/notas_polca_de_olimpia/1.jpeg

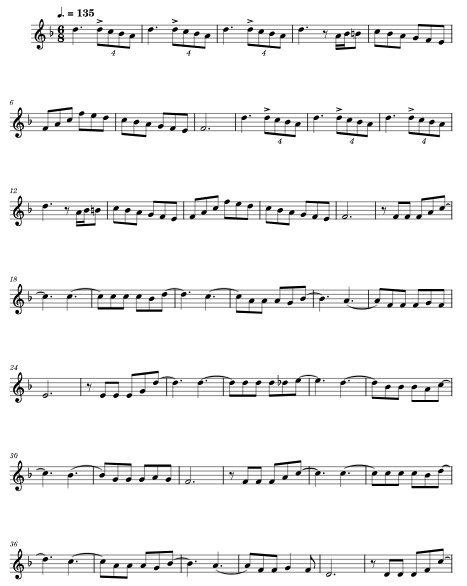
pruebas_buzzer/notas_polca_de_olimpia/1.jpeg
