HecVelaz/keepon-pro/pruebas_camisetas/imagenes_referencia/cerro/cerro_2025_detalle_escudo.jpg

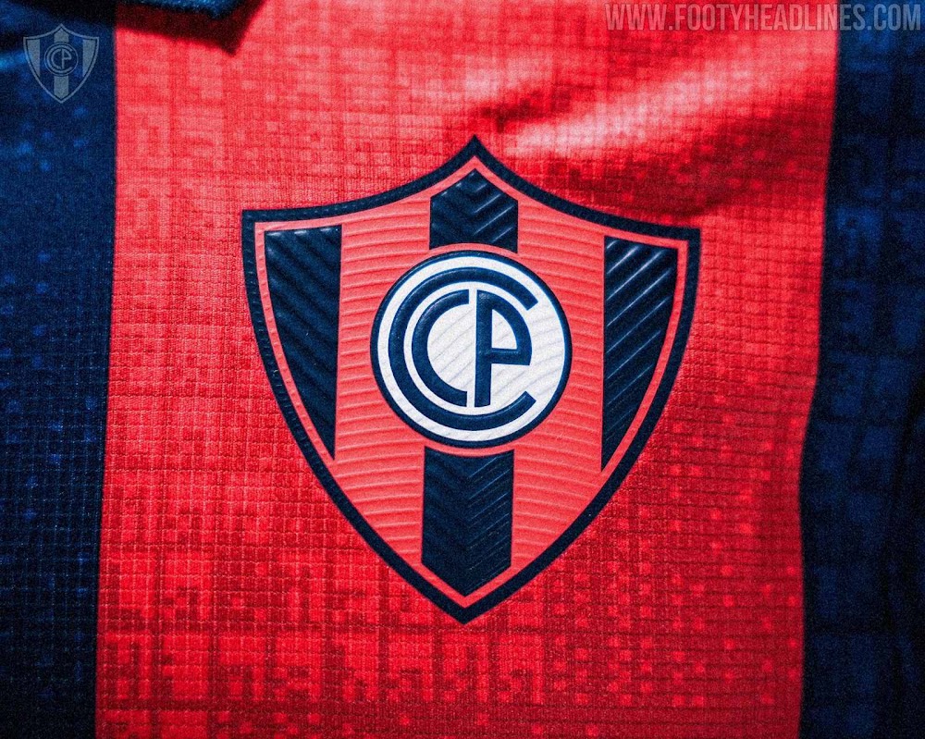
pruebas_camisetas/imagenes_referencia/cerro/cerro_2025_detalle_escudo.jpg
