HecVelaz/keepon-pro/pruebas_camisetas/imagenes_referencia/cerro/cerro_2025_titular_detalle_rayas.jpg

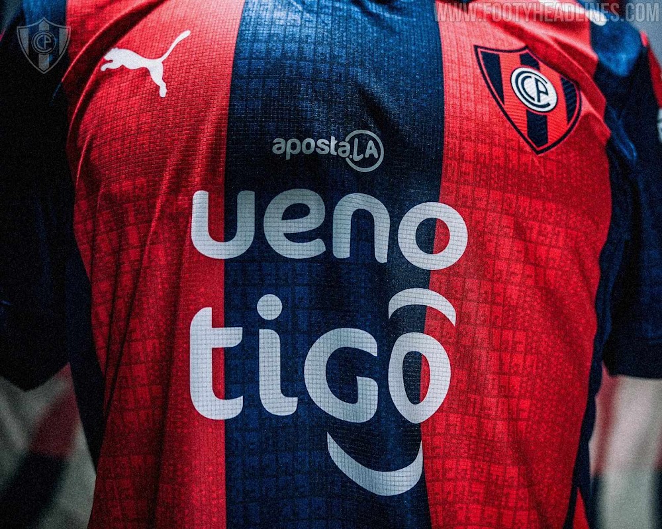
pruebas_camisetas/imagenes_referencia/cerro/cerro_2025_titular_detalle_rayas.jpg
