HecVelaz/keepon-pro/pruebas_camisetas/imagenes_referencia/cerro/cerro_2025_titular_frente.jpg

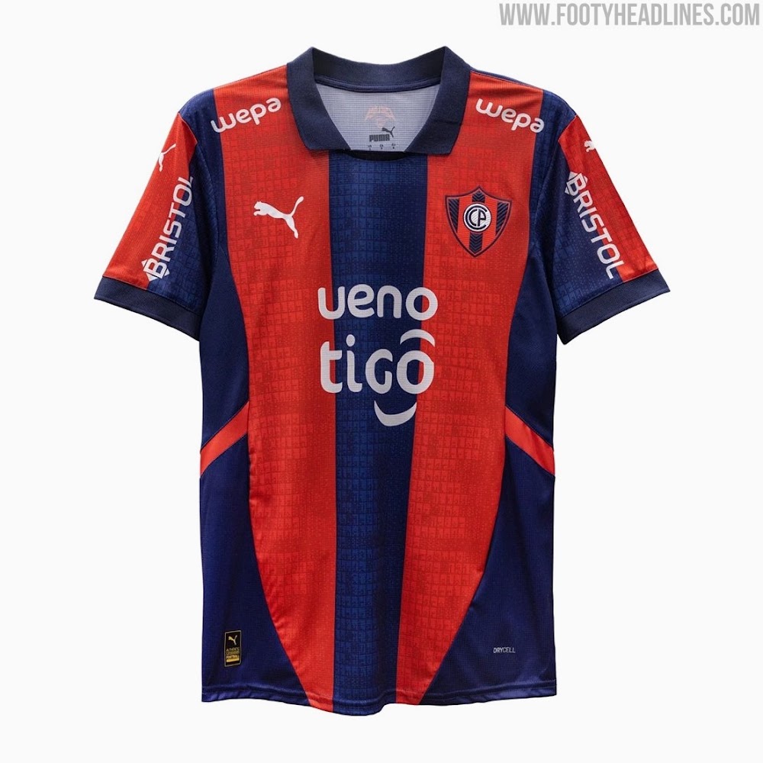
pruebas_camisetas/imagenes_referencia/cerro/cerro_2025_titular_frente.jpg
