HecVelaz/keepon-pro/pruebas_camisetas/imagenes_referencia/cerro/cerro_2025_titular_luz_de_colores.jpg

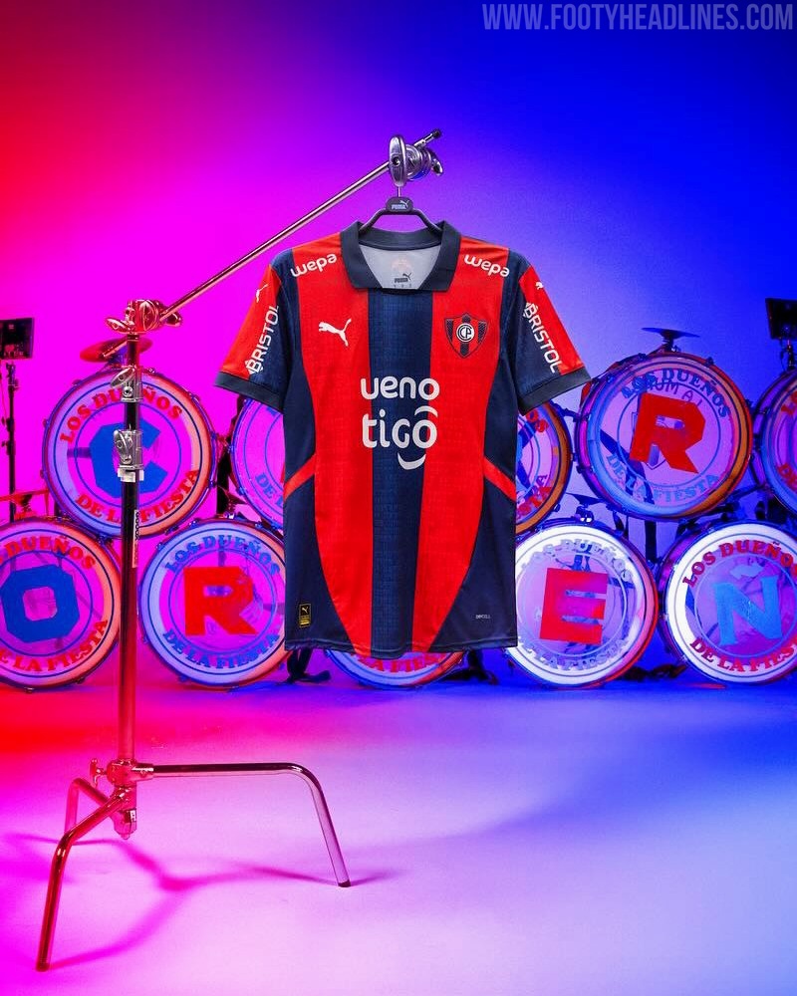
pruebas_camisetas/imagenes_referencia/cerro/cerro_2025_titular_luz_de_colores.jpg
