HecVelaz/keepon-pro/pruebas_camisetas/imagenes_referencia/cerro/cerro_2026_detalle_union.jpg

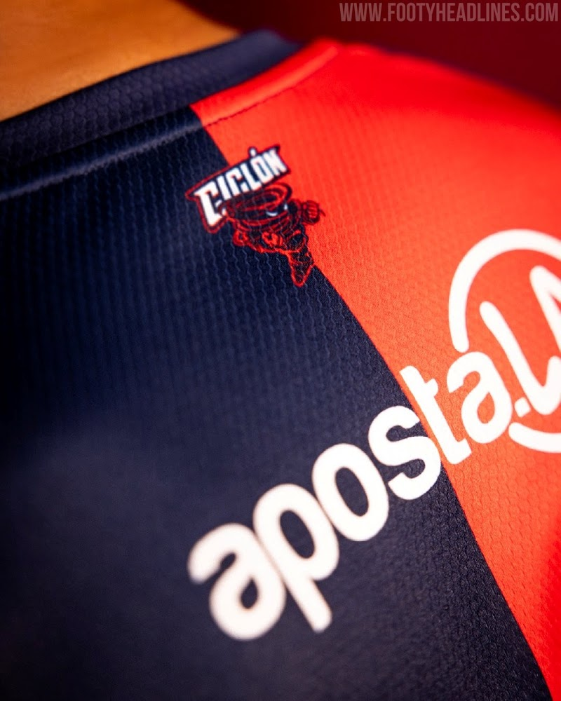
pruebas_camisetas/imagenes_referencia/cerro/cerro_2026_detalle_union.jpg
