HecVelaz/keepon-pro/pruebas_camisetas/imagenes_referencia/cerro/cerro_2026_titular_mitad_y_mitad.jpg

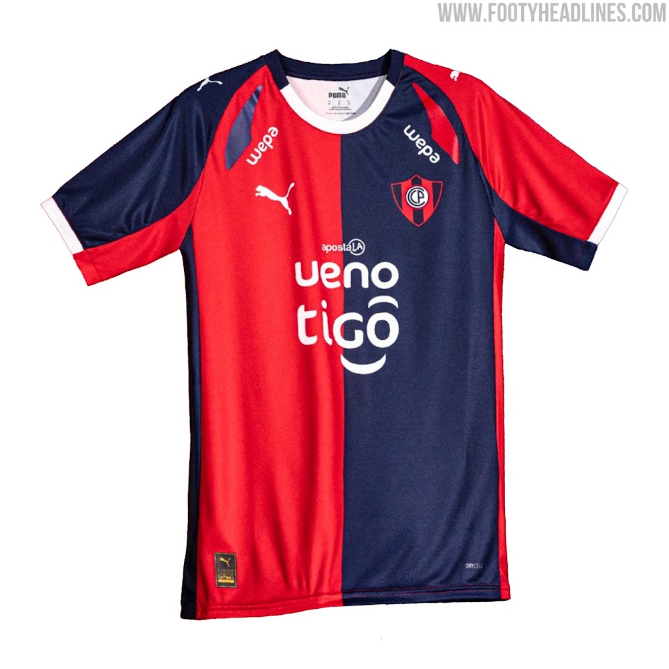
pruebas_camisetas/imagenes_referencia/cerro/cerro_2026_titular_mitad_y_mitad.jpg
