HecVelaz/keepon-pro/pruebas_camisetas/imagenes_referencia/cerro/cerro_2026_titular_mitad_y_mitad_fondo.jpg

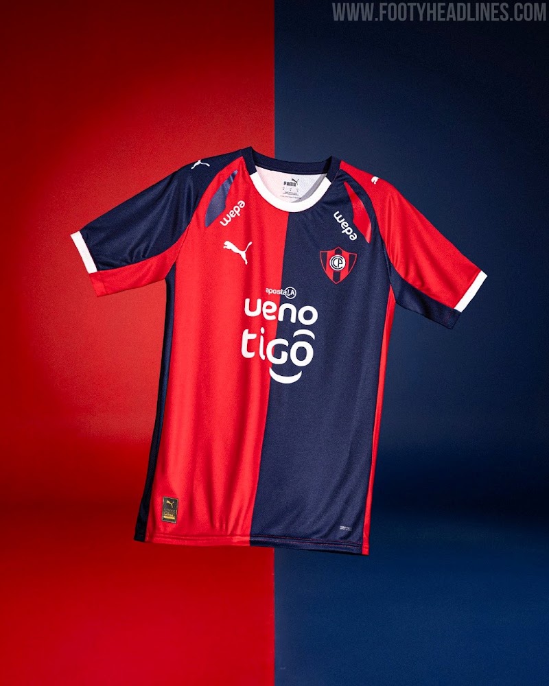
pruebas_camisetas/imagenes_referencia/cerro/cerro_2026_titular_mitad_y_mitad_fondo.jpg
