HecVelaz/keepon-pro/pruebas_camisetas/imagenes_referencia/cerro/cerro_varias_rayas_bordo_y_marino.jpg

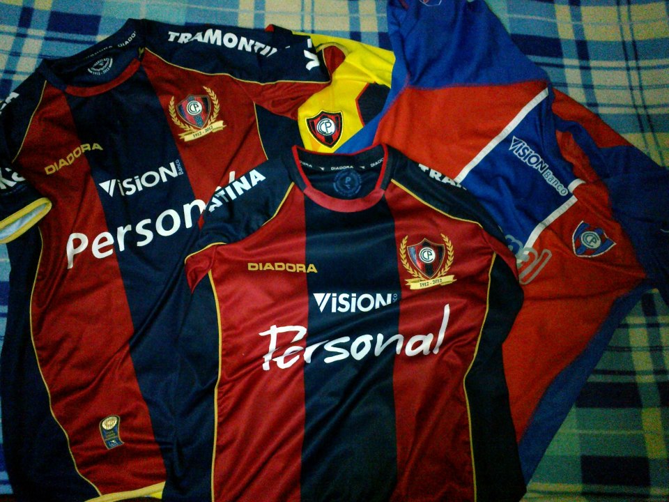
pruebas_camisetas/imagenes_referencia/cerro/cerro_varias_rayas_bordo_y_marino.jpg
