HecVelaz/keepon-pro/pruebas_camisetas/imagenes_referencia/olimpia/olimpia_1902-2012_dibujo.jpg

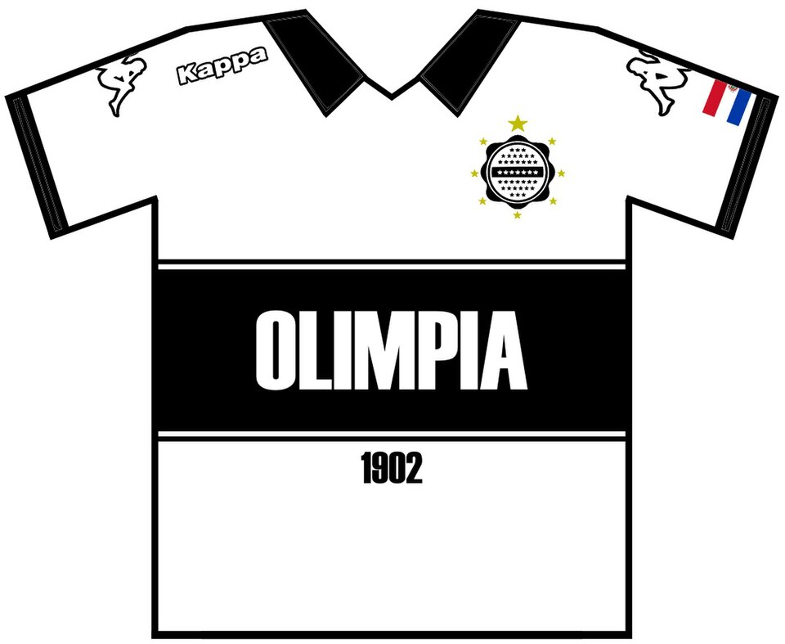
pruebas_camisetas/imagenes_referencia/olimpia/olimpia_1902-2012_dibujo.jpg
