HecVelaz/keepon-pro/pruebas_camisetas/imagenes_referencia/olimpia/olimpia_2025_titular_frente.jpg

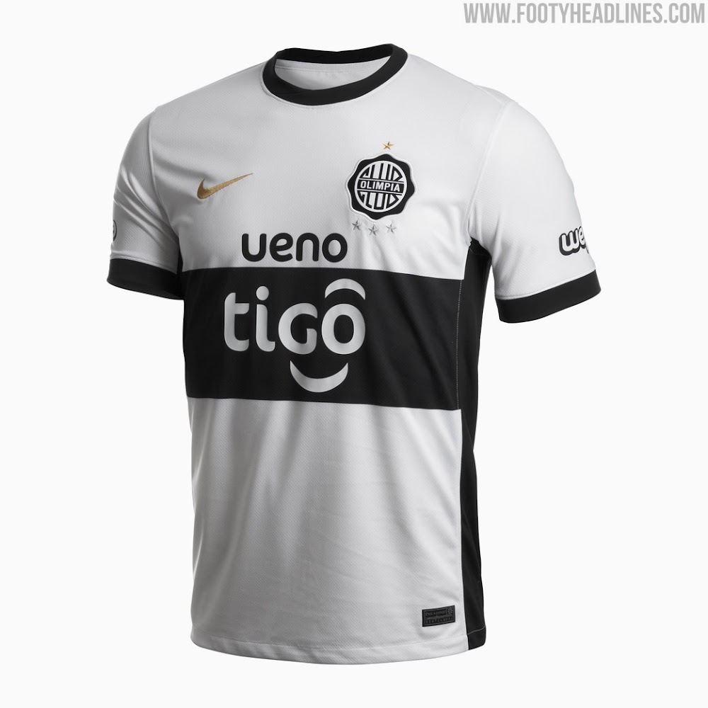
pruebas_camisetas/imagenes_referencia/olimpia/olimpia_2025_titular_frente.jpg
