HecVelaz/keepon-pro/pruebas_camisetas/imagenes_referencia/olimpia/olimpia_titular_franja_difusa.jpg

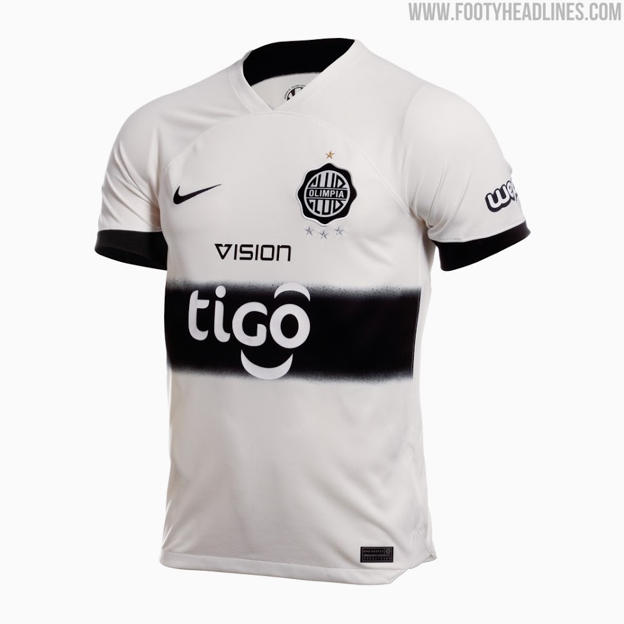
pruebas_camisetas/imagenes_referencia/olimpia/olimpia_titular_franja_difusa.jpg
