HecVelaz/keepon-pro/pruebas_camisetas/imagenes_referencia/suplentes/cerro_2025_suplente_beige_rayas_finas.jpg

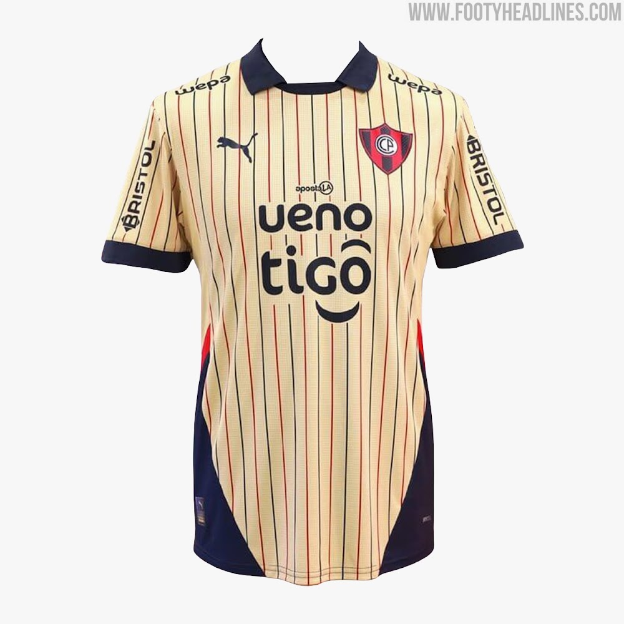
pruebas_camisetas/imagenes_referencia/suplentes/cerro_2025_suplente_beige_rayas_finas.jpg
