HecVelaz/keepon-pro/pruebas_camisetas/imagenes_referencia/suplentes/cerro_2025_suplente_maniqui.jpg

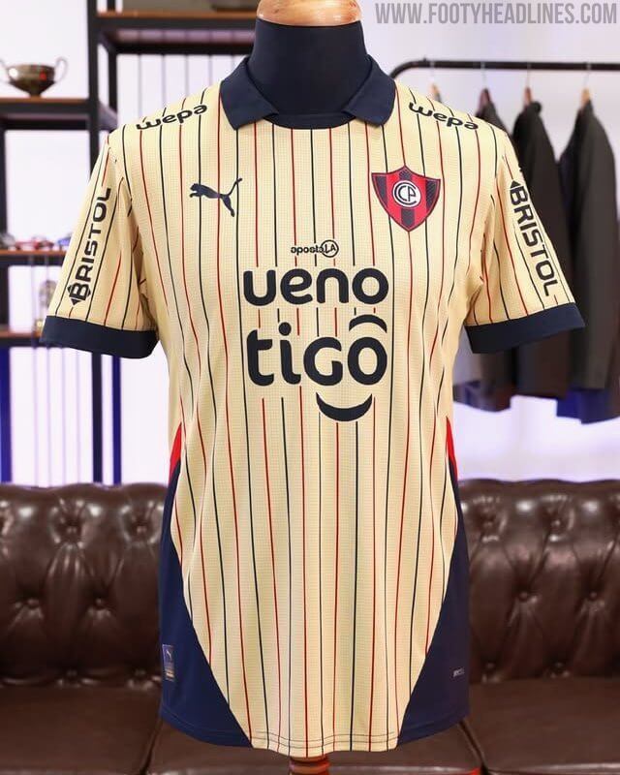
pruebas_camisetas/imagenes_referencia/suplentes/cerro_2025_suplente_maniqui.jpg
