HecVelaz/keepon-pro/pruebas_camisetas/imagenes_referencia/suplentes/olimpia_1902_negra.jpg

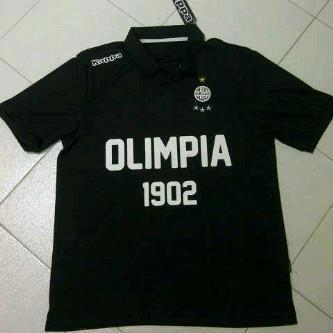
pruebas_camisetas/imagenes_referencia/suplentes/olimpia_1902_negra.jpg
