HecVelaz/keepon-pro/pruebas_camisetas/imagenes_referencia/suplentes/olimpia_2025_suplente_espalda.jpg

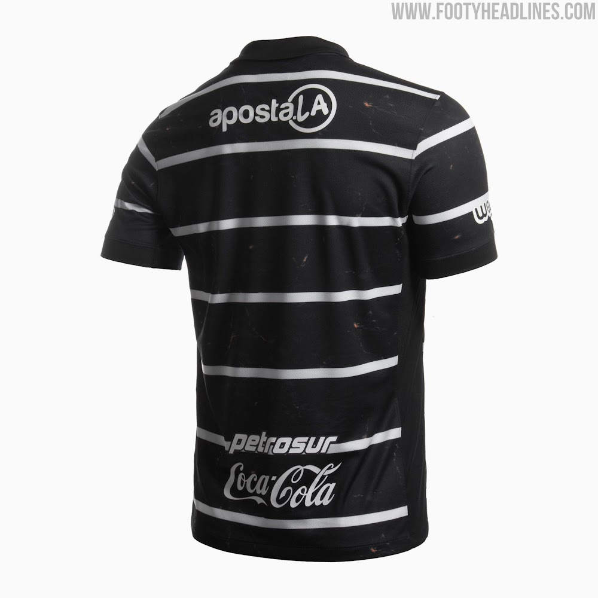
pruebas_camisetas/imagenes_referencia/suplentes/olimpia_2025_suplente_espalda.jpg
