HecVelaz/keepon-pro/pruebas_camisetas/imagenes_referencia/suplentes/olimpia_2025_suplente_negra_rayas_blancas.jpg

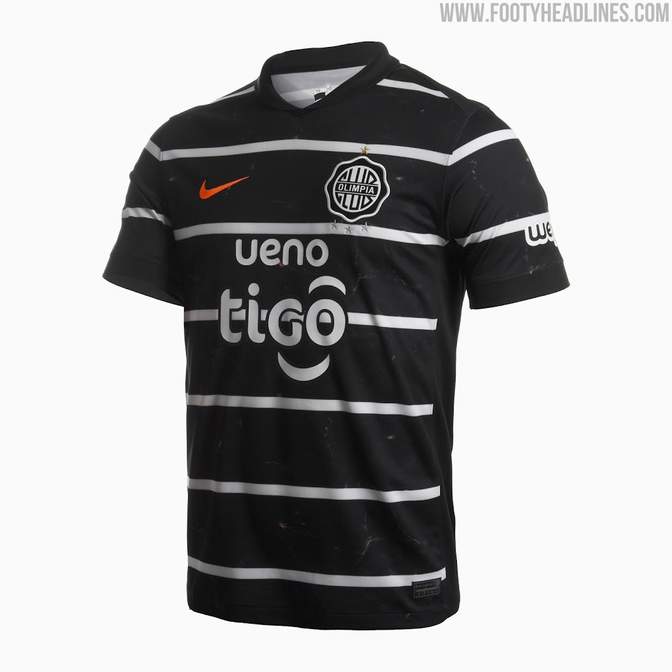
pruebas_camisetas/imagenes_referencia/suplentes/olimpia_2025_suplente_negra_rayas_blancas.jpg
