HecVelaz/keepon-pro/pruebas_camisetas/imagenes_referencia/trampas/barcelona_rayas_bordo_y_azul.jpg

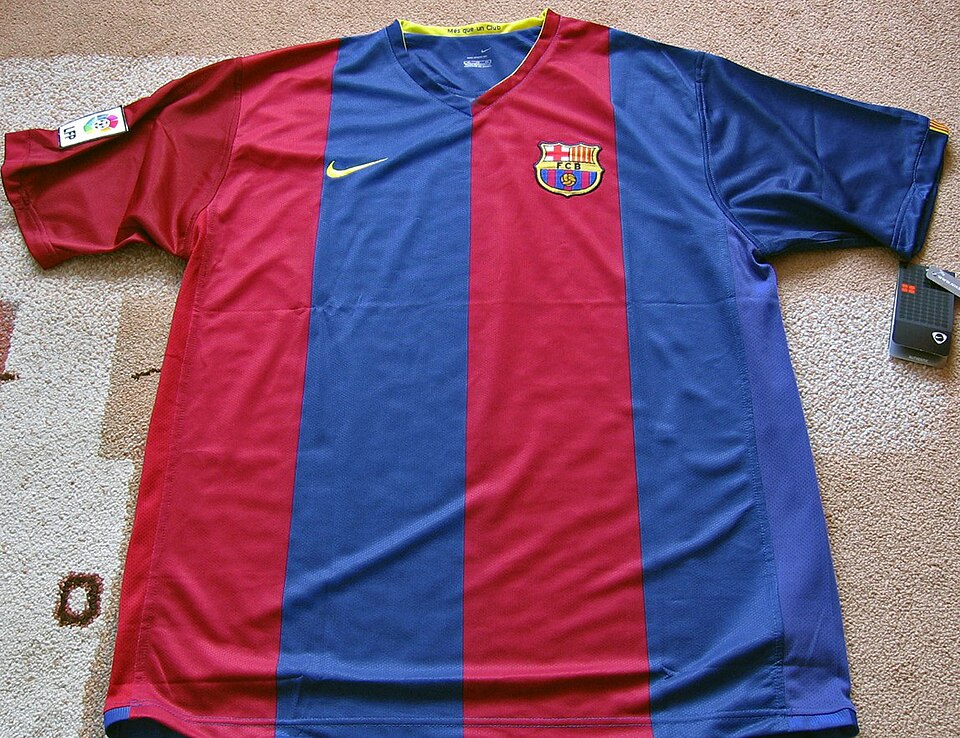
pruebas_camisetas/imagenes_referencia/trampas/barcelona_rayas_bordo_y_azul.jpg
