HecVelaz/keepon-pro/pruebas_camisetas/imagenes_referencia/trampas/barcelona_rayas_finas.jpg

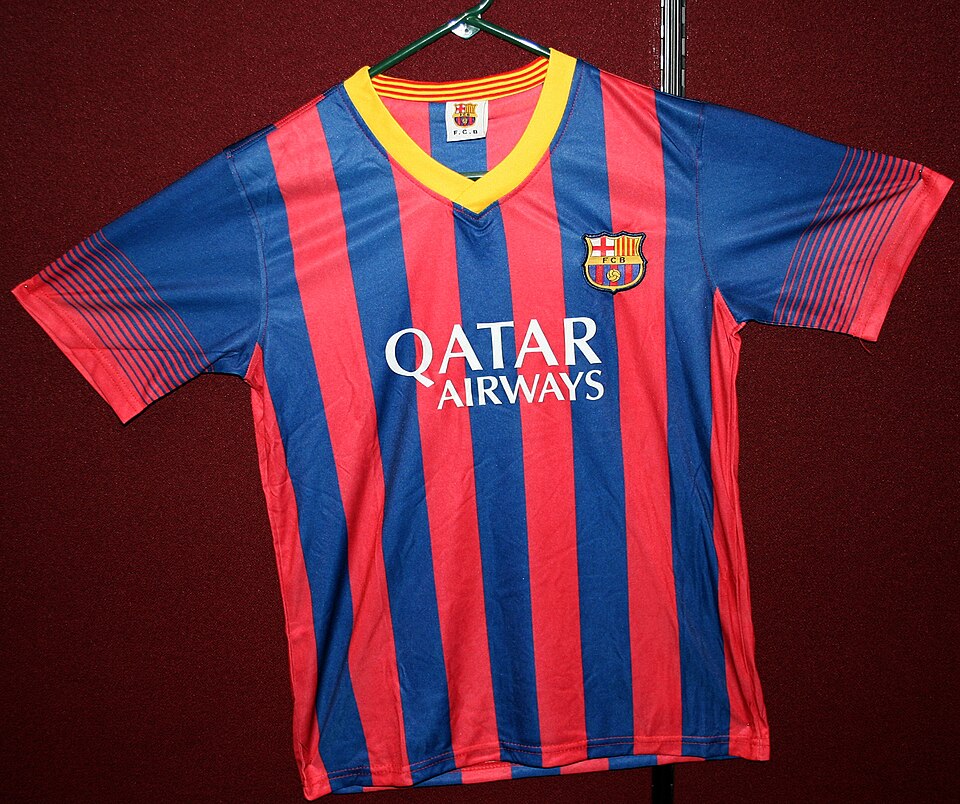
pruebas_camisetas/imagenes_referencia/trampas/barcelona_rayas_finas.jpg
