HecVelaz/keepon-pro/pruebas_camisetas/imagenes_referencia/trampas/roja_con_estampado.jpg

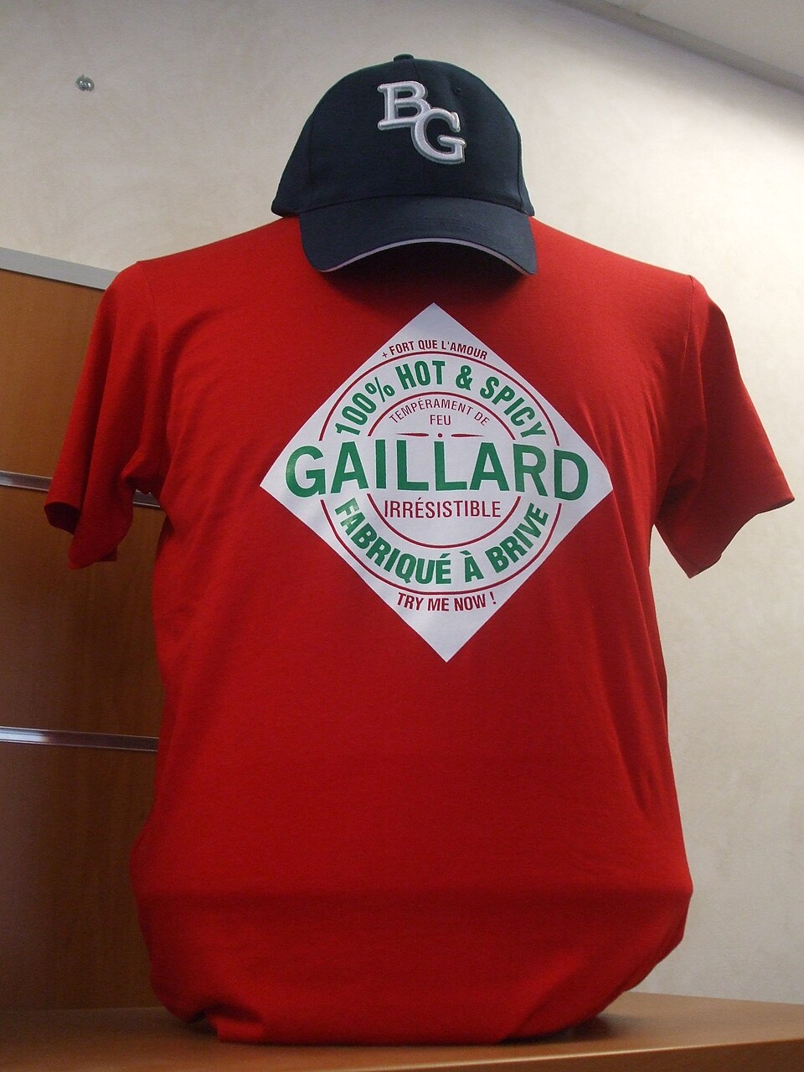
pruebas_camisetas/imagenes_referencia/trampas/roja_con_estampado.jpg
