HecVelaz/keepon-pro/docs/diseno_v6/revision_R4/vistas/01_R4_cambios.png

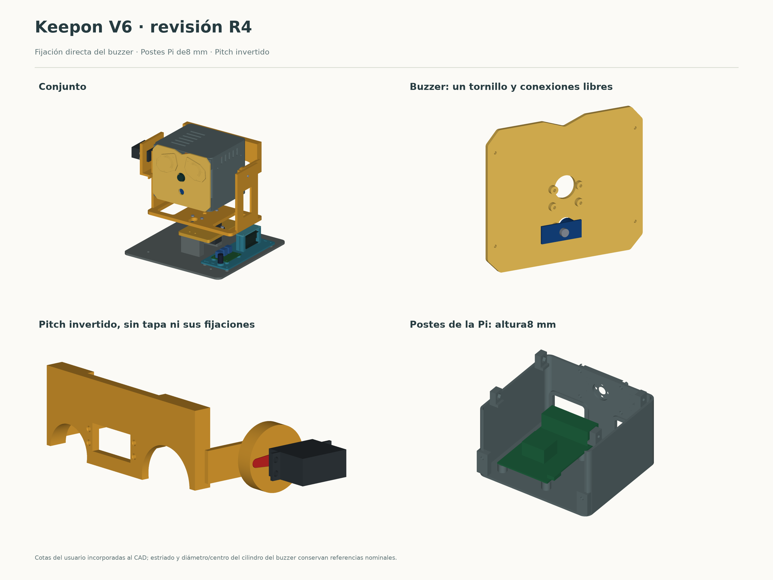
docs/diseno_v6/revision_R4/vistas/01_R4_cambios.png
