HecVelaz/keepon-pro/config.yaml

# Parámetros del robot. Todo lo ajustable vive acá (se documenta en el informe).

neck:
  # Límites articulares por software [grados]. Los topes mecánicos van un poco más allá.
  limits:
    yaw:   [-70.0, 70.0]
    pitch: [-20.0, 30.0]
    roll:  [-20.0, 20.0]         # Montado (03/11): a +25 queda al límite de la pared y a +30 toca. Hacia la izquierda,
                                 # −30 "al límite" fue SIN compensación de zona muerta (llegaba ~10° antes): con la
                                 # compensación, −20 es −20 de verdad. Probar de a poco antes de ampliar.
                                 # 08/11: esas medidas son de ANTES de corregir signo y cero del roll (servos.roll):
                                 # el +20 nuevo (derecha) es el −25 de entonces. Verificar ±20 montado.
  home: [0.0, 0.0, 0.0]          # postura calibrada, mirada al frente
  vmax: [180.0, 120.0, 250.0]    # velocidad máxima por eje [°/s] (yaw, pitch, roll)
  amax: [600.0, 400.0, 900.0]    # aceleración máxima por eje [°/s²]
                                 # 05/11: se probó bajar pitch/roll (90 °/s; 250/200 °/s²) y los TRES servos
                                 # vibraron más: quietos no vibran, pero moviéndose LENTO sí (avanzan a saltitos
                                 # por la banda muerta). Se volvió a movimientos rápidos y controlados: pitch como
                                 # con el HS (120/400; el par inercial de la cabeza, ~0,1 kgf·cm, es despreciable
                                 # frente al del MG996R) y roll 120/300. Los gestos (nod 237 °/s², mentón 137) entran.
  suavizado_s: [0.10, 0.10, 0.15]  # curva S [s] (yaw, pitch, roll), 07/11: la posición del servo es el promedio
                                 # del perfil trapezoidal en esta ventana (keepon/trajectory.py). La aceleración
                                 # cambia en rampa en vez de saltar: jerk ≤ 2·amax/suavizado_s (yaw: 12000 °/s³;
                                 # el trapecio solo, 60000 a 100000). Cada movimiento dura esto más (25° de yaw:
                                 # 0,41 → 0,51 s); las velocidades altas no cambian (los servos vibran lentos).
                                 # 0 = trapecio solo. Se cuenta en pasos de 10 ms, máximo 0,5 s.
  # Calibración de los servos (planilla de pruebas_servos/README.md). La usa el firmware para pasar de grados a µs:
  # pulso = centro_us + signo · grados / grados_por_us, recortado a [min_us, max_us].
  # compensacion_us (opcional): [al bajar el pulso, al subir el pulso], se suma según el sentido del último
  # movimiento del eje (zona muerta del servo; ver roll). Sin la clave: [0, 0].
  servos:
    pitch:                       # TowerPro MG996R (05/11, reemplaza al HS-7955TG), 6 V
      centro_us: 1500            # montado (05/11): horn calzado en 1500 y la cara queda vertical
      grados_por_us: 0.092       # el del MG996R del roll; montado, ±217/326 µs dieron −20°/+30°
      min_us: 1100               # ≈ +37° (arriba) y −28° (abajo): margen sobre los −20°/+30° de neck.limits
      max_us: 1800               # (el MG996R no tiene tope hasta 800/2300 µs; esto protege la mecánica)
      signo: -1                  # montado (05/11): pulso mayor = la cara BAJA → signo −1 (pitch + = arriba).
                                 # Probado: +30° = 1174 µs y −20° = 1717 µs, llega bien a los dos.
                                 # Sin pulso queda FLOJO (el HS mantenía): la cabeza cae si se corta el pulso.
      # Antes: Hitec HS-7955TG (09/10-05/11): 0.090 °/µs, centro 1400, 760/2240 µs, signo 1. Vibraba montado.
    yaw:                         # DSSERVO RDS3218 n.º 2 (versión de 270°), medido el 12/10 sin carga
      centro_us: 1500
      grados_por_us: [0.13, 0.136]   # [lado de pulsos < 1500, lado de pulsos > 1500]. Medido: −39° en 1200,
                                     # −65° en 1000, −70° en 960; +39° en 1800, ≈ +67° en 2000, +75° en 2040
      min_us: 950                # ≈ −71°. No tiene tope (llega a −130° / +140° con 500/2500 µs):
      max_us: 2020               # ≈ +71°  estos límites son lo único que protege el cableado
      signo: -1                  # montado en el v6 (03/11): pulso mayor = el robot gira a SU IZQUIERDA (visto desde
                                 # atrás). Como yaw + = derecha (PROTOCOLO.md), signo −1. Cero: 1500 µs con la cara al
                                 # frente (horn reubicado en el estriado el 03/11). Extremos 960/2020 probados: ni roces
                                 # ni cable tirante. Montado VIBRA al moverse lento (≤ ~40 °/s con la rampa de 100 Hz);
                                 # a ~100 °/s (750 µs/s) va suave. Quieto no vibra.
      # El n.º 1 (11-12/10) era simétrico: 0.13, 950/2050 µs. No son intercambiables sin recalibrar.
      # Antes: MG90S provisorio (09/10), asimétrico [0.090, 0.085], 600/2450 µs.
    roll:                        # TowerPro MG996R NUEVO (05/11, reemplaza al que tenía zona muerta), 6 V
      centro_us: 1500            # 08/11, MG996R reemplazado por otro igual: derecha en 1500 µs, llegando desde la
                                 # izquierda (−15° → 0). Tiene banda muerta: pasos de 3-5° no lo movían y de golpe
                                 # saltaba. Falta medir llegando desde la derecha (compensacion_us). Antes: 1554
                                 # (servo anterior, 08/11) y 1500 (05/11).
      grados_por_us: 0.092       # sin carga (05/11): +217 µs = +20° justos; −217 µs "casi 20°"
      min_us: 1000               # ≈ −60°/+48° desde el centro: de sobra para los ±20° (sin tope hasta 800/2300 µs)
      max_us: 2000
      signo: 1                   # 08/11, verificado montado: pulso mayor = HORARIO visto desde atrás (inclina a la
                                 # derecha), y roll + = horario (PROTOCOLO.md). Antes −1, copiado del MG996R anterior:
                                 # roll + inclinaba a la izquierda.
      compensacion_us: [0, 0]    # El nuevo vuelve a 0 desde ±20° sin la zona muerta del anterior (que usaba
                                 # [0, 151]). Montado vibra un poco quieto en 0 al volver de −20°: sin resolver.
      # Pesa 55 g. Sin pulso queda flojo: en el STOP hay que seguir mandando el último pulso.
      # Antes: MG996R n.º 1 (13/10-05/11): centro 1450, banda muerta ~100-110 µs (≈ 10°) e intermitente,
      # compensacion_us [0, 151]. MG90S (09-13/10, [0.090, 0.085], 1000/2000 µs, banda muerta 20-30 µs; repuesto),
      # RDS3218 n.º 1 (descartado el 12/10: vibra quieto cerca de 1500 µs) y SG90 (repuesto).

serial:
  port: /dev/serial/by-id/usb-1a86_USB_Serial-if00-port0   # ESP32-C3 clon con CH340 (= /dev/ttyUSB0, pero no cambia de nombre)
  baud: 115200
  watchdog_ms: 500               # ESP32: sin comandos → detiene secuencias y mantiene postura
  keepalive_ms: 200              # PC: envía PING si no mandó nada en este tiempo

camera:
  # Raspberry Pi 5 + Camera Module 3 NoIR (IMX708) en la cabeza.
  backend: auto                  # auto | ros2 | picamera2 | gstreamer | opencv  (en la Pi: ros2, ver config.local.yaml)
  ros_topic: /keepon_cam/image_raw   # tópico de camera_ros (backend ros2)
  # Cámara por nombre (no por índice) para camera_ros. Desde el 03/11, con la cabeza v6, está en el conector
  # i2c@88000 (antes i2c@80000). La leen scripts/ver_percepcion.sh y ver_personas.sh (CAMARA=... la cambia).
  ros_camera: /base/axi/pcie@120000/rp1/i2c@88000/imx708@1a
  orientation_deg: 180           # montada invertida en la cabeza v6 (03/11): camera_ros rota al leer el sensor
  index: 0                       # para opencv (webcam USB en la notebook de desarrollo)
  size: [640, 480]
  hfov_deg: 37.3                 # = 2·atan(320/fx). camera_ros a 640x480 RECORTA el sensor (no son los 66° nominales)
  # Intrínsecos PROVISORIOS hasta calibrar ESTA cámara con un tablero (pendiente).
  # fx, fy: de ~/vision_estereo/config/calibracion/right_corregida.yaml (otra cámara del mismo modelo y modo).
  # cx, cy: el CENTRO DE LA IMAGEN (03/11). Antes se usaba el centro óptico de esa otra calibración (rotado 180°:
  # 210.5, 253.6) y el robot centraba la nariz ~110 px a la izquierda (≈ 6,5°): parecía no mirar a los ojos.
  # dist: en cero (los coeficientes eran de la otra cámara).
  fx: 948.16
  fy: 947.12
  cx: 319.5
  cy: 239.5
  dist: [0.0, 0.0, 0.0, 0.0, 0.0]
  fps: 30

control:
  rate_hz: 40                    # lazo árbitro/control en la Pi

perception:
  max_age_s: 0.3                 # un mundo más viejo que esto se considera sin datos (cámara caída)
  yolo_model: models/yolo26n_256_ncnn_model
  yolo_imgsz: 256
  yolo_conf: 0.4
  max_persons: 3                 # rostros evaluados por cuadro (objetivo + candidatos)
  face_model: detector           # detector (BlazeFace, 6 puntos, rápido) | landmarker (478 puntos, ~49 ms/cara)
  face_crop_px: 192              # lado del recorte de cabeza que recibe el modelo de rostro
  pose_num: 2
  cores_personas: [0, 1]         # núcleos del proceso YOLO + rostros
  ncnn_threads: 2                # = cantidad de núcleos del proceso
  cores_pose: [2, 3]             # núcleos del proceso de pose
  pose_max_hz: 30                # limitar la pose libera memoria/CPU para YOLO (SALUDO dura >1 s)
  looking_deg: 15.0              # ME_MIRA: desvío cara->cámara menor a esto

# Detector de camisetas (keepon/camiseta.py). Colores medidos el 04/11 con la NoIR, luz del laboratorio,
# camisetas reales (Olimpia titular, Cerro 2026 mitad y mitad) y remeras lisas roja y azul marino.
# HSV de OpenCV: H 0..179, S y V 0..255. Medidos: rojo H 0-2/178 S 190-210; azul marino H 116-145 S 35-90 V 30-60
# (la NoIR lo ve violeta); blanco de Olimpia S < 16 V 115-170; franja de Olimpia V 38-54.
camiseta:
  vis_min: 0.5                   # visibilidad mínima de los hombros (MediaPipe)
  ancho_min_px: 40               # hombros más angostos que esto: muy lejos para mirar la camiseta
  margen_lados: 0.1              # se descarta esta fracción del ancho de hombros a cada lado (brazos)
  desde_hombros: 0.15            # el torso empieza esto (en anchos de hombros) debajo de los hombros (cuello)
  hasta_hombros: 1.1             # y termina acá (la franja de Olimpia queda en el medio)
  visible_min: 0.4               # fracción mínima del torso dentro del cuadro
  rojo: {h_max: 8, h_min: 165, s_min: 120, v_min: 60}
  azul: {h_min: 100, h_max: 160, s_min: 25, v_min: 15, v_max: 130}
  columnas: 8                    # CERRO: el torso se divide en columnas
  col_dominante: 0.5             # una columna es roja (o azul) si al menos esta fracción lo es
  cerro_cols_min: 2              # columnas rojas y azules mínimas (cada color ≥ 1/4 del ancho)
  cerro_hueco: 1                 # columnas neutras toleradas en el borde rojo|azul (escudo, logos)
  cerro_frac_min: 0.2            # fracción mínima de píxeles rojos y de azules en todo el torso
  filas: 8                       # OLIMPIA: el torso se divide en franjas horizontales
  olimpia_contraste: 1.6         # una franja clara tiene al menos este brillo relativo a la más oscura
  blanco_s_max: 60               # y es blanca: saturación baja
  franja_v_max: 110              # la franja oscura no puede ser más brillante que esto
  confirmar: 6                   # T6 d: cuadros seguidos con la camiseta para detectarla
  soltar: 6                      # y sin ella para soltarla

# Eventos de T2 con filtro temporal (keepon/eventos.py). Todo por tiempo: la percepción no va a ritmo fijo.
eventos:
  mira_sostenida_s: 0.5          # ME_MIRA se activa tras mirar esto seguido (la guía: sostenida ≥ 0,5 s)
  mira_suelta_s: 0.3             # y se suelta tras no mirar esto seguido (histéresis)
  saludo_ciclos: 2               # SALUDO: ciclos de oscilación lateral de la muñeca (2 vaivenes por ciclo;
                                 # el primer recorrido solo marca el sentido → 3 cambios de sentido)
  saludo_ventana_s: 2.5          # los cambios de sentido tienen que caer dentro de esta ventana
  saludo_amp_hombros: 0.25       # amplitud mínima de cada vaivén, en anchos de hombros (independiente de la distancia)
  saludo_margen_hombros: 0.1     # la muñeca tiene que estar por encima del hombro al menos esto
  saludo_mano_abajo_s: 0.4       # tras un saludo, la mano debe bajar esto para contar otro (un gesto = un evento)
  pose_vis_min: 0.5              # visibilidad mínima de un punto de MediaPipe para usarlo
  # SALIENDO: cerca del borde y alejándose, o el cuello en su límite de yaw y la persona más allá del centro
  saliendo_borde_frac: 0.15      # "cerca del borde": a menos de esta fracción del ancho
  saliendo_vel_px_s: 80.0        # "alejándose": velocidad hacia el borde (ventana de 0,4 s)
  saliendo_limite_deg: 4.0       # "en el límite": yaw comandado a menos de esto del límite
  saliendo_on_s: 0.2             # la condición tiene que durar esto para activar SALIENDO
  saliendo_off_s: 0.6            # y faltar esto para soltarlo

# Buzzer (módulo pasivo MH-FMD; I/O en el pin de abajo, VCC a 3V3). El volumen se baja achicando el ciclo de trabajo del PWM:
# 1.0 = 50 % (el máximo); 0.25 = 12,5 %. La sensación de volumen no es lineal con el ciclo: ajustar de oído.
buzzer:
  pin: 5                        # GPIO del I/O del módulo. 03/11: del GPIO10 al GPIO5 (con la cabeza v6 armada,
                                # en el 10 no sonaba). Libres y seguros: 5, 6, 7 (no 2/8/9, 18/19, 20/21)
  volumen: 0.12                 # 03/11: a pedido, la mitad que antes (26/10: 0.25)

# Duración de cada sonido [s]. El firmware es la fuente de verdad (manda DONE),
# la PC la usa para planificar y como timeout.
sounds:
  R2D2: 1.6
  POLCA: 7.104                  # polca del Club Olimpia (Paraguay), compases 1 a 8
  POLCA_CERRO: 6.0              # extra: polca del Club Cerro Porteño (la reacción a Cerro es el ABUCHEO)
  ABUCHEO: 2.5
  PIROPO: 1.2
  DESAPROBACION: 0.8
  BEEP_NEUTRO: 0.25
  BEEP_TIMIDO: 0.35
  BEEP_ATREVIDO: 0.35
  BEEP_MALEDUCADO: 0.45

# Tabla de prioridades (0 = más importante). Ver docs/HOJA_DE_RUTA.md §S4.
priorities:
  OPERADOR: 0
  EJES: 0                        # demostración de los 3 ejes (comando del operador, sólo el cuello)
  SALUDO: 1
  CAMISETA: 2
  MODO: 3
  SEGUIMIENTO: 4
  OBSERVADOR: 5

# Demostración de los tres ejes (08/11, botón "Ejes" del panel / comando "ejes"): para el video y la demo.
# Cada paso: [yaw, pitch, roll, duración del movimiento en s]. Yaw y pitch con mínimo jerk; el roll va con el
# perfil del firmware (banda muerta del MG996R). Después de cada paso, quieto pausa_s para que se vea la postura.
# Total ≈ 15 s. Al terminar vuelve a HOME y retoma el Observador o el seguimiento.
ejes:
  pausa_s: 0.5
  secuencia: [[30.0, 0.0, 0.0, 1.1], [-30.0, 0.0, 0.0, 1.8], [0.0, 0.0, 0.0, 1.1],
              [0.0, 20.0, 0.0, 1.0], [0.0, -15.0, 0.0, 1.4], [0.0, 0.0, 0.0, 1.0],
              [0.0, 0.0, 15.0, 0.8], [0.0, 0.0, -15.0, 1.0], [0.0, 0.0, 0.0, 0.8]]

# Periodos refractarios [s]. Se registran cuando la respuesta EMPIEZA, no al proponer.
cooldowns:
  SALUDO_por_persona: 5.0
  CAMISETA_por_persona: null     # 08/11: null = UNA VEZ POR APARICIÓN (por ID del tracker; si la persona sale más de
                                 # ~1 s, tracker.max_lost, vuelve con otro ID y suena de nuevo). Antes 25 s: con la
                                 # camiseta a la vista la polca se repetía. Un número = segundos (la guía: 20-30).
  PIROPO_global: 40.0

# Control de mirada (T3). Detalle de los dos modos en keepon/gaze.py.
gaze:
  modo: objetivo                 # "objetivo": la referencia salta adonde está la persona (calculado con la posición
                                 # del cuello al sacar la foto) y queda QUIETA hasta que se corra más que umbral_deg;
                                 # el firmware hace el movimiento con vmax/amax. "velocidad": el control de antes.
                                 # 05/11: en velocidad, la referencia avanzaba de a poco en cada ciclo y los tres
                                 # servos vibraban (se arrastran lento).
  umbral_deg: [2.5, 2.5]         # (yaw, pitch) [°] cuánto se tiene que correr la persona para un nuevo movimiento.
                                 # Es la tolerancia de centrado; más chico = más movimientos cortos
  quieto_deg: 1.0                # [°] solo se corrige con fotos sacadas con el cuello a menos de esto del objetivo
                                 # (en movimiento, el servo real va atrás del espejo y el ángulo no es exacto)
  # --- Solo modo "velocidad":
  kp: [4.0, 2.5]                 # [1/s] (yaw, pitch; un número = los dos)  velocidad = kp * (|error| - zona muerta).
                                 # 05/11: pitch de 4 a 2,5 (golpeteaba). Yaw probado con 2,5 y fue PEOR: el RDS3218
                                 # vibra cuando se mueve lento (≤ ~40 °/s) y con menos kp pasa más tiempo lento
  vmax: [150.0, 90.0]            # saturación de velocidad de referencia (yaw, pitch) [°/s]
  deadzone: 0.03                 # zona muerta suave, fracción del ancho/alto de imagen. 05/11: más grande deja la
                                 # cara quieta lejos del centro (0,04 → 1,5° y 0,05 → ~3° en el simulador)
  ema: [0.5, 0.3]                # suavizado del error (yaw, pitch; 1 = sin filtro). 05/11: pitch de 0,5 a 0,3
  lost_hold_s: 1.0               # pérdida < 1 s: mantener; luego se libera el objetivo
  mirar_abajo_deg: 8.0           # la cámara apunta esto por debajo de la cara (la cara queda arriba del centro)
                                 # para que entre la camiseta: el campo vertical es de ±14° (04/11, con Olimpia)

focus:
  switch_after_s: 1.5            # el candidato debe ser mejor durante este tiempo para cambiar
  w_looking: 1.0                 # ME_MIRA tiene prioridad estricta; este peso queda sin uso
  w_size: 0.6                    # pesos para desempatar dentro de cada grupo (T4)
  w_center: 0.4

# T3 d: si el objetivo se queda quieto (cara a cara), inclinar la cabeza (roll) como gesto de curiosidad.
# Va dentro del SEGUIMIENTO (mismo dueño del cuello): yaw y pitch siguen a la persona mientras tanto.
curiosidad:
  activa: true
  quieto_s: 3.0                  # tiempo con el objetivo quieto para inclinarse
  movimiento_max_deg: 5.0        # "quieto": la dirección de la persona (ángulo del cuello + error en la imagen)
                                 # no se aparta más que esto en yaw ni en pitch. No usa solo el error del control:
                                 # si la cabeza oscila un poco alrededor de la persona, el error varía (03/11, real)
  amp_deg: 15.0                  # inclinación; alterna el lado. Un movimiento grande y único: la zona muerta
                                 # del MG996R (~10°) se come los chicos
  sostener_s: 2.0                # cuánto la sostiene antes de volver a 0
  espera_s: 8.0                  # después de una inclinación (o si se cortó), no repetir antes de esto

# Modos de personalidad (T5). Se cambian en tiempo de ejecución (scripts/robot_vivo.py: t/a/m/n o
# "MODE TIMIDO") y se confirman con BEEP_<MODO>. Reacciones sobre la persona que se sigue (prioridad MODO).
modos:
  inicial: NEUTRO                # NEUTRO | TIMIDO | ATREVIDO | MALEDUCADO
  timido:                        # lo mira (ME_MIRA) → desvía la mirada, la sostiene y vuelve a espiar de a poco
    desvio_yaw_deg: 25.0         # hacia el costado con más lugar dentro de los límites de yaw
    desvio_pitch_deg: 12.0       # hacia abajo
    desvio_roll_deg: 10.0        # cabeza un poco ladeada (vergüenza)
    sostener_s: 2.5
    regreso_s: 3.0               # vuelve gradualmente (curva suave)
    espera_s: 3.0                # después, no repetir con la misma persona antes de esto
  atrevido:                      # lo mira → levanta el mentón varias veces sin dejar de seguirla en yaw
    menton_deg: 10.0             # amp·sin²(π t/T): pide (amp/2)(2π/T)² ≈ 137 °/s² con T = 1,2 s (pitch: 250)
    periodo_s: 1.2
    veces: 3
    espera_s: 3.0
  # maleducado: piropo al empezar cada salida (SALIENDO) de la persona seguida; cooldown PIROPO_global.

observer:
  modo: exploracion              # 08/11 "exploracion": lo que pide la Tabla 1 (barridos lentos + sacadas + roll),
                                 # detalle en keepon/behaviors.py (Observer). De respaldo: "miradas" (05/11, de punto
                                 # en punto con pausas: se veía "para y gira") y "barrido" (senoide continua sin
                                 # sacadas; el 05/11, sin curva S, los servos vibraban).
  exploracion:
    fijacion_s: 1.5              # cuánto fija un punto de interés (y donde quedó la última persona), contando la
                                 # sacada (~0,3-0,5 s con el perfil del firmware)
    centrar_s: 1.6               # ir al centro, con mínimo jerk
    pausa_centro_s: 1.0
    amp_deg: 45.0                # barre de −amp a +amp en yaw
    vel_barrido: 25.0            # [°/s] velocidad MEDIA del barrido (90° en 3,6 s; pico 1,875 veces = 47 °/s).
                                 # 08/11: con 20 (pico 37,5) el yaw VIBRABA barriendo, montado. El RDS3218 vibra
                                 # ≤ ~40 °/s (05/11): si sigue vibrando, subirla.
    pitch_barrido: 0.0           # pitch mientras barre
    sacada_cada: 2               # barridos entre una sacada y la siguiente
    # Puntos de interés de las sacadas [yaw, pitch, roll] [°]: roll chico para encuadrar (siempre se vuelve a 0
    # en el barrido siguiente, nunca de un lado al otro).
    puntos_interes: [[-20.0, 6.0, 5.0], [30.0, -4.0, -5.0], [5.0, 10.0, 0.0]]
  # --- Solo modo "miradas" (07/11: quieto donde quedó → centra la vista (HOME) → recorre las miradas):
  # [yaw, pitch, roll] [°]. Roll: pequeñas inclinaciones "para encuadrar" (Tabla 1), siempre de 0 a ±roll o de
  # vuelta, nunca de un lado al otro. Sin el tercer valor, roll 0.
  miradas: [[-40.0, 3.0, 5.0], [-15.0, -3.0, 0.0], [15.0, 3.0, -5.0], [40.0, -3.0, 0.0], [15.0, -3.0, 5.0],
            [-15.0, 3.0, 0.0]]
  pausa_s: 3.0                   # tiempo en cada punto, CONTANDO el movimiento (transicion_s): 1,4 s quieto
  transicion_s: 1.6              # 08/11: yaw y pitch van de un punto al otro con curva de mínimo jerk en este
                                 # tiempo (30° de yaw: pico 35 °/s, aceleración 68 °/s²; 1,0 s se veía rápido:
                                 # pico 56 °/s). OJO: el RDS3218 vibraba ≤ ~40 °/s (05/11). 0 = salto y el firmware
                                 # hace el movimiento (vmax/amax: 25° en ~0,5 s, el de antes). Tiene que ser
                                 # menor que pausa_s. Más largo = más suave pero más lento (vibra ≤ ~40 °/s).
  # --- Solo modo "barrido":
  yaw_amp: 45.0                  # barrido lento
  pitch_amp: 6.0
  period_s: 14.0

greeting:
  nods: 3
  nod_amp: 12.0                  # [°] en pitch
  nod_period_s: 1.0              # nod = amp·sin²(π t / T): pide (amp/2)(2π/T)² ≈ 237 °/s² y 38 °/s,
                                 # dentro de amax/vmax de pitch (250 °/s², 90 °/s desde el 05/11). Con 0,5 s pedía
                                 # ~947 °/s²: la rampa lo recortaba y el cabeceo salía atrasado y deformado (Codex)
