HecVelaz/keepon-pro/docs/diseno_v6/revision_R4/config.yaml

version: V6_integrada_nominal
revision: R4_fijacion_directa_buzzer_pitch_invertido
solidworks: 2021
skill: C:/Users/mathi/.codex/skills/solidworks-automation
estado: Diseño nominal integrado; fabricación condicionada a mediciones
recorridos_grados:
  yaw:
  - -70
  - 70
  pitch:
  - -20
  - 30
  roll:
  - -20
  - 20
impresion:
  material: null
  boquilla_mm: 0.4
  cama_util_mm: 215.0
  holgura_encastre_por_lado_mm: 0.25
  holgura_servo_por_lado_mm: 0.4
  pared_refuerzo_mm: 3.0
  radio_transicion_mm: 2.0
  tolerancia_malla_mm: 0.08
  nota: Valores de diseño provisionales; calibrar con cupón en el material elegido.
insertos:
  exterior_nominal_mm: 4.2
  diametro_instalacion_mm: 4.0
  diametro_instalacion_confirmado: false
  diametros_cupon_mm:
  - 3.7
  - 3.8
  - 3.9
  - 4.0
  - 4.1
  entrada_mm: 4.4
  chaflan_entrada_mm: 0.4
  holgura_fondo_mm: 0.6
  diametro_poste_mm: 9.0
  nota: 4.0 es una variante del cupón, no una recomendación de fabricante.
tornillos:
  paso_m3_mm: 3.4
  largo_fijacion_servo_mm: 6
  largos_disponibles_mm:
  - 5
  - 6
  - 8
  - 10
  - 12
  cabeza_envolvente_d_mm: 6.0
  cabeza_envolvente_h_mm: 3.0
  nota: Envolvente de diseño de cabeza; medir la tornillería comprada.
yaw:
  giro_cuerpo_grados: 90.0
  z_pedestales_mm: 38.0
  espesor_adaptador_mm: 6.0
  fijaciones_base_xy_mm:
  - - -18
    - -6
  - - -18
    - 6
  - - 38
    - -6
  - - 38
    - 6
  referencia_base: 'V5: mismos pedestales que V3/V4; piso 210x210.'
  rosca_base_verificada: false
  envolvente_cable_mm:
  - 8.0
  - 20.0
  - 8.0
  envolvente_cable_confirmada: false
  centro_adaptador_xy_mm:
  - 0.0
  - 10.0
  dimensiones_adaptador_mm:
  - 100.0
  - 68.0
  - 6.0
  interferencia_presion_por_lado_mm: 0.05
  nota_R3: Pilares y adaptador comparten cuatro ejes M3 centrados en X=-18/38. Alojamiento
    de cuerpo y rebajes para orejas; presión nominal 0.05/lado sujeta a cupón.
pitch:
  z_original_mm: 150.0
  y_brida_mm: -111.0
  brazo_simple_verificado: true
  perfil_brazo_simple_local_xy_mm: null
  nota_perfil: Contorno cerrado completo, incluido cubo, centro del eje en (0,0).
    X local hacia punta y Y local lateral; no inventar puntos.
  nota_brazo: Contorno exterior según croquis del usuario; largo total 26.4, extremos
    6.2/9.2 y espesor 2.8. Estriado y tornillo central propios del servo, sin inventar
    dientes.
  casquillo_pivote:
    diametro_cuerpo_mm: 8.3
    diametro_paso_mm: 4.4
    y_cuerpo_mm:
    - 79.5
    - 88.1
    diametro_labio_mm: 11.6
    espesor_labio_mm: 1.2
roll:
  x_brida_mm: -61.0
  y_extremos_cuna_mm:
  - -82.0
  - 82.0
  apertura_traviesa_y_mm:
  - -32.0
  - 46.0
  espesor_placa_retencion_mm: 1.2
  fijaciones_retencion_yz_mm:
  - - -23
    - -14
  - - -23
    - 14
  - - 23
    - -14
  - - 23
    - 14
  fijaciones_pitch_xz_mm:
  - - -16
    - -14
  - - -16
    - 14
  - - 16
    - -14
  - - 16
    - 14
  alivios_usb:
  - centro_y_mm: -49.0
    radio_mm: 26.0
  - centro_y_mm: 57.0
    radio_mm: 20.0
  alivios_usb_centro_z_relativo_mm: -16.0
  suplemento_traviesa_superior_mm: 26.0
  nota: Las posiciones del servo salen de la clase Servo heredada; medir unidad real
    y accesos.
usb:
  centros_aberturas_y_mm:
  - -35.0
  - 35.0
  paso_trasero_centro_yz_relativo_mm:
  - -35.0
  - -36.0
  paso_trasero_ancho_alto_mm:
  - 36.0
  - 26.0
  paso_trasero_radio_esquina_mm: 3.0
  paso_trasero_refuerzo_perimetral_mm: 4.0
  paso_trasero_refuerzo_interior_mm: 1.6
  reserva_conector_x_mm:
  - -82.0
  - -27.0
  reserva_conector_y_mm:
  - -51.0
  - -19.0
  reserva_conector_z_relativa_mm:
  - -47.0
  - -25.0
  y_apertura_mm:
  - 35.0
  - 55.0
  z_apertura_relativa_mm:
  - -48.0
  - 18.0
  tapa_y_mm:
  - 27.5
  - 61.5
  tapa_z_relativa_mm:
  - -47.0
  - 17.0
  espesor_tapa_mm: 2.0
  diametro_salida_cable_mm: 8.0
  fijaciones_yz_relativas_mm:
  - - 30
    - -39
  - - 58
    - -39
  - - 30
    - 8
  - - 58
    - 8
  medidas_conector_mm: null
  radio_minimo_cable_mm: null
  nota: 'R2: dos pasos traseros simétricos, sin tapa14 ni sus fijaciones. Reserva
    USB real pendiente; las cotas de las aberturas son de diseño.'
camara:
  modelo: Camera Module 3 NoIR estándar (IMX708), no Wide
  patron_mm:
  - 21.0
  - 12.5
  diametro_paso_mm: 2.2
  diametro_optico_existente_mm: 17.0
  diametro_refuerzo_poste_mm: 6.0
  tornillo_propuesto: M2x10 + tuerca M2; conservar originales si tienen longitud adecuada.
  fuente: https://datasheets.raspberrypi.com/camera/camera-module-3-standard-mechanical-drawing.pdf
buzzer:
  modelo: RLBZ23_5V
  pcb_ancho_mm: 12.8
  pcb_largo_mm: 31.8
  pcb_espesor_mm: 1.5
  agujero_diametro_mm: 3.0
  borde_agujero_a_bordes_pcb_mm:
  - 4.8
  - 14.9
  referencia_largo: Extremo de placa donde se encuentra el buzzer; distancias al borde
    del agujero, confirmadas por el usuario.
  componentes_y_conectores_mm: null
  tipo_activo_pasivo: null
  pcb_asiento_x_mm: 48.5
  pcb_borde_y_mm: 35.0
  pcb_extremo_buzzer_z_relativo_mm: -39.0
  bastidor_espesor_mm: 2.0
  separacion_inferior_componentes_mm: 3.0
  guia_holgura_por_lado_mm: 0.25
  arandela_impresa_espesor_mm: 0.8
  altura_componentes_verificada: false
  z_centro_relativo_mm: -28.0
  fijaciones_y_mm:
  - -35.0
  - 35.0
  nota: 'PCB medido, disposición lateral vertical: buzzer hacia abajo y pines arriba.
    Componentes y conectores sin medir; bastidor abierto, fijación al agujero con
    M3x5 y arandela impresa.'
  montaje_R3:
    pcb_x_mm: 58.5
    pcb_y_inicial_mm: -6.5
    pcb_z_centro_relativo_mm: -28.0
    placa_soporte_x_mm:
    - 60.0
    - 62.0
    extremo_buzzer: Y_negativo
    normal_acustica: +X
    centro_fijacion_y_mm: 9.9
    centro_fijacion_z_relativo_mm: -28.2
    nota: PCB girado en su plano, paralelo a la cara. La posición del transductor
      dentro de PCB y su altura quedan por medir; boca y eje acústico originales conservados.
    inicio_poste_pcb_x_mm: 60.0
    radio_poste_pcb_mm: 3.5
    largo_tornillo_pcb_mm: 6.0
    profundidad_ciega_pcb_mm: 4.6
    luz_componentes_hasta_cara_mm: 10.0
  altura_total_mm: 10.0
  agujero_desde_extremo_buzzer_mm: 14.8
  montaje_R4:
    pcb_x_mm: 58.5
    pcb_y_inicial_mm: -6.5
    pcb_z_centro_relativo_mm: -28.0
    agujero_desde_borde_ancho_mm: 6.3
    diametro_transductor_referencia_mm: 12.0
    centro_transductor_y_mm: 0.0
    piloto_directo_m3_mm: 2.5
    profundidad_piloto_mm: 4.6
    largo_tornillo_mm: 5.0
    radio_poste_mm: 3.5
    holgura_transductor_mm: 0.3
    nota: Fijación directa a poste integrado en cara con un M3x5. Cota transversal
      6.3 conservada de medición previa; diámetro/centro del transductor son referencia
      nominal previa.
ojos:
  estilo: Ojos, marcos y lentes fusionados a la cara; una sola pieza imprimible.
  contorno_local_uv_mm:
  - - -18
    - 22
  - - 12
    - 13
  - - 23
    - 4
  - - 24
    - -11
  - - 15
    - -21
  - - -1
    - -21
  - - -18
    - -12
  - - -23
    - 0
  radio_contorno_mm: 4.0
  espesor_base_mm: 2.0
  ancho_marco_mm: 2.0
  relieve_marco_mm: 0.8
  lente_diametro_mm: 27.8
  alojamiento_lente_diametro_mm: 28.4
  profundidad_alojamiento_mm: 0.8
  relieve_lente_mm: 2.2
  marcas_decorativas_uv_mm:
  - - -14
    - 14
  - - 17
    - 0
  - - 5
    - -17
  centros_y_mm:
  - -30.0
  - 30.0
  z_relativo_mm: 22.0
cableado:
  margen_longitud_mm: 20.0
  tramos:
  - nombre: yaw
    grupo_a: fixed
    punto_a_mm:
    - 72.0
    - 30.0
    - 30.0
    grupo_b: yaw
    punto_b_antes_elevacion_mm:
    - 36.0
    - 0.0
    - 60.0
    longitud_libre_inicial_mm: 220.0
  - nombre: pitch
    grupo_a: yaw
    punto_a_antes_elevacion_mm:
    - -38.0
    - 71.0
    - 124.0
    grupo_b: pitch
    punto_b_antes_elevacion_mm:
    - -61.0
    - 68.0
    - 150.0
    longitud_libre_inicial_mm: 160.0
  - nombre: roll
    grupo_a: pitch
    punto_a_antes_elevacion_mm:
    - -61.0
    - 68.0
    - 150.0
    grupo_b: roll
    punto_b_antes_elevacion_mm:
    - -43.5
    - 45.0
    - 111.0
    longitud_libre_inicial_mm: 150.0
  nota: Puntos orientativos de brida y longitudes iniciales heredadas. No definen
    radio ni trayectoria real. MG996R pertenece ahora a pitch.
validacion:
  paso_pitch_grados: 5
  paso_roll_grados: 5
  yaw_muestras_grados:
  - -70
  - -35
  - 0
  - 35
  - 70
  volumen_interferencia_mm3: 0.1
  fuente: B-Rep nominal; no ensayo físico ni FEA.
brazos:
  doble_longitud_mm: 37.7
  simple_longitud_mm: 26.4
  simple_espesor_mm: 2.8
  simple_diametros_extremos_mm:
  - 6.2
  - 9.2
  circular_diametro_mm: 19.8
  circular_espesor_mm: 2.45
  circular_radio_agujeros_mm: 7.0
  circular_numero_agujeros: 4
  circular_separacion_referencia_mm: 9.899494936611665
  circular_servo: roll
  paso_tornillo_central_mm: 8.4
  circular_agujero_central_mm: 3.0
  circular_distancia_opuestos_mm: 14.0
  circular_dientes: 25
  circular_color: rojo
  dato_comercial_dientes_pulgadas: 0.984
  simple_sentido: -1
  circular_altura_total_mm: 4.5
  circular_cubo_diametro_mm: 9.0
  circular_diametro_agujeros_mm: 3.0
  patron_confirmado: true
  circular_fuente: Croquis y foto aportados por el usuario en el chat
  circular_diametro_cavidad_25T_nominal_mm: 5.5118
  circular_juego_axial_servo_mm: 0.5
  circular_reserva_fondo_cavidad_mm: 0.4
  circular_abertura_retencion_mm: 18.2
  circular_acceso_carcasa_mm: 8.4
raspberry:
  postes_xy_mm:
  - - -3.5
    - -44
  - - -3.5
    - 5
  - - 54.5
    - -44
  - - 54.5
    - 5
  diametro_poste_mm: 9.0
  altura_poste_mm: 8.0
  altura_anterior_mm: 12.6
  z_base_relativo_mm: -51.6
  piloto_mm: 2.2
