HecVelaz/keepon-pro/keepon/actuators.py

"""Puerta de salida hacia el ESP32.

Todo comando de cuello o buzzer pasa por acá y se verifica contra el árbitro:
si el comportamiento no es dueño del recurso, el comando se descarta y se
registra la violación. Así "nunca dos dueños" se garantiza por construcción.
"""

from __future__ import annotations

from .arbiter import BUZZER, NECK, Arbiter, Grant
from .link import Link
from .protocol import PROTOCOL_VERSION
from .trajectory import AXES, clamp


class Actuators:
    def __init__(self, cfg: dict, link: Link, arbiter: Arbiter, log):
        self.link, self.arb, self.log = link, arbiter, log
        self.limits = [cfg["neck"]["limits"][a] for a in AXES]
        self.ref = list(cfg["neck"]["home"])       # última referencia articular enviada
        self.sound_seq: dict[int, int] = {}        # grant.id -> seq del sonido
        self.done: set[int] = set()                # seqs con DONE recibido
        self.violations = 0
        self.esp_state = "RUN"
        self.session = False     # True tras HELLO 1 (el ESP32 aceptó la sesión)
        self.rebooted = False    # HELLO 0 con sesión abierta -> el ESP32 se reinició

    def _check(self, g: Grant, res: str) -> bool:
        if self.arb.holds(g.id, res):
            return True
        self.violations += 1
        self.log(self.link.now(), f"VIOLACION {g.behavior}#{g.id} usó {res} sin ser dueño")
        return False

    def neck(self, g: Grant, yaw: float, pitch: float, roll: float) -> None:
        if not self._check(g, NECK):
            return
        self.ref = [clamp(v, lo, hi) for v, (lo, hi) in zip((yaw, pitch, roll), self.limits)]
        self.link.send("J", *(round(v, 1) for v in self.ref))

    def play(self, g: Grant, name: str) -> None:
        if self._check(g, BUZZER):
            self.sound_seq[g.id] = self.link.send("S", name)

    def sound_finished(self, g: Grant) -> bool:
        return self.sound_seq.get(g.id) in self.done

    def cancel_sound(self) -> None:
        self.link.send("CANCEL", "SOUND")

    def process(self, replies) -> None:
        for r in replies:
            if r.name == "DONE":
                self.done.add(r.seq)
            elif r.name == "ERR":
                self.log(self.link.now(), f"ESP32 ERR seq={r.seq} {' '.join(map(str, r.args))}")
            elif r.name == "STATE":
                self.esp_state = r.args[0]
            elif r.name == "HELLO":
                fw, proto = r.args
                if proto != PROTOCOL_VERSION:
                    self.log(self.link.now(), f"ESP32 protocolo v{proto} incompatible (se espera v{PROTOCOL_VERSION})")
                elif r.seq == 1:
                    self.session = True
                    self.log(self.link.now(), f"ESP32 sesión abierta fw={fw}")
                elif self.session:
                    self.session, self.rebooted = False, True
                    self.log(self.link.now(), "ESP32 se REINICIÓ")

    def reset_after_reboot(self, home: list[float]) -> None:
        self.ref = list(home)    # el firmware arranca en HOME
        self.sound_seq.clear()
        self.done.clear()
        self.rebooted = False
