HecVelaz/keepon-pro/keepon/eventos.py

"""Eventos de T2 con filtro temporal: de la percepción cruda (cuadro a cuadro) al World.

- ME_MIRA sostenido: la cara mira a la cámara (FaceObs.looking, umbral looking_deg) durante
  `mira_sostenida_s` seguidos para activarse, y deja de mirar durante `mira_suelta_s` seguidos para
  soltarse (histéresis: un cuadro suelto no lo prende ni lo apaga).
- SALIENDO: la persona está cerca del borde de la imagen y se aleja hacia él, o el cuello está en su
  límite de yaw y la persona sigue más allá del centro hacia ese lado (no la puede seguir). Con
  histéresis (saliendo_on_s / saliendo_off_s).
- SALUDO: una muñeca por encima de su hombro que oscila de costado. Se cuentan los vaivenes (cambios
  de sentido con amplitud mínima, medida en anchos de hombros para no depender de la distancia).
  `saludo_ciclos` ciclos (2 vaivenes cada uno) dentro de `saludo_ventana_s` → un evento: se incrementa
  Person.wave_count. Después la mano tiene que bajar para poder contar otro saludo (un gesto = una respuesta).
- CAMISETA_OLIMPIA / CAMISETA_CERRO: la clase cruda de cada pose (keepon/camiseta.py) pasa por un filtro de
  cuadros por persona (T6 d: `camiseta.confirmar` seguidos para detectarla, `camiseta.soltar` para soltarla).
  Acá se cuenta en cuadros de pose, como pide la guía, no en segundos.

Las poses (MediaPipe) no traen ID: cada una se asocia a la persona cuya caja contiene sus hombros.
Todo es por tiempo (no por cantidad de cuadros) porque la percepción no va a ritmo fijo.
"""

from __future__ import annotations

from dataclasses import dataclass, field

from .camiseta import FiltroCamiseta
from .world import World


@dataclass
class _Mira:
    activo: bool = False
    desde: float | None = None  # desde cuándo el valor crudo es distinto del filtrado


@dataclass
class _Mano:
    """Vaivenes de una muñeca levantada, en coordenada x relativa al hombro [anchos de hombros]."""
    extremo: float | None = None
    sentido: int = 0                       # +1 / −1 hacia donde va; 0 = todavía no se movió lo suficiente
    vaivenes: list[float] = field(default_factory=list)  # instantes de cada cambio de sentido
    abajo_desde: float | None = None
    armada: bool = True                    # False tras un saludo, hasta que la mano baje

    def reiniciar(self) -> None:
        self.extremo, self.sentido, self.vaivenes = None, 0, []


@dataclass
class _Persona:
    mira: _Mira = field(default_factory=_Mira)
    saliendo: _Mira = field(default_factory=_Mira)          # mismo filtro con histéresis que ME_MIRA
    us: list[tuple[float, float]] = field(default_factory=list)  # (t, u) recientes, para la velocidad
    manos: dict[str, _Mano] = field(default_factory=lambda: {"i": _Mano(), "d": _Mano()})
    saludos: int = 0
    camiseta: FiltroCamiseta | None = None
    t_saludo: float = -1e9  # instante del último SALUDO (para el overlay)
    visto: float = 0.0


class Eventos:
    """Guarda el estado por persona y completa World.persons con looking y wave_count filtrados."""

    OLVIDAR_S = 10.0  # una persona que no se ve hace más que esto se olvida

    def __init__(self, cfg: dict, log=None):
        e = cfg["eventos"]
        self.mira_on, self.mira_off = e["mira_sostenida_s"], e["mira_suelta_s"]
        self.vaivenes_min = 2 * e["saludo_ciclos"] - 1  # el primer recorrido marca el sentido, no es un vaivén
        self.ventana = e["saludo_ventana_s"]
        self.amp = e["saludo_amp_hombros"]
        self.margen = e["saludo_margen_hombros"]
        self.mano_abajo_s = e["saludo_mano_abajo_s"]
        self.vis_min = e["pose_vis_min"]
        self.borde, self.vel_min = e["saliendo_borde_frac"], e["saliendo_vel_px_s"]
        self.lim_margen, self.sal_on, self.sal_off = e["saliendo_limite_deg"], e["saliendo_on_s"], e["saliendo_off_s"]
        self.lim_yaw = cfg["neck"]["limits"]["yaw"]
        self.cam_on, self.cam_off = cfg["camiseta"]["confirmar"], cfg["camiseta"]["soltar"]
        self.log = log or (lambda t, m: None)
        self.personas: dict[int, _Persona] = {}
        self._ultima_pose = None  # frame de la última pose procesada (cada pose cuenta una sola vez)

    # -------------------------------------------------------------- entrada
    def aplicar(self, w: World, pose=None, cajas: dict[int, tuple] | None = None, crudo_mira=None,
                ref=None) -> World:
        """Actualiza los filtros con el mundo crudo del instante w.t y lo devuelve con los eventos filtrados.

        pose: último DetResult de pose (o None). cajas: {id: (x1, y1, x2, y2)} de las personas, para asociar
        las poses. crudo_mira: {id: bool} con ME_MIRA cuadro a cuadro (por defecto, Person.looking).
        ref: ángulos comandados del cuello (yaw, pitch, roll), para SALIENDO por el límite de yaw."""
        t = w.t
        for pid, p in w.persons.items():
            st = self.personas.setdefault(pid, _Persona())
            st.visto = t
            self._filtrar_mira(pid, st, (crudo_mira or {}).get(pid, p.looking), t)
            self._filtrar(pid, st.saliendo, self._saliendo_crudo(st, p, w, ref, t), t, self.sal_on, self.sal_off,
                          "SALIENDO")
        if pose is not None and cajas and pose.frame != self._ultima_pose:
            self._ultima_pose = pose.frame
            camisetas = getattr(pose, "camisetas", None) or [(None, None)] * len(pose.poses)
            for kp, (clase, _) in zip(pose.poses, camisetas):
                pid = self._asociar(kp, cajas)
                if pid is not None and pid in w.persons:
                    self._saludo(pid, self.personas[pid], kp, t)
                    self._camiseta(pid, self.personas[pid], clase, t)
        for pid, p in w.persons.items():
            st = self.personas[pid]
            p.looking, p.wave_count, p.leaving = st.mira.activo, st.saludos, st.saliendo.activo
            p.shirt = st.camiseta.activa if st.camiseta else None
        for pid in [k for k, s in self.personas.items() if t - s.visto > self.OLVIDAR_S]:
            del self.personas[pid]
        return w

    def saludo_reciente(self, pid: int, t: float, s: float = 2.0) -> bool:
        """True si la persona saludó en los últimos `s` segundos (para mostrarlo en el overlay)."""
        st = self.personas.get(pid)
        return st is not None and t - st.t_saludo <= s

    # -------------------------------------------------------------- ME_MIRA
    def _filtrar_mira(self, pid: int, st: _Persona, crudo: bool, t: float) -> None:
        self._filtrar(pid, st.mira, crudo, t, self.mira_on, self.mira_off, "ME_MIRA")

    def _filtrar(self, pid: int, m: _Mira, crudo: bool, t: float, t_on: float, t_off: float, nombre: str) -> None:
        """Histéresis temporal: el valor filtrado cambia sólo si el crudo se mantiene distinto t_on / t_off."""
        if crudo == m.activo:
            m.desde = None
            return
        if m.desde is None:
            m.desde = t
        if t - m.desde >= (t_on if crudo else t_off):
            m.activo, m.desde = crudo, None
            self.log(t, f"EVENTO {nombre} persona={pid} {'SI' if crudo else 'NO'}")

    # -------------------------------------------------------------- CAMISETA
    def _camiseta(self, pid: int, st: _Persona, clase: str | None, t: float) -> None:
        if st.camiseta is None:
            st.camiseta = FiltroCamiseta(self.cam_on, self.cam_off)
        antes = st.camiseta.activa
        ahora = st.camiseta.actualizar(clase)
        if ahora != antes:
            if antes:
                self.log(t, f"EVENTO CAMISETA_{antes} persona={pid} NO")
            if ahora:
                self.log(t, f"EVENTO CAMISETA_{ahora} persona={pid} SI")

    # -------------------------------------------------------------- SALIENDO
    def _saliendo_crudo(self, st: _Persona, p, w: World, ref, t: float) -> bool:
        st.us = [(tu, u) for tu, u in st.us if t - tu <= 0.4 and tu < t] + [(t, p.u)]
        (t0, u0), vel = st.us[0], 0.0
        if t > t0:
            vel = (p.u - u0) / (t - t0)
        margen = self.borde * w.img_w
        if p.u > w.img_w - margen and vel > self.vel_min:   # cerca del borde derecho y yendo hacia él
            return True
        if p.u < margen and vel < -self.vel_min:            # idem izquierdo
            return True
        if ref is not None:  # el cuello no puede girar más y la persona sigue de ese lado
            lo, hi = self.lim_yaw
            if ref[0] >= hi - self.lim_margen and p.u > w.cx + margen:   # yaw + = derecha de la imagen
                return True
            if ref[0] <= lo + self.lim_margen and p.u < w.cx - margen:
                return True
        return False

    # -------------------------------------------------------------- SALUDO
    def _visible(self, kp: dict, nombre: str) -> tuple[float, float] | None:
        x, y, vis = kp.get(nombre, (0.0, 0.0, 0.0))
        return (x, y) if vis >= self.vis_min else None

    def _asociar(self, kp: dict, cajas: dict[int, tuple]) -> int | None:
        """La persona cuya caja contiene el punto medio de los hombros (o la nariz); la más cercana al centro."""
        hi, hd = self._visible(kp, "hombro_i"), self._visible(kp, "hombro_d")
        punto = ((hi[0] + hd[0]) / 2, (hi[1] + hd[1]) / 2) if hi and hd else self._visible(kp, "nariz")
        if punto is None:
            return None
        x, y = punto
        mejor, dist = None, float("inf")
        for pid, (x1, y1, x2, y2) in cajas.items():
            if x1 <= x <= x2 and y1 <= y <= y2:
                d = (x - (x1 + x2) / 2) ** 2 + (y - (y1 + y2) / 2) ** 2
                if d < dist:
                    mejor, dist = pid, d
        return mejor

    def _saludo(self, pid: int, st: _Persona, kp: dict, t: float) -> None:
        hi, hd = self._visible(kp, "hombro_i"), self._visible(kp, "hombro_d")
        if not (hi and hd):
            return
        ancho = abs(hi[0] - hd[0])
        if ancho < 1.0:
            return
        for lado, hombro in (("i", hi), ("d", hd)):
            mano, muneca = st.manos[lado], self._visible(kp, f"muneca_{lado}")
            arriba = muneca is not None and muneca[1] < hombro[1] - self.margen * ancho  # y crece hacia abajo
            if not arriba:
                if mano.abajo_desde is None:
                    mano.abajo_desde = t
                if t - mano.abajo_desde >= self.mano_abajo_s:  # bajó de verdad: se puede contar otro saludo
                    mano.reiniciar()
                    mano.armada = True
                continue
            mano.abajo_desde = None
            if not mano.armada:
                continue
            x = (muneca[0] - hombro[0]) / ancho
            if self._vaiven(mano, x, t):
                st.saludos += 1
                st.t_saludo = t
                mano.reiniciar()
                mano.armada = False
                self.log(t, f"EVENTO SALUDO persona={pid} mano={lado} (n.º {st.saludos})")

    def _vaiven(self, m: _Mano, x: float, t: float) -> bool:
        """Registra la muestra; True si ya hay suficientes vaivenes dentro de la ventana."""
        if m.extremo is None:
            m.extremo = x
        elif m.sentido == 0:
            if abs(x - m.extremo) >= self.amp:
                m.sentido, m.extremo = (1 if x > m.extremo else -1), x
        elif (x - m.extremo) * m.sentido > 0:
            m.extremo = x  # sigue en el mismo sentido: el extremo se corre
        elif abs(x - m.extremo) >= self.amp:  # volvió lo suficiente: cambio de sentido = vaivén
            m.sentido, m.extremo = -m.sentido, x
            m.vaivenes.append(t)
        m.vaivenes = [v for v in m.vaivenes if t - v <= self.ventana]
        return len(m.vaivenes) >= self.vaivenes_min
