HecVelaz/keepon-pro/firmware/keepon_fw/generado.h

// GENERADO por scripts/generar_firmware.py a partir de config.yaml y
// pruebas_buzzer/simulador_sonidos.html. No editar a mano: cambiar la fuente y volver a generar.
#pragma once
#include <stdint.h>

namespace gen {

const uint32_t WATCHDOG_MS = 500;

// Pin del I/O del módulo del buzzer (config.yaml: buzzer.pin).
const uint8_t PIN_BUZZER = 5;

// Volumen del buzzer: fracción del ciclo de trabajo máximo (1.0 = 50 %).
const double BUZZER_VOLUMEN = 0.12;

// Cuello, en orden yaw, pitch, roll [grados, °/s, °/s²]
const double LIM_MIN[3] = {-70.0, -20.0, -20.0};
const double LIM_MAX[3] = {70.0, 30.0, 20.0};
const double HOME[3] = {0.0, 0.0, 0.0};
const double VMAX[3] = {180.0, 120.0, 250.0};
const double AMAX[3] = {600.0, 400.0, 900.0};
// Curva S: pasos de 10 ms que se promedian por eje (neck.suavizado_s; 1 = trapecio solo).
const int VENTANA[3] = {10, 10, 15};

// Servos: pulso = centro + signo · grados / grados_por_us, recortado a [min, max] µs.
// grados_por_us: [lado de pulsos < 1500, lado de pulsos > 1500].
const double CENTRO_US[3] = {1500.0, 1500.0, 1500.0};
const double GPU[3][2] = {{0.13, 0.136}, {0.092, 0.092}, {0.092, 0.092}};
const uint16_t MIN_US[3] = {950, 1100, 1000};
const uint16_t MAX_US[3] = {2020, 1800, 2000};
const int8_t SIGNO[3] = {-1, -1, 1};
// Compensación de zona muerta [µs]: {al bajar el pulso, al subir el pulso}, según el sentido del
// último movimiento del eje.
const int16_t COMP_US[3][2] = {{0, 0}, {0, 0}, {0, 0}};

// Sonidos: {f_inicio_Hz, f_fin_Hz, duracion_ms}. Iguales: nota fija; distintas: barrido; 0: silencio.
struct Segmento { uint16_t f0, f1, ms; };
struct Sonido { const char *nombre; const Segmento *seg; uint16_t n; uint32_t total_ms; };

const Segmento SND_R2D2[] = {
  {1800, 3200, 90}, {0, 0, 30}, {2600, 2600, 45}, {3400, 3400, 45}, {2600, 2600, 45}, {3400, 3400, 45},
  {0, 0, 40}, {3000, 1400, 140}, {0, 0, 30}, {1500, 1500, 40}, {2200, 2200, 40}, {2900, 2900, 40},
  {3600, 3600, 60}, {0, 0, 50}, {2000, 3800, 120}, {3800, 2400, 80}, {0, 0, 40}, {2800, 2800, 35},
  {2000, 2000, 35}, {2800, 2800, 35}, {2000, 2000, 35}, {2800, 2800, 35}, {0, 0, 40}, {1600, 3000, 100},
  {3000, 3000, 60}, {0, 0, 30}, {3500, 1800, 160}, {0, 0, 55},
};
const Segmento SND_POLCA[] = {
  {1175, 1175, 429}, {0, 0, 15}, {1175, 1175, 96}, {0, 0, 15}, {1047, 1047, 96}, {0, 0, 15},
  {932, 932, 96}, {0, 0, 15}, {880, 880, 96}, {0, 0, 15}, {1175, 1175, 429}, {0, 0, 15},
  {1175, 1175, 96}, {0, 0, 15}, {1047, 1047, 96}, {0, 0, 15}, {932, 932, 96}, {0, 0, 15},
  {880, 880, 96}, {0, 0, 15}, {1175, 1175, 429}, {0, 0, 15}, {1175, 1175, 96}, {0, 0, 15},
  {1047, 1047, 96}, {0, 0, 15}, {932, 932, 96}, {0, 0, 15}, {880, 880, 96}, {0, 0, 15},
  {1175, 1175, 429}, {0, 0, 15}, {0, 0, 222}, {880, 880, 64}, {0, 0, 10}, {932, 932, 64},
  {0, 0, 10}, {988, 988, 64}, {0, 0, 10}, {1047, 1047, 133}, {0, 0, 15}, {932, 932, 133},
  {0, 0, 15}, {880, 880, 133}, {0, 0, 15}, {784, 784, 133}, {0, 0, 15}, {698, 698, 133},
  {0, 0, 15}, {659, 659, 133}, {0, 0, 15}, {698, 698, 133}, {0, 0, 15}, {880, 880, 133},
  {0, 0, 15}, {1047, 1047, 133}, {0, 0, 15}, {1397, 1397, 133}, {0, 0, 15}, {1319, 1319, 133},
  {0, 0, 15}, {1175, 1175, 133}, {0, 0, 15}, {1047, 1047, 133}, {0, 0, 15}, {932, 932, 133},
  {0, 0, 15}, {880, 880, 133}, {0, 0, 15}, {784, 784, 133}, {0, 0, 15}, {698, 698, 133},
  {0, 0, 15}, {659, 659, 133}, {0, 0, 15}, {698, 698, 848}, {0, 0, 40},
};
const Segmento SND_POLCA_CERRO[] = {
  {1047, 1047, 230}, {0, 0, 20}, {880, 880, 230}, {0, 0, 20}, {1047, 1047, 230}, {0, 0, 20},
  {1397, 1397, 230}, {0, 0, 20}, {1319, 1319, 230}, {0, 0, 20}, {1175, 1175, 230}, {0, 0, 20},
  {1047, 1047, 230}, {0, 0, 20}, {880, 880, 230}, {0, 0, 20}, {932, 932, 230}, {0, 0, 20},
  {784, 784, 230}, {0, 0, 20}, {932, 932, 230}, {0, 0, 20}, {1319, 1319, 230}, {0, 0, 20},
  {1175, 1175, 230}, {0, 0, 20}, {1047, 1047, 230}, {0, 0, 20}, {932, 932, 230}, {0, 0, 20},
  {784, 784, 230}, {0, 0, 20}, {880, 880, 230}, {0, 0, 20}, {1047, 1047, 230}, {0, 0, 20},
  {1397, 1397, 230}, {0, 0, 20}, {1760, 1760, 230}, {0, 0, 20}, {1568, 1568, 230}, {0, 0, 20},
  {1319, 1319, 230}, {0, 0, 20}, {1397, 1397, 230}, {0, 0, 20}, {1397, 1397, 230}, {0, 0, 20},
};
const Segmento SND_ABUCHEO[] = {
  {1575, 1374, 60}, {1374, 1464, 60}, {1464, 1278, 60}, {1278, 1362, 60}, {1362, 1188, 60}, {1188, 1266, 60},
  {1266, 1105, 60}, {1105, 1177, 60}, {1177, 1027, 60}, {1027, 1095, 60}, {1095, 955, 60}, {955, 1018, 60},
  {1018, 888, 60}, {888, 946, 60}, {946, 826, 60}, {826, 880, 60}, {880, 768, 60}, {768, 818, 60},
  {818, 714, 60}, {714, 761, 60}, {761, 664, 60}, {664, 707, 60}, {707, 617, 60}, {617, 658, 60},
  {658, 574, 60}, {574, 612, 60}, {612, 534, 60}, {534, 569, 60}, {569, 496, 60}, {496, 529, 60},
  {529, 461, 60}, {461, 492, 60}, {492, 429, 60}, {429, 457, 60}, {457, 399, 60}, {399, 425, 60},
  {425, 371, 60}, {371, 395, 60}, {395, 345, 60}, {345, 368, 60}, {0, 0, 100},
};
const Segmento SND_PIROPO[] = {
  {1400, 2900, 180}, {0, 0, 90}, {1500, 3000, 220}, {3000, 3000, 120}, {3000, 1900, 450}, {0, 0, 140},
};
const Segmento SND_DESAPROBACION[] = {
  {700, 700, 250}, {0, 0, 60}, {520, 520, 120}, {520, 380, 300}, {0, 0, 70},
};
const Segmento SND_BEEP_NEUTRO[] = {
  {2400, 2400, 180}, {0, 0, 70},
};
const Segmento SND_BEEP_TIMIDO[] = {
  {2000, 2000, 110}, {0, 0, 50}, {1600, 1600, 150}, {0, 0, 40},
};
const Segmento SND_BEEP_ATREVIDO[] = {
  {2200, 2200, 90}, {0, 0, 40}, {3300, 3300, 180}, {0, 0, 40},
};
const Segmento SND_BEEP_MALEDUCADO[] = {
  {2600, 2600, 30}, {3400, 3400, 30}, {2600, 2600, 30}, {3400, 3400, 30}, {2600, 2600, 30}, {3400, 3400, 30},
  {2600, 2600, 30}, {3400, 3400, 30}, {2600, 2600, 30}, {3400, 3400, 30}, {3400, 1800, 120}, {0, 0, 30},
};

const int NUM_SONIDOS = 10;
const Sonido SONIDOS[NUM_SONIDOS] = {
  {"R2D2", SND_R2D2, 28, 1600},
  {"POLCA", SND_POLCA, 77, 7104},
  {"POLCA_CERRO", SND_POLCA_CERRO, 48, 6000},
  {"ABUCHEO", SND_ABUCHEO, 41, 2500},
  {"PIROPO", SND_PIROPO, 6, 1200},
  {"DESAPROBACION", SND_DESAPROBACION, 5, 800},
  {"BEEP_NEUTRO", SND_BEEP_NEUTRO, 2, 250},
  {"BEEP_TIMIDO", SND_BEEP_TIMIDO, 4, 350},
  {"BEEP_ATREVIDO", SND_BEEP_ATREVIDO, 4, 350},
  {"BEEP_MALEDUCADO", SND_BEEP_MALEDUCADO, 12, 450},
};

}  // namespace gen
