HecVelaz/keepon-pro/keepon/behaviors.py

"""Comportamientos (T5). Cada uno:
  - propose(ctx): mira el mundo y devuelve propuestas al árbitro (no actúa).
  - on_start / on_cancel: el árbitro le concedió o quitó los recursos.
  - act(g, ctx): se llama en cada ciclo MIENTRAS es dueño; ordena a los actuadores.
Ningún comportamiento escribe al puerto serie directamente.

Observador, Seguimiento (con inclinación de curiosidad), Saludo, Camiseta, Modo (Tímido / Atrevido /
Maleducado) y Operador (sonido de confirmación del cambio de modo).
"""

from __future__ import annotations

import math
from dataclasses import dataclass

from .arbiter import BUZZER, NECK, Arbiter, Grant, Proposal
from .actuators import Actuators
from .gaze import Focus, GazeController
from .world import World


@dataclass
class Context:
    now: float
    dt: float
    world: World
    act: Actuators
    arb: Arbiter
    focus: Focus
    cfg: dict
    modo: str = "NEUTRO"   # modo de personalidad actual (T5): NEUTRO | TIMIDO | ATREVIDO | MALEDUCADO
    # Posición del cuello (yaw, pitch, roll) [°] en el instante en que se capturó el cuadro de `world`.
    # La usa la mirada por objetivo (gaze.py) para compensar el atraso de la percepción. None: no se sabe.
    cuello_captura: tuple[float, float, float] | None = None


class Behavior:
    name = "?"

    def __init__(self, cfg: dict):
        self.cfg = cfg
        self.priority = cfg["priorities"][self.name]

    def propose(self, ctx: Context) -> list[Proposal]:
        return []

    def on_start(self, g: Grant, ctx: Context) -> None: ...
    def on_cancel(self, g: Grant, ctx: Context) -> None: ...
    def act(self, g: Grant, ctx: Context) -> None: ...


def minimo_jerk(tau: float) -> float:
    """Curva de mínimo jerk de 0 a 1 (tau en [0, 1], se recorta): s = 10τ³ − 15τ⁴ + 6τ⁵. Arranca y termina con
    velocidad Y aceleración nulas (el coseno arranca con aceleración ≠ 0: un tirón). Velocidad pico 1,875·D/T
    a la mitad; aceleración pico 5,77·D/T²."""
    t = min(1.0, max(0.0, tau))
    return t * t * t * (10.0 + t * (-15.0 + 6.0 * t))


@dataclass
class Tramo:
    """Un tramo del movimiento del Observador (modo "exploracion").
    - "suave":  yaw y pitch de `desde` a `hacia` con mínimo jerk en `dur` s (el roll va directo a hacia[2]).
    - "sacada": salta a `hacia` y el firmware hace el movimiento rápido y firme; se queda ahí hasta `dur`.
    - "quieto": se queda en `hacia` durante `dur`."""
    tipo: str
    hacia: tuple
    dur: float
    desde: tuple = ()
    t0: float = 0.0

    def referencia(self, now: float) -> tuple:
        if self.tipo != "suave":
            return self.hacia
        k = minimo_jerk((now - self.t0) / self.dur)
        yaw, pitch = (a + (b - a) * k for a, b in zip(self.desde[:2], self.hacia[:2]))
        return (yaw, pitch, self.hacia[2])


class Observer(Behavior):
    """Sin personas: mira la escena. Tres modos (observer.modo de config.yaml):
    - "exploracion" (08/11, el de la Tabla 1 de la guía: "centra la vista y explora la escena: barridos
      lentos, sacadas a puntos de interés, pequeñas variaciones de roll para encuadrar"). Una cola de
      tramos (Tramo):
        1. Si la cabeza quedó lejos del centro (donde estaba la última persona: es un punto de interés),
           la sostiene fijacion_s; después va suave al centro (centrar_s) y se queda pausa_centro_s.
        2. Barridos lentos y continuos de un extremo (±amp_deg) al otro a vel_barrido °/s de media, con
           mínimo jerk: no se para en el medio, solo frena para dar la vuelta. Roll en 0.
        3. Cada sacada_cada barridos, una sacada (rápida, con el perfil del firmware) al próximo punto de
           puntos_interes, que fija fijacion_s con su roll chico; desde ahí sigue barriendo hacia el extremo
           más lejano. El roll siempre pasa por 0 entre dos puntos (nunca de un lado al otro).
    - "miradas": va a un punto de observer.miradas, se queda quieto y pasa al siguiente (pausa_s por
      punto, contando el movimiento). Yaw y pitch van de un punto al otro con la curva de mínimo jerk en
      transicion_s (08/11: "más suave al buscar"); el roll va directo con el perfil del firmware (son
      ±5°: repartidos en transicion_s, la banda muerta del MG996R lo haría avanzar a saltitos).
      transicion_s = 0: todo salta y el firmware hace el movimiento (como el 05/11). Secuencia (Tabla 1:
      "centra la vista y explora la escena"):
      quieto donde quedó la cabeza (pausa_s) → centro (HOME, pausa_s) → la mirada más cercana al centro
      y de ahí en orden. Si ya está en el centro (al arrancar), empieza por el centro. Cada mirada puede
      traer un roll chico [yaw, pitch, roll] para "encuadrar".
    - "barrido": barrido lento y continuo (senoide), arranca desde donde está la cabeza."""
    name = "OBSERVADOR"

    def propose(self, ctx):
        if ctx.focus.target is None:
            return [Proposal(self.name, self.priority, frozenset({NECK}), continuous=True)]
        return []

    def on_start(self, g, ctx):
        o = self.cfg["observer"]
        self.t0 = ctx.now
        if o.get("modo", "barrido") == "exploracion":
            e = o["exploracion"]
            self.home = tuple(self.cfg["neck"]["home"])
            inicio = tuple(ctx.act.ref)
            self.cola: list[Tramo] = []
            if any(abs(a - b) > 2.0 for a, b in zip(inicio, self.home)):   # quedó mirando donde estaba alguien
                self.cola += [Tramo("quieto", inicio, e["fijacion_s"]), Tramo("suave", self.home, e["centrar_s"])]
            self.cola.append(Tramo("quieto", self.home, e["pausa_centro_s"]))
            self.tramo: Tramo | None = None
            self.barridos = 0                 # barridos desde la última sacada
            self.i_punto = 0
            self.lado = -1                    # el primer barrido va hacia la izquierda (yaw −)
            return
        if o.get("modo", "barrido") == "miradas":
            self.home = tuple(self.cfg["neck"]["home"])
            self.inicio = tuple(ctx.act.ref)
            # Fases: "quieto" (donde quedó) → "centro" → índice de la mirada. Ya centrado: directo al centro.
            centrado = all(abs(a - b) <= 2.0 for a, b in zip(self.inicio, self.home))
            self.fase = "centro" if centrado else "quieto"
            self.t_mirada = ctx.now
            self.desde = self.inicio                      # de dónde sale la transición en curso
            return
        # Fase inicial tal que el barrido empiece en el yaw actual (sin salto).
        s = max(-1.0, min(1.0, ctx.act.ref[0] / o["yaw_amp"]))
        self.phase0 = math.asin(s)
        self.start_pitch = ctx.act.ref[1]

    def _siguiente_tramo(self, ref: tuple) -> Tramo:
        """Después de la cola inicial: barridos de extremo a extremo y, cada sacada_cada, una sacada."""
        e = self.cfg["observer"]["exploracion"]
        puntos = [(p[0], p[1], p[2] if len(p) > 2 else 0.0) for p in e["puntos_interes"]]
        if self.barridos >= e["sacada_cada"] and puntos:
            self.barridos = 0
            p = puntos[self.i_punto % len(puntos)]
            self.i_punto += 1
            self.lado = -1 if p[0] > 0 else 1                 # después, hacia el extremo más lejano
            return Tramo("sacada", p, e["fijacion_s"])
        yaw = self.lado * e["amp_deg"]
        self.lado = -self.lado
        self.barridos += 1
        dur = max(0.5, abs(yaw - ref[0]) / e["vel_barrido"])  # velocidad media pedida (pico 1,875 veces)
        return Tramo("suave", (yaw, e["pitch_barrido"], 0.0), dur)

    def act(self, g, ctx):
        o = self.cfg["observer"]
        if o.get("modo", "barrido") == "exploracion":
            if self.tramo is None or ctx.now - self.tramo.t0 >= self.tramo.dur:  # terminó: el siguiente
                ref = tuple(ctx.act.ref)
                self.tramo = self.cola.pop(0) if self.cola else self._siguiente_tramo(ref)
                self.tramo.desde, self.tramo.t0 = ref, ctx.now                 # sale de la última referencia
            ctx.act.neck(g, *self.tramo.referencia(ctx.now))
            return
        if o.get("modo", "barrido") == "miradas":
            puntos = [(p[0], p[1], p[2] if len(p) > 2 else 0.0) for p in o["miradas"]]
            if ctx.now - self.t_mirada >= o["pausa_s"]:   # terminó la pausa: a lo siguiente
                if self.fase == "quieto":
                    self.fase = "centro"
                elif self.fase == "centro":               # la primera mirada: la más cercana al centro
                    self.fase = min(range(len(puntos)), key=lambda k: abs(puntos[k][0] - self.home[0]))
                else:
                    self.fase = (self.fase + 1) % len(puntos)
                self.t_mirada = ctx.now
                self.desde = tuple(ctx.act.ref)           # la transición sale de la última referencia
            destino = {"quieto": self.inicio, "centro": self.home}.get(self.fase) or puntos[self.fase]
            T = o.get("transicion_s", 0.0)
            k = minimo_jerk((ctx.now - self.t_mirada) / T) if T > 0 else 1.0
            yaw, pitch = (a + (b - a) * k for a, b in zip(self.desde[:2], destino[:2]))
            ctx.act.neck(g, yaw, pitch, destino[2])       # al terminar, el mismo J hasta la próxima: quieto
            return
        ph = self.phase0 + 2 * math.pi * (ctx.now - self.t0) / o["period_s"]
        blend = min(1.0, (ctx.now - self.t0) / 2.0)  # pitch vuelve suave en 2 s
        pitch = (1 - blend) * self.start_pitch + blend * o["pitch_amp"] * math.sin(2 * ph)
        ctx.act.neck(g, o["yaw_amp"] * math.sin(ph), pitch, 0.0)


class Tracking(Behavior):
    """Eye contact con el objetivo del foco (T3 + T4), con inclinación de curiosidad (T3 d).

    Inclinación: si el objetivo se queda quieto durante quieto_s, el roll va a ±amp_deg (alternando el
    lado), lo sostiene sostener_s y vuelve a 0. Si la persona se mueve antes, vuelve enseguida. Después
    espera espera_s. Yaw y pitch siguen igual. "Quieto": la dirección de la persona (ángulo comandado del
    cuello + error en la imagen) no se aparta más de movimiento_max_deg de donde estaba al empezar a contar;
    así una pequeña oscilación de la cabeza alrededor de la persona no reinicia la cuenta."""
    name = "SEGUIMIENTO"

    def __init__(self, cfg):
        super().__init__(cfg)
        self.gaze = GazeController(cfg)
        self.cur = cfg["curiosidad"]
        self.lado = 1                    # próximo lado de la inclinación (+1 = horario visto desde atrás)
        self.espera_hasta = -1e9
        self.quieto_desde = self.incl_desde = None
        self.ancla = (0.0, 0.0)          # dirección de la persona [°] cuando empezó a estar quieta
        self.incl_lado = 0

    def propose(self, ctx):
        if ctx.focus.target is not None:
            return [Proposal(self.name, self.priority, frozenset({NECK}), continuous=True, person=ctx.focus.target)]
        return []

    def on_start(self, g, ctx):
        self.gaze.reset()
        self.quieto_desde = self.incl_desde = None

    def on_cancel(self, g, ctx):
        if self.incl_desde is not None:  # otro comportamiento (o el STOP) tomó el cuello estando inclinada
            ctx.act.log(ctx.now, f"CURIOSIDAD persona={g.person} interrumpida por otro comportamiento")
            self.espera_hasta = ctx.now + self.cur["espera_s"]
        self.quieto_desde = self.incl_desde = None

    def act(self, g, ctx):
        p = ctx.world.visible(g.person)
        if p is None:
            return  # pérdida momentánea: mantener la mirada (el foco la libera a los lost_hold_s)
        y, pi, _ = self.gaze.update(ctx.act.ref, p, ctx.world, ctx.dt, ctx.cuello_captura)
        # El roll va a la inclinación o a 0; la trayectoria del firmware lo hace suave (vmax/amax de roll).
        ctx.act.neck(g, y, pi, self._roll(g, ctx))

    def _roll(self, g, ctx) -> float:
        c, now = self.cur, ctx.now
        direccion = (ctx.act.ref[0] + self.gaze.ex, ctx.act.ref[1] + self.gaze.ey)  # adónde está la persona
        if self.quieto_desde is None:
            self.ancla = direccion
        centrado = all(abs(d - a) <= c["movimiento_max_deg"] for d, a in zip(direccion, self.ancla))
        if self.incl_desde is not None:  # inclinada
            if centrado and now - self.incl_desde < c["sostener_s"]:
                return self.incl_lado * c["amp_deg"]
            motivo = "fin" if centrado else "la persona se movió"
            ctx.act.log(now, f"CURIOSIDAD persona={g.person} vuelve a 0 ({motivo})")
            self.incl_desde = self.quieto_desde = None
            self.espera_hasta = now + c["espera_s"]
            return 0.0
        if not centrado:  # se movió: la cuenta empieza de nuevo desde la dirección actual
            self.quieto_desde, self.ancla = now, direccion
            return 0.0
        if self.quieto_desde is None:
            self.quieto_desde = now
        if c["activa"] and now - self.quieto_desde >= c["quieto_s"] and now >= self.espera_hasta:
            self.incl_desde, self.incl_lado, self.lado = now, self.lado, -self.lado
            ctx.act.log(now, f"CURIOSIDAD persona={g.person} inclina roll {self.incl_lado * c['amp_deg']:+.0f}°")
            return self.incl_lado * c["amp_deg"]
        return 0.0


class Greeting(Behavior):
    """SALUDO -> asiente 2-3 veces + R2D2. No interrumpible (acción corta)."""
    name = "SALUDO"

    WINDOW_S = 0.5  # un gesto se responde dentro de esta ventana o se descarta

    def __init__(self, cfg):
        super().__init__(cfg)
        self.seen: dict[int, int] = {}                 # persona -> último wave_count ya consumido
        self.pending: dict[int, tuple[int, float]] = {}  # persona -> (wave_count, t_detectado)

    def propose(self, ctx):
        out = []
        for p in ctx.world.persons.values():
            if not ctx.world.visible(p.id):
                continue
            last = self.seen.setdefault(p.id, p.wave_count)
            if p.wave_count > last and self.pending.get(p.id, (None,))[0] != p.wave_count:
                self.pending[p.id] = (p.wave_count, ctx.now)
            if p.id not in self.pending:
                continue
            count, t_det = self.pending[p.id]
            if ctx.now > t_det + self.WINDOW_S:  # no se pudo responder a tiempo (cooldown/ocupado)
                self.seen[p.id] = count
                del self.pending[p.id]
                continue
            out.append(Proposal(self.name, self.priority, frozenset({NECK, BUZZER}),
                                interruptible_by=0, person=p.id, expires=t_det + self.WINDOW_S,
                                cooldown=(("SALUDO", p.id), self.cfg["cooldowns"]["SALUDO_por_persona"]),
                                params={"wave": count}))
        return out

    def on_start(self, g, ctx):
        self.seen[g.person] = g.params["wave"]
        self.pending.pop(g.person, None)
        self.t0, self.base = ctx.now, list(ctx.act.ref)
        ctx.act.play(g, "R2D2")

    def act(self, g, ctx):
        c = self.cfg["greeting"]
        t = ctx.now - self.t0
        dur = c["nods"] * c["nod_period_s"]
        if t < dur:
            nod = c["nod_amp"] * math.sin(math.pi * t / c["nod_period_s"]) ** 2  # sólo hacia abajo
            ctx.act.neck(g, self.base[0], self.base[1] - nod, self.base[2])
        else:
            ctx.act.neck(g, *self.base)
            if ctx.act.sound_finished(g):
                ctx.arb.finish(g.id, ctx.now)
            elif t > dur + self.cfg["sounds"]["R2D2"] + 0.5:  # sin DONE: cortar antes de soltar el buzzer
                ctx.act.cancel_sound()
                ctx.arb.finish(g.id, ctx.now)


class Shirt(Behavior):
    """CAMISETA_OLIMPIA -> polca; CAMISETA_CERRO -> abucheo. Sólo usa el buzzer,
    así que convive con el seguimiento. Interrumpible sólo por prioridad 0-1. Una vez por aparición de
    cada persona (cooldowns.CAMISETA_por_persona: null); si la interrumpen (p. ej. un saludo), no se
    repite: el cooldown se registra al empezar."""
    name = "CAMISETA"
    SOUND = {"OLIMPIA": "POLCA", "CERRO": "ABUCHEO"}

    def propose(self, ctx):
        out = []
        # cooldowns.CAMISETA_por_persona: null = una vez por aparición (el cooldown por ID no vence nunca: el
        # tracker no reusa IDs y quien vuelve después de irse recibe uno nuevo).
        espera = self.cfg["cooldowns"]["CAMISETA_por_persona"]
        espera = math.inf if espera is None else espera
        for p in ctx.world.persons.values():
            if ctx.world.visible(p.id) and p.shirt in self.SOUND:
                out.append(Proposal(self.name, self.priority, frozenset({BUZZER}),
                                    interruptible_by=1, person=p.id, expires=ctx.now + 0.3,
                                    cooldown=(("CAMISETA", p.id), espera),
                                    params={"sound": self.SOUND[p.shirt]}))
        return out

    def on_start(self, g, ctx):
        self.t0 = ctx.now
        ctx.act.play(g, g.params["sound"])

    def act(self, g, ctx):
        if ctx.act.sound_finished(g):
            ctx.arb.finish(g.id, ctx.now)
        elif ctx.now - self.t0 > self.cfg["sounds"][g.params["sound"]] + 0.5:  # sin DONE: cortar y soltar
            ctx.act.cancel_sound()
            ctx.arb.finish(g.id, ctx.now)


MODOS = ("NEUTRO", "TIMIDO", "ATREVIDO", "MALEDUCADO")


class ConfirmaModo(Behavior):
    """Comando del operador: confirma el cambio de modo con un sonido breve distintivo (BEEP_<MODO>), o
    reproduce un sonido a pedido (prueba del buzzer). Prioridad 0, sólo el buzzer: no le quita el cuello
    a nadie.

    El último pedido gana: si llega otro mientras suena uno del operador, se corta el que suena y en el
    ciclo siguiente arranca el nuevo. (Antes el árbitro tomaba el pedido nuevo como una "renovación" del
    mismo comportamiento y, al vencer su segundo de espera, se descartaba sin aviso.)"""
    name = "OPERADOR"

    def __init__(self, cfg):
        super().__init__(cfg)
        self.pedido: tuple[str, float] | None = None  # (sonido, instante del pedido)

    def pedir(self, modo: str, now: float) -> None:
        self.pedir_sonido(f"BEEP_{modo}", now)

    def pedir_sonido(self, sonido: str, now: float) -> None:
        self.pedido = (sonido, now)

    def propose(self, ctx):
        if self.pedido is None:
            return []
        sonido, t = self.pedido
        if ctx.now > t + 1.0:  # no se pudo (p. ej. con STOP): se descarta, y queda en el log
            ctx.act.log(ctx.now, f"OPERADOR sonido {sonido} descartado (no se pudo tomar el buzzer en 1 s)")
            self.pedido = None
            return []
        return [Proposal(self.name, self.priority, frozenset({BUZZER}), interruptible_by=0,
                         expires=t + 1.0, params={"sound": sonido})]

    def on_start(self, g, ctx):
        self.pedido, self.t0 = None, ctx.now
        ctx.act.play(g, g.params["sound"])

    def act(self, g, ctx):
        if self.pedido is not None:  # el último gana: llegó otro pedido mientras sonaba éste
            ctx.act.log(ctx.now, f"OPERADOR corta {g.params['sound']}: pidieron {self.pedido[0]}")
            ctx.act.cancel_sound()
            ctx.arb.finish(g.id, ctx.now)
        elif ctx.act.sound_finished(g):
            ctx.arb.finish(g.id, ctx.now)
        elif ctx.now - self.t0 > self.cfg["sounds"][g.params["sound"]] + 0.5:
            ctx.act.cancel_sound()
            ctx.arb.finish(g.id, ctx.now)


class DemoEjes(Behavior):
    """Comando del operador (botón "Ejes"): muestra los tres ejes (yaw, pitch y roll) con la secuencia de
    ejes.secuencia de config.yaml y vuelve a HOME. Prioridad 0 y sólo el cuello: nadie lo interrumpe salvo el
    STOP o el HOME del operador; el buzzer sigue libre. Episódico: al terminar suelta el cuello y retoman el
    Observador o el seguimiento. Yaw y pitch van con mínimo jerk; el roll, con el perfil del firmware."""
    name = "EJES"

    def __init__(self, cfg):
        super().__init__(cfg)
        self.pedido: float | None = None  # instante del pedido

    def pedir(self, now: float) -> None:
        self.pedido = now

    def propose(self, ctx):
        if self.pedido is None:
            return []
        if ctx.now > self.pedido + 1.0:  # no se pudo tomar el cuello (p. ej. con STOP): queda en el log
            ctx.act.log(ctx.now, "EJES descartado (no se pudo tomar el cuello en 1 s)")
            self.pedido = None
            return []
        return [Proposal(self.name, self.priority, frozenset({NECK}), expires=self.pedido + 1.0)]

    def on_start(self, g, ctx):
        self.pedido = None
        e = self.cfg["ejes"]
        self.tramos = []
        for yaw, pitch, roll, dur in e["secuencia"]:
            self.tramos += [Tramo("suave", (yaw, pitch, roll), dur), Tramo("quieto", (yaw, pitch, roll), e["pausa_s"])]
        self.tramo = None

    def act(self, g, ctx):
        if self.tramo is None or ctx.now - self.tramo.t0 >= self.tramo.dur:  # terminó: el siguiente
            if not self.tramos:
                ctx.arb.finish(g.id, ctx.now)
                return
            self.tramo = self.tramos.pop(0)
            self.tramo.desde, self.tramo.t0 = tuple(ctx.act.ref), ctx.now
        ctx.act.neck(g, *self.tramo.referencia(ctx.now))


class Mode(Behavior):
    """Reacción del modo de personalidad sobre la persona que se sigue (T5, prioridad 3):

    - TIMIDO: si lo mira (ME_MIRA), desvía la mirada hacia un costado y abajo, la sostiene y vuelve a
      espiar gradualmente (cuello).
    - ATREVIDO: si lo mira, levanta el mentón varias veces (pitch hacia arriba) sin dejar de seguirla
      en yaw (cuello).
    - MALEDUCADO: si la persona seguida está SALIENDO, le silba un piropo, una vez por salida y como
      mucho uno cada PIROPO_global segundos entre todos (buzzer: convive con el seguimiento).
    NEUTRO no propone nada: sólo sostiene el contacto visual (el seguimiento)."""
    name = "MODO"

    def __init__(self, cfg):
        super().__init__(cfg)
        self.m = cfg["modos"]
        self.gaze = GazeController(cfg)
        self.saliendo_antes: dict[int, bool] = {}  # para detectar el flanco de SALIENDO (una vez por salida)
        self.lado = 1

    def propose(self, ctx):
        pid = ctx.focus.target
        p = ctx.world.visible(pid)
        if p is None:
            return []
        if ctx.modo == "TIMIDO" and p.looking:
            c = self.m["timido"]
            return [Proposal(self.name, self.priority, frozenset({NECK}), person=pid, expires=ctx.now + 0.3,
                             cooldown=(("TIMIDO", pid), c["sostener_s"] + c["regreso_s"] + c["espera_s"]),
                             params={"reaccion": "TIMIDO"})]
        if ctx.modo == "ATREVIDO" and p.looking:
            c = self.m["atrevido"]
            return [Proposal(self.name, self.priority, frozenset({NECK}), person=pid, expires=ctx.now + 0.3,
                             cooldown=(("ATREVIDO", pid), c["veces"] * c["periodo_s"] + c["espera_s"]),
                             params={"reaccion": "ATREVIDO"})]
        antes, ahora = self.saliendo_antes.get(pid, False), p.leaving
        self.saliendo_antes[pid] = ahora
        if ctx.modo == "MALEDUCADO" and ahora and not antes:  # flanco: empieza una salida
            return [Proposal(self.name, self.priority, frozenset({BUZZER}), person=pid, expires=ctx.now + 0.5,
                             interruptible_by=1, cooldown=(("PIROPO",), self.cfg["cooldowns"]["PIROPO_global"]),
                             params={"reaccion": "MALEDUCADO", "sound": "PIROPO"})]
        return []

    def on_start(self, g, ctx):
        self.t0, self.base = ctx.now, list(ctx.act.ref)
        r = g.params["reaccion"]
        if r == "TIMIDO":
            # Hacia el costado que deja más lugar dentro de los límites de yaw; alterna si están parejos.
            self.lado = -1 if self.base[0] > 5 else 1 if self.base[0] < -5 else -self.lado
        elif r == "ATREVIDO":
            self.gaze.reset()
        elif r == "MALEDUCADO":
            ctx.act.play(g, g.params["sound"])
        ctx.act.log(ctx.now, f"MODO reacción {r} persona={g.person}")

    def act(self, g, ctx):
        t = ctx.now - self.t0
        r = g.params["reaccion"]
        if r == "TIMIDO":
            c = self.m["timido"]
            # 1) desvía y sostiene; 2) vuelve de a poco (espía), con una curva suave (coseno) de 1 a 0.
            k = 1.0 if t < c["sostener_s"] else 0.5 * (1 + math.cos(math.pi * min(1.0, (t - c["sostener_s"]) / c["regreso_s"])))
            ctx.act.neck(g, self.base[0] + self.lado * k * c["desvio_yaw_deg"],
                         self.base[1] - k * c["desvio_pitch_deg"], self.base[2] + self.lado * k * c["desvio_roll_deg"])
            if t >= c["sostener_s"] + c["regreso_s"]:
                ctx.arb.finish(g.id, ctx.now)
        elif r == "ATREVIDO":
            c = self.m["atrevido"]
            dur = c["veces"] * c["periodo_s"]
            y = self.base[0]
            p = ctx.world.visible(g.person)
            if p is not None:  # sigue en yaw (el pitch lo maneja el gesto)
                y = self.gaze.update(ctx.act.ref, p, ctx.world, ctx.dt, ctx.cuello_captura)[0]
            menton = c["menton_deg"] * math.sin(math.pi * min(t, dur) / c["periodo_s"]) ** 2  # sólo hacia arriba
            ctx.act.neck(g, y, self.base[1] + menton, self.base[2])
            if t >= dur:
                ctx.arb.finish(g.id, ctx.now)
        elif r == "MALEDUCADO":
            if ctx.act.sound_finished(g):
                ctx.arb.finish(g.id, ctx.now)
            elif t > self.cfg["sounds"][g.params["sound"]] + 0.5:
                ctx.act.cancel_sound()
                ctx.arb.finish(g.id, ctx.now)


def default_behaviors(cfg: dict) -> list[Behavior]:
    return [Observer(cfg), Tracking(cfg), Greeting(cfg), Shirt(cfg), Mode(cfg), ConfirmaModo(cfg), DemoEjes(cfg)]
