HecVelaz/keepon-pro/(commit log)

2026-09-30 M0: protocolo, ESP32 simulado, árbitro, comportamientos base, control de mirada y benchmark
    - Protocolo serie PC/Pi <-> ESP32-S3 (docs/PROTOCOLO.md) y simulador como especificación ejecutable del firmware
    - Trayectorias suaves con frenado discreto exacto (vmax, amax, límites)
    - Árbitro: recursos exclusivos, prioridades, adquisición atómica, cooldowns, STOP enclavado
    - Observador, Seguimiento, Saludo, Camiseta; control de mirada P con zona muerta suave; foco con histéresis
    - Escenario sintético con cámara virtual en lazo cerrado, 37 tests
    - Benchmark de percepción (YOLOv8n NCNN + MediaPipe) y diagnóstico para Raspberry Pi 5
    - Docs: enunciado en Markdown, hoja de ruta v3, revisión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
2026-09-30 Corrige los 8 fallos de la revisión de Codex del M0
    - Trayectoria: planificación discreta exacta; amax se respeta en las posiciones emitidas
    - Sesión HELLO: detecta el reinicio del ESP32, cancela acciones, vuelve a HOME, preserva STOP
    - Protocolo: validación estricta de comandos y respuestas, sin excepciones sueltas
    - Cámara/mundo viejo: StaleFrame + edad máxima; no se sigue un cuadro congelado
    - Acciones episódicas con parámetros congelados; CANCEL antes de liberar por timeout
    - Deduplicación de sonidos por seq monótono dentro de la sesión
    - Foco: ME_MIRA con prioridad estricta
    - Benchmark: métrica renombrada a recepción -> resultado
    - 22 tests nuevos (63 en total), requirement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
    [actuators.py, arbiter.py, behaviors.py, benchmark.py, camera.py, config.yaml, gaze.py, link.py]
2026-10-01 Percepción en paralelo en la Pi 5: personas + rostros + pose a >= 10 Hz
    - Cámara vía ROS 2 (camera_ros) y config.local.yaml por máquina
    - keepon/perception.py: 2 procesos fijados a núcleos (YOLO26n 256 + rostros / pose)
    - Rostros sobre recortes de cabeza con BlazeFace + solvePnP con intrínsecos reales (ME_MIRA)
    - Tracker IoU propio: el de ultralytics costaba ~68 ms por cuadro
    - Benchmarks en la Pi (scripts/benchmark.py, pi_bench.sh, perception_bench.py) y export de YOLO
    - Campo de visión corregido a 37,3° según la calibración; 81 tests
    - docs: ESTADO_PI.md, revisión de Codex sobre la Pi, CSV de mediciones
    [benchmark_pi_20260930_2personas.csv, benchmark_pi_20260930_sin_personas.csv]
2026-10-01 Visor de percepción en el navegador y CLAUDE.md con el estado del proyecto
    - scripts/ver_percepcion.py/.sh: overlay con IDs, ME_MIRA, pose y Hz por proceso, vía web_video_server
    - CLAUDE.md: contexto, hardware, acceso a la Pi, arquitectura, decisiones, comandos y próximos pasos
2026-10-07 Elige la cámara por nombre en los visores
    La segunda NoIR aparece en libcamera (sin transmitir) y corrió los índices:
    camera:=0 pasó a ser la cámara que no anda. ver_percepcion.sh y ver_personas.sh
    ahora usan el nombre del sensor en i2c@80000 (variable CAMARA para cambiarlo).
    ver_personas.sh pasa al repo (antes solo existía en la Pi).
2026-10-07 CLAUDE.md: documenta los dos visores de la Pi y el estado al 07/10
2026-10-07 Hojas de datos del ESP32-C3 y los servos SG90/MG90S, y revisión de hardware de Codex
2026-10-07 Pruebas de banco de los servos estándar y CLAUDE.md con la ESP32-C3
    - pruebas_servos/: conexionado con la ESP32-C3-DevKitM-1, procedimiento por
    servo, planilla de resultados y prueba_servo.ino (control por monitor serie).
    - Asignación propuesta: pitch HS-7955TG, yaw MG996R, roll MG995. El SM-S4315R
    es de rotación continua y no sirve como articulación.
    - Fuente de servos de 6 V; la ALP002 (1,5 A, entrada 100-120 V) solo para
    probar un servo sin carga.
    - CLAUDE.md: la placa es una ESP32-C3 (no S3), pines y servos actuales.
2026-10-07 ESP32-C3 flasheada con la prueba de servos y simulador de conexiones del HS-7955TG
    - simulador_hs7955tg.html: diagrama de conexiones con la fuente de laboratorio,
    ESP32 simulada con los mismos comandos que prueba_servo.ino, servo animado,
    fuente con límite de corriente y osciloscopio del PWM.
    - prueba_servo.ino compilado con arduino-cli (esp32 3.3.12) y cargado en la
    ESP32-C3 (clon CH340, /dev/ttyUSB0). El HS-7955TG se mueve en GPIO1 a 6 V.
    - CLAUDE.md: estado de las pruebas de servos, comandos de arduino-cli y por qué
    el giro es lento (rampa v 300 por defecto).
    - .gitignore: carpetas build/ de Arduino.
2026-10-09 Caracterización del HS-7955TG para pitch
    Planilla de pruebas_servos completa para el HS-7955TG: 0,090 °/µs lineal,
    límites electrónicos 750/2250 µs (≈ ±68°), banda muerta ≤ 2 µs, holgura
    ≤ 1°, 6 mA y silencioso en reposo. Sin pulso mantiene la posición con
    fuerza. Calibración en neck.servos.pitch de config.yaml. Yaw y roll quedan
    sin servo asignado.
2026-10-09 Confirma que el SM-S4315R es de rotación continua
2026-10-09 Caracterización del MG90S como servo provisorio de yaw
    Recorrido ≥ 177° sin tope (500–2450 µs), asimétrico: 0,090 °/µs en el
    lado de pulsos cortos y ~0,085 en el otro. Banda muerta 20–30 µs, sin
    holgura visible, 1 mA y silencioso en reposo, frío tras 5 min. Sin pulso
    queda flojo. Calibración en neck.servos.yaw con una pendiente por lado.
2026-10-09 Caracterización del SG90 para roll
    0,090 °/µs simétrico hasta ±45°, banda muerta 10–20 µs, sin holgura
    visible, 1 mA y silencioso en reposo, frío tras 5 min. Sin pulso queda
    flojo y da un tirón de pocos grados al encender. Calibración en
    neck.servos.roll: con esto los tres ejes tienen servo.
2026-10-09 Guía para manejar las pruebas de servos desde la terminal
    Monitor serie por la ruta by-id, tabla de comandos, secuencia rápida para
    un servo nuevo y lo aprendido el 09/10. El procedimiento suma las pruebas
    de velocidad del robot, sin señal y encendido.
2026-10-12 Caracterización del RDS3218 y sketch de prueba por grados
    - Planilla: el DSSERVO RDS3218 (de la pinza del recolector) es de posición,
    versión de 270°: −143° / +145° entre 500 y 2500 µs sin tope, 0,13 °/µs en
    el centro, banda muerta ≤ 2 µs, sin holgura y mantiene la posición sin
    pulso. Queda como candidato para yaw (±70° ≈ 960 / 2040 µs).
    - prueba_grados.ino: sketch de un compañero (ángulo por serie con
    ESP32Servo), con el pin 0 y sin mover el servo ante una entrada inválida.
2026-10-12 RDS3218 como servo de yaw
    - config.yaml: neck.servos.yaw pasa al RDS3218 (0,13 °/µs, límites
    950 / 2050 µs ≈ ±72°; sin tope, los límites protegen el cableado).
    - README de pruebas y CLAUDE.md: nueva asignación; el MG90S queda de repuesto.
2026-10-12 Caracterización del segundo RDS3218
    - Planilla: nueva columna "RDS3218 n.º 2" (la anterior pasa a "n.º 1").
    Recorrido −130° / +140° entre 500 y 2500 µs sin tope; 0,13 °/µs en el
    lado − y ≈ 0,14 en el lado + (±70° ≈ 960 / 2010 µs); banda muerta ≤ 2 µs
    hacia abajo y 4–6 µs hacia arriba; sin holgura; no zumba; frío tras 5 min
    de barrido (~80 mA de media, picos de ~1 A a v 2000). Sin pulso mantiene
    la posición con fuerza, igual que el n.º 1.
    - No es intercambiable con el n.º 1 sin recalibrar el extremo + de yaw.
2026-10-12 RDS3218 n.º 2 como servo de yaw
    - config.yaml: neck.servos.yaw pasa al n.º 2, asimétrico
    grados_por_us [0.13, 0.136] (lado < 1500, lado > 1500) y límites
    950 / 2020 µs (≈ ±71°). Se deja anotado el sentido (pulso mayor =
    antihorario visto desde arriba) y los datos del n.º 1.
    - README de pruebas y CLAUDE.md: nueva asignación; el n.º 1 y el MG90S
    quedan de repuesto. Los dos RDS3218 no son intercambiables sin recalibrar.
2026-10-12 RDS3218 n.º 1 como servo de roll y sentido de giro de los tres servos
    Roll pasa del SG90 al RDS3218 n.º 1 (0,13 °/µs simétrico, límites
    1000/2000 µs). Sentido medido el 12/10, visto de frente al eje: en los
    dos RDS3218, pulso mayor = antihorario; en el HS-7955TG, al revés. Con
    el pulso del pitch en espejo, yaw y pitch giran sincronizados.
    Con los tres juntos, el roll temblaba al arrancar el movimiento; solo
    anda bien. Sospecha: GND y alimentación compartidos por el protoboard.
2026-10-13 MG90S como servo de roll, roll en GPIO4 y descarte del RDS3218 n.º 1
    El RDS3218 n.º 1 vibra (≈ 0,5 A) al quedar quieto cerca de 1500 µs,
    sobre todo con el HS activo. Intercambiándolo con el n.º 2, la vibración
    sigue al servo: no es el pin, la señal ni el cableado. Queda descartado.
    Roll pasa al MG90S a 6 V (máximo de su hoja de datos): pulso mayor =
    antihorario, como los RDS3218. La señal de roll pasa de GPIO3 a GPIO4
    (sketch de prueba, simulador y planilla).
2026-10-13 Velocidad por eje en la prueba de servos, AGENTS.md y estado del 12/10
    prueba_servo.ino: comando `w` (velocidad solo del eje elegido) para que
    ejes con recorridos distintos lleguen juntos, y el sobrante del paso se
    usa al invertir el barrido (sin eso, cada eje redondeaba distinto en los
    extremos y se desfasaban ~10 ms por tramo). Probado con los tres servos a
    velocidad alta: sincronizados dentro de ~10 ms.
    CLAUDE.md: asignación final de servos (yaw RDS3218 n.º 2, pitch HS,
    roll MG90S), sentido de giro, descarte del RDS n.º 1 y estado de la
    sesión. AGENTS.md: resumen para otros agentes, remite a CLAUDE.md.
2026-10-13 MG996R como servo de roll y prueba de los tres servos juntos
    Caracterización del MG996R a 6 V: lineal y simétrico (0,092 °/µs), pero
    con una banda muerta de ~10° intermitente (de +10° a 0° no volvió en 3 de
    10 intentos). Se acepta para roll porque hace gestos grandes; el MG90S
    queda de repuesto. Los tres servos (RDS3218, HS-7955TG, MG996R) barren
    0 ↔ 45° a ~180 °/s sincronizados.
2026-10-13 Plan del firmware del robot para la próxima sesión
2026-10-14 Diagrama del sistema y modelo mecánico v2 con carcasa estilo Keepon
    docs/diagrama_sistema/index.html: diagrama eléctrico desde la LiPo 3S de
    8000 mAh (fusible, interruptor, reguladores separados de 6 V para los
    servos y 5,1 V para la Pi), por zonas: caja base fija, plataforma de yaw
    con la Pi, la ESP32-C3 y el pitch, y cabeza. Lista de lo que falta,
    conexionado, consumo y autonomía (~3-4 h).
    docs/keepon_v2_cad/: modelo paramétrico en CadQuery exportado a STEP
    (SolidWorks) y STL. La Pi va sobre la plataforma de yaw para que la cinta
    CSI no se tuerza; por el yaw cruzan solo cables redondos. Carcasa: cabeza
    esférica centrada en el cruce de pitch y roll (la abertura inferior se
    calcula bar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
    [0_ensamble_referencia.step, 1_base.step, 2_soporte_pan_U.step, 3_soporte_tilt_y_roll.step, 4_placa_cabeza_roll.step, 5_separador_pivote.step, cabeza_der.step, cabeza_der.stl]
2026-10-14 Modelo mecánico v3 con la Pi en la cabeza y revisión de arquitectura de Codex
    - docs/keepon_v3_cad: cabeza plana de 75 × 107 × 40 mm con la Pi 5 parada
    sobre la placa de roll y la cámara en un ojo. La cinta de 150 mm queda fija
    (una U de radio 6,5 mm) y no se mueve con yaw, pitch ni roll. Plato de yaw
    Ø146 en forma de D. Script con verificación de interferencias en 15 poses
    y vistas renderizadas con VTK.
    - docs/REVISION_CODEX_ARQ.md: ESP32 vs todo en la Pi, ubicación de la Pi
    por la cinta, forma de la cabeza, riesgos y plan hasta el 30/10.
    - docs/Fotos: fotos de la Pi 5, la Camera Module 3 NoIR y la ESP32-C3
    (antes en docs/esp32 c3 mini 1).
    - CLAUDE.md: cámara estándar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
    [caja_base.step, caja_base.stl, caja_cabeza.step, caja_cabeza.stl, cuna_esp32.step, cuna_esp32.stl, horquilla_cabeza.step, horquilla_cabeza.stl]
2026-10-14 Corrección de los 4 fallos de la revisión de Codex y diagrama del sistema en la v3
    - Mirada y foco: se centran en el centro óptico (cx, cy) de config.yaml, no en
    (320, 240). World.from_cfg / World.K; la cámara sintética usa los mismos intrínsecos.
    - Percepción: una cola de tamaño 2 por proceso con _put_latest (descarta lo viejo,
    nunca bloquea). Antes, una cola de 64 con put() bloqueante acumulaba hasta ~2,4 s.
    - Saludo: nod_period_s 1,0 s (≈ 237 °/s², dentro de amax de pitch); con 0,5 s pedía
    ~947 °/s². Escenario simulado y test de seguimiento ajustados al saludo de 3 s.
    - Robot.stop(): enclava el árbitro antes de transmitir y reintenta el STOP en cada
    tick si el enla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
2026-10-14 Modelo v3 sin rodamiento, con el brazo doble en los servos, relaciones de posición para SolidWorks y lista de componentes
    - Sin rodamiento de yaw (no se consigue): tapa propia de la v3 sin el aro ni los agujeros, y el plato
    apoyado solo en el brazo del RDS3218 (≈ 330 g, ≈ 1,3 kgf·cm de vuelco, calculado con --verificar).
    - Los tres servos llevan el brazo doble de plástico de 38 mm (docs/Fotos/brazo_servo.jpeg). Plato,
    horquilla y placa de roll tienen una ranura M2 a cada lado del eje en lugar de agujeros fijos, porque
    el paso de los agujeros no está medido. La horquilla pasa a la v3.
    - Macro de SolidWorks (solidworks/keepon_v3_relaciones.bas y _PEGAR.txt) con 90 relaciones de p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
    [bateria_lipo_3s.step, buzzer.step, caja_base.step, caja_cabeza.step, camara_conector.step, camara_lente.step, camara_pcb.step, cinta_ffc.step]
2026-10-14 La cámara pasa a ser la nariz, en el centro de la cara
    - La lente va en el plano de simetría (y = 0), a 38 mm sobre el eje de roll, con los dos ojos
    (decorativos, Ø20) 15 mm más arriba. Piezas nuevas: nariz_camara (tapón con el agujero de la
    lente), ojo_izq y ojo_der, en lugar de ojo_camara y ojo_otro.
    - La cinta sale de la Pi corrida 19 mm del centro: un doblez en Z (dos pliegues a 45°) en el tramo
    que sube por delante de la Pi la lleva al centro. Gasta 19 mm de cinta, por eso la nariz queda más
    arriba que el centro exacto de la cara (sigue usando 147 de 150 mm).
    - La cabeza baja a 75 × 104 × 40 mm. Sin interferencias en las 15 poses.
    - Regenerados los STEP, STL, vistas, ma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
    [bateria_lipo_3s.step, buzzer.step, caja_base.step, caja_cabeza.step, caja_cabeza.stl, camara_conector.step, camara_lente.step, camara_pcb.step]
2026-10-14 Modelo v4: cabeza de la v3 sobre el cuello compacto de la v1, con las baterías en la base
    - Cabeza, servos, soportes de pitch, horquilla y brazos de la v3, sin cambios (el script importa la
    v3). Disposición de la v1: el eje de pitch sobre el de yaw y una base en U de 64 × 116 mm en lugar
    del plato Ø146. El vuelco sobre el eje del yaw (sin rodamiento) baja de 1,26 a 0,81 kgf·cm.
    - Caja base de 182 × 133 × 74 mm con la LiPo Zeee 3S 8000 mAh (servos, por el regulador de 6 V) y el
    powerbank Xiaomi PB2020MI (Pi 5 por el GPIO, 5 V / 3 A), más una bahía adelante con el regulador,
    la ESP32 (porta_esp32), la bornera USB-C y el buzzer. El servo de yaw cuelga de la tapa.
    - Paso de cabl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
    [bateria_zeee_3s_8000.step, buzzer.step, caja_base.step, caja_base.stl, caja_cabeza.step, caja_cabeza.stl, camara_conector.step, camara_lente.step]
2026-10-14 Alimentación con fuente de laboratorio para los servos y powerbank para la Pi
    - Modelo v4: salen la LiPo Zeee y el regulador de 6 V; entran dos bornes banana
    en la pared de atrás, la bornera de 6 V con el capacitor y el interruptor solo
    sobre el +6 V. Sin interferencias en las 17 poses.
    - README y componentes_v4.txt de la v4 con el esquema nuevo, la secuencia de
    encendido y la placa USB-C con 5,1 kΩ en CC1/CC2 para el powerbank.
    - Diagrama del sistema pasado a la v4 (ESP32 en la base) con la alimentación nueva.
    - CLAUDE.md: decisión del 14/10.
    [bornera_6v.step, bornes_fuente_6v.step, buzzer.step, caja_base.step, caja_base.stl, caja_cabeza.step, camara_conector.step, camara_lente.step]
2026-10-14 La Pi toma los 5 V de la salida USB-A del powerbank: sin placa USB-C con 5,1 kΩ
    - El USB-A entrega 5 V sin negociar: un cable USB-A cortado a 2 hilos llega a
    una bornera de 5 V en la base (reemplaza a usb_c_bornera en el modelo v4).
    - Si en la cabeza el USB-C de la Pi queda libre (PI_CSI_SALIDA), usar un cable
    USB-C acodado directo: en el banco el powerbank alimenta bien a la Pi así.
    - README y componentes de la v4, diagrama del sistema y CLAUDE.md.
    [bornera_5v.step, bornera_6v.step, bornes_fuente_6v.step, buzzer.step, caja_base.step, caja_cabeza.step, camara_conector.step, camara_lente.step]
2026-10-15 Simulador de sonidos del buzzer y marcador de la polca de Cerro
    - pruebas_buzzer/simulador_sonidos.html: tablas de segmentos {f_inicio, f_fin, ms}
    editables, reproducción con onda cuadrada como la ESP32 y exportación a C y a
    config.yaml. Las duraciones de las 10 tablas coinciden con config.yaml.
    - POLCA (Club Olimpia) y POLCA_CERRO (Club Cerro Porteño) son marcadores hasta
    transcribir las melodías reales. POLCA_CERRO es un extra: la reacción a Cerro
    sigue siendo el ABUCHEO (Tabla 1 del enunciado).
    - README con el formato, el pendiente y el buzzer recomendado.
    [config.yaml]
2026-10-15 Polca del Club Olimpia transcrita de la partitura
    - Compases 1 a 8 (el motivo que vuelve en 9–16 y 66–74), 6/8, negra con
    puntillo = 135, Fa mayor, una octava más arriba que la partitura para que
    caiga donde el buzzer suena fuerte (659–1397 Hz). Dura 7,104 s.
    - config.yaml: POLCA pasa de 6,0 a 7,104 s.
    - Se agrega la partitura (notas polca de olimpia/) y se actualiza el README.
    POLCA_CERRO sigue siendo un marcador.
    [config.yaml]
2026-10-15 Circuito del buzzer en el diagrama del sistema y en el README
    - Esquema: buzzer pasivo 5 V en el colector del 2N2222, 1 kΩ del GPIO10 a la
    base, 10 kΩ base-GND y 1N4148 en paralelo con el buzzer (raya hacia +5 V).
    - Tabla de componentes con el buzzer pasivo de electronica.com.py y avisos:
    prueba de pasivo/activo, orden de patas del 2N2222 y polaridad del diodo.
2026-10-15 Se borra una captura vieja de docs/fuente
2026-10-15 config.yaml: el puerto serie es el CH340 de la ESP32-C3 (by-id), no el ttyACM0 de la S3
2026-10-15 Firmware del robot para la ESP32-C3, probado contra el simulador y en la placa real
    - firmware/keepon_fw: nucleo.cpp (protocolo, trayectoria a 100 Hz, STOP enclavado,
    watchdog, sonidos y grados → µs, en C++ portable) y keepon_fw.ino (serie, LEDC de
    los servos y buzzer en timers separados). generado.h sale de config.yaml y del
    simulador de sonidos (scripts/generar_firmware.py).
    - tests/test_firmware_nucleo.py: el núcleo compilado con g++ da las mismas respuestas
    y posiciones que SimESP32 paso a paso (34 tests, con comandos al azar).
    - scripts/cargar_firmware.sh (compila en la notebook y carga desde la Pi con esptool)
    y scripts/prueba_firmware_real.py: 30 de 30 OK en la ESP32 rea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
    [partitions.csv]
2026-10-15 Se saca del repo la carpeta build/ del firmware (la genera arduino-cli)
    [partitions.csv]
2026-10-15 AGENTS.md al día para Codex: MG996R, firmware hecho, alimentación y lo que falta
2026-10-15 Carpetas de los micro servos sin espacio final, para Git for Windows
    Windows no admite nombres que terminan en espacio: Git for Windows no podía
    restaurar docs/micro servo mg90s / ni docs/micro servo sg90 /. Se renombran sin
    el espacio final; los archivos y su contenido no cambian. No había otras rutas
    incompatibles (caracteres prohibidos, nombres reservados, choques de mayúsculas).
2026-10-15 Carpetas de los micro servos con guion bajo: docs/micro_servo_mg90s y docs/micro_servo_sg90
2026-10-15 Carpeta del servo HS-7955TG con guion bajo: docs/servo_HS-7955TG_titanium_gear
2026-10-15 Carpetas sin espacios en todo el repo (guion bajo) y referencias actualizadas
    docs/Fotos: Bateria_powerbank_xiaomi, bateria_zee, brazo_servo, camera_Noir_module_3,
    esp32_c3_mini_1, raspberry_pi; pruebas_buzzer/notas_polca_de_olimpia. Renombres al
    100 %, sin cambios de contenido. Se actualizan las rutas que las mencionaban (CLAUDE.md,
    los scripts y el README de los modelos v3/v4, el README y el simulador del buzzer).
    [keepon_v4_cad.py]
2026-10-15 Archivos sin espacios en el nombre (guion bajo)
    13 capturas, PDF, la ficha del powerbank, una imagen y un audio de docs/: cada
    espacio pasa a guion bajo y el resto del nombre queda igual. Renombres al 100 %,
    ningún archivo los mencionaba. Ya no queda ninguna ruta con espacios en el repo.
2026-10-15 CLAUDE.md y AGENTS.md: nombres sin espacios, PR #1 y limpieza de la Pi tras renombrar
2026-10-15 Imágenes de referencia para el detector de camisetas (Olimpia, Cerro, suplentes y trampas)
    Fotos de la camiseta sola, sin personas, con el origen y la licencia en cada
    fuentes.txt. Sirven para probar la lógica del patrón, no los umbrales de color
    (son de cámara normal). Mostraron que la titular 2026 de Cerro es mitad y mitad,
    que su azul es marino oscuro y que el Barcelona es casi igual a Cerro.
2026-10-15 CLAUDE.md y AGENTS.md: plan del detector de camisetas, imágenes de referencia y lo que mostraron
2026-10-15 Hook de Claude Code: tests de conformidad al editar el núcleo
    Cuando Claude edita sim_esp32.py, trajectory.py, protocol.py, nucleo.cpp,
    nucleo.h o config.yaml, corre tests/test_firmware_nucleo.py (~5 s). Si
    fallan, le devuelve la salida para que arregle la diferencia entre el
    firmware y el simulador antes de seguir. Sin el .venv del proyecto no hace
    nada. Necesita jq.
2026-10-15 CLAUDE.md: el powerbank PB2020MI se comparte con el recolector
2026-10-22 Adelgazar CLAUDE.md: estado, decisiones y pendientes a docs/
    CLAUDE.md pasa de 29046 a 6108 bytes y queda con Proyecto, Reglas,
    Comandos, Qué leer para cada cosa y Estructura. Nada se borró; se movió:
    - Sesiones (07/10, 13/10, 14/10, 14-15/10) y rendimiento medido -> docs/ESTADO.md
    - Decisiones tomadas (y las repartidas en hardware/sesiones) -> docs/DECISIONES.md
    - Próximos pasos y pendientes sueltos -> docs/PENDIENTES.md
    - Hardware real (cámara, ESP32, servos, alimentación) -> docs/HARDWARE.md
    - Acceso a la Pi, comandos de la Pi y visores -> docs/PI.md
    - Tabla de módulos de keepon/ -> docs/ARQUITECTURA.md
    - Reglas y comandos del firmware -> firmware/CLAUDE.md
    - Reglas y comandos del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
2026-10-22 AGENTS.md como symlink a CLAUDE.md (raíz, firmware/, pruebas_servos/)
    El AGENTS.md propio era un resumen de CLAUDE.md al 15/10. Lo que tenía
    de exclusivo ya está en el repo: circuito del buzzer en
    pruebas_buzzer/README.md, compra pendiente en docs/PENDIENTES.md, tabla
    de servos y GPIO en docs/HARDWARE.md, modos de personalidad en
    docs/ARQUITECTURA.md y en la consigna.
2026-10-22 Comando /pi-sync: rsync a la Pi y anotar el commit en ~/keepon/.commit
    El rsync es el de docs/PI.md, sin --delete. Si hay cambios sin commitear,
    el hash se anota con el sufijo -sucio. /verificar (comando global) compara
    ese hash con HEAD.
2026-10-22 Renombrar el comando /pi-sync a /pi-sync-robot
    Se actualiza la referencia en docs/PI.md (y en /verificar, que es global y
    no está en el repo).
2026-10-22 Renombrar /pi-sync-robot a /pi-sync-keepon y anotarlo en CLAUDE.md
    Regla nueva: antes de un sync, /verificar; la Pi se sincroniza con
    /pi-sync-keepon. /verificar (global, fuera del repo) ahora busca
    cualquier .claude/commands/pi-sync*.md.
2026-10-22 /pi-sync-keepon: comillas en el cat remoto de la comprobación
    Sin comillas, la shell de la notebook expandía ~ a /home/hecvelaz antes
    de mandarlo por SSH y la comprobación fallaba aunque .commit existiera.
2026-10-26 Diagrama de conexionado con fotos de los servos, la ESP32, la Pi, la cámara y el powerbank
    - Fotos de los tres servos que se montan en docs/Fotos/servo_*.
    - Sección nueva en docs/diagrama_sistema/index.html: servos numerados en el
    orden del protocolo (1 yaw RDS3218 GPIO0, 2 pitch HS-7955TG GPIO1,
    3 roll MG996R GPIO4), pines usados marcados sobre la foto de la ESP32,
    buzzer en GPIO10, fuente regulada a 6 V para los servos y powerbank a 5 V
    para la Pi, con GND común.
    - Copias reducidas de las fotos en docs/diagrama_sistema/fotos/.
2026-10-26 Módulo de buzzer pasivo MH-FMD en lugar del circuito con 2N2222
    - El módulo trae el transistor (PNP) y la resistencia de base: salen el
    2N2222, el 1 kΩ, el 10 kΩ y el 1N4148.
    - VCC del módulo a 3V3 (con 5 V el ALTO de 3,3 V del GPIO no apaga el PNP).
    - Firmware: el módulo se activa por nivel bajo, así que la salida del
    GPIO10 va invertida (ledcOutputInvert) y callado deja el pin en ALTO,
    sin corriente en la bobina. Compila; falta cargarlo y probarlo.
    - Diagrama del sistema: foto del módulo, cables a GND, GPIO10 y 3V3, y la
    sección "Módulo del buzzer" en lugar de "Circuito del buzzer".
    - Actualizados pruebas_buzzer/README.md, HARDWARE, PENDIENTES y la lista
    de componentes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
    [keepon_fw.ino, keepon_v4_cad.py]
2026-10-26 Sacar el capacitor de 2200 µF + 100 nF del bus de 6 V
    - En el banco, con la fuente de laboratorio, los tres servos anduvieron
    bien sin él. Si en el robot armado tiemblan en los giros rápidos, es lo
    primero que hay que volver a poner (anotado en HARDWARE).
    - Diagrama del sistema: fuera de la bornera, del diagrama de bloques y de
    "Lo que falta".
    - v4: fuera de la lista de componentes y del README. El modelo 3D todavía
    dibuja el cilindro (falta regenerar los STEP).
2026-10-26 Diagrama con fotos: la ESP32 vista desde arriba
    - Placa dibujada del lado del chip (módulo ESP32-C3-MINI-1) y del
    micro-USB, con el nombre de cada pin al lado: la foto de la cara de
    abajo confundía porque los pines quedaban espejados.
    - Cables reubicados según la vista de arriba (USB entra por la derecha;
    saltos donde se cruzan GPIO10, GND y USB con otras señales).
    - Se borra la copia de la foto de abajo (fotos/esp32_c3.jpg).
2026-10-26 Volumen del buzzer configurable y prueba de banco del módulo
    - config.yaml: buzzer.volumen (fracción del ciclo de trabajo máximo,
    1.0 = 50 %). Queda en 0.25: la POLCA se escucha bien.
    - generar_firmware.py lo pasa a generado.h (BUZZER_VOLUMEN) y el firmware
    aplica ese ciclo de trabajo después de cada nota.
    - pruebas_buzzer/prueba_buzzer: alterna un tono con digitalWrite (solo
    hardware) y el mismo tono por LEDC invertido (el camino del firmware).
    Con él se encontró un falso contacto en el pin 10.
    - Probado el 26/10 en la ESP32 conectada a la notebook: firmware cargado,
    POLCA completa (DONE a los 7,1 s).
    [partitions.csv]
2026-10-26 No versionar la carpeta build/ de pruebas_buzzer
    Se había subido por error en el commit anterior (binarios de
    arduino-cli). Queda en .gitignore, como las de firmware/ y pruebas_servos/.
    [partitions.csv]
2026-11-03 Diseño v6 R4 como modelo mecánico vigente
    - Se versiona docs/diseno_v6/ solo con las fuentes, la documentación y la
    revisión R4 (SLDPRT/SLDASM, STEP, vistas): unos 20 MB de 228 MB. Los ZIP,
    el historial, las evidencias y las revisiones anteriores quedan en el
    .gitignore.
    - docs/diseno_v6/LEEME_GIT.md: qué servo mueve cada eje en el v6, qué está
    en git y qué falta para regenerar el CAD (docs/diseno_v5 no está).
    - CLAUDE.md, DECISIONES, HARDWARE, ESTADO y PENDIENTES pasan de la v4 a la
    v6 R4. La asignación de servos y los límites no cambian.
    [00_ensamble_V6_R4.step, 01_base_con_pilares.SLDPRT, 01_base_con_pilares.step, 02_horquilla_de_giro.SLDPRT, 02_horquilla_de_giro.step, 03_cuna_de_inclinacion.SLDPRT, 03_cuna_de_inclinacion.step, 04_carcasa_inferior_cabeza.SLDPRT]
2026-11-03 Calibración de los servos con la cabeza v6 montada y compensación de zona muerta del roll
    - neck.servos: ceros yaw 1500 / pitch 1400 / roll 1450 µs y signos −1 / +1 / −1,
    medidos con la cabeza armada (convención de PROTOCOLO.md). Se reubicaron en el
    estriado el horn del yaw y el disco del roll.
    - Límites del roll: ±20° (a +25 queda al límite de la pared, a +30 toca).
    - Firmware: compensación de zona muerta por eje (compensacion_us, [al bajar, al
    subir el pulso]) según el sentido del último movimiento. El roll usa [0, 151]:
    el MG996R se frenaba ~10° antes con el pulso subiendo (de +25 a 0 quedaba en
    +10). Test de regresión test_regresion_zona_muerta_roll.
    - scripts/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
2026-11-03 SerialLink con espejo y escenario sintético contra la ESP32 real (--serial)
    - SerialLink(espejo_cfg=...) lleva un SimESP32 que recibe los mismos comandos
    y avanza en tiempo real: da la posición del cuello a 100 Hz sin esperar los
    STATE. Cada STATE real se compara con el espejo (max_desvio); si se separa
    más de 1° (p. ej. al arrancar fuera de HOME) adopta la posición real. Si el
    ESP32 se reinicia (HELLO 0), el espejo también.
    - scripts/sim_scenario.py --serial: el escenario de 30 s en tiempo real con
    los servos de verdad y personas sintéticas. Ctrl+C manda STOP; al terminar,
    HOME e informe del desvío del espejo.
    - tests/test_serial_espejo.py: espejo contra un ESP32 simulad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
2026-11-04 Cámara de la cabeza v6: conector i2c@88000 y rotación de 180°
    - config.yaml: camera.ros_camera (ahora en i2c@88000) y orientation_deg: 180,
    que aplica camera_ros al leer el sensor (sin costo de CPU). Intrínsecos
    rotados: cx → 639 − cx, cy → 479 − cy y tangenciales con el signo cambiado
    (siguen sin calibrar para esta cámara).
    - scripts/ver_percepcion.sh y ver_personas.sh leen la cámara y la orientación
    de config.yaml (CAMARA=... sigue sirviendo para cambiarla).
    - sim_scenario.py fija la geometría de la cámara sintética con la que se
    diseñaron los tiempos del escenario: no depende de la calibración real.
2026-11-04 Robot con cámara y servos de verdad: scripts/robot_vivo.py
    - robot_vivo.py: Perception (proceso de personas) → World → Robot → SerialLink
    (con espejo) → ESP32, al ritmo de control.rate_hz. Person.u/v = nariz si hay
    rostro; si no, la altura de la cabeza en la caja. Edad del mundo desde el
    stamp del cuadro. Cada 10 s registra Hz del lazo, edad de la percepción,
    personas y desvío del espejo. Ctrl+C manda STOP. Todavía sin pose ni camisetas.
    - robot_vivo.sh: arranca camera_node (cámara y orientación de config.yaml) y el
    servidor web para mirar la cámara, y el robot en primer plano. El filtro de
    ruido ignora Ctrl+C para que el STOP siempre pueda salir.
    - tests/test_robo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
2026-11-04 robot_vivo: RESUME al arrancar (el STOP de un Ctrl+C anterior queda enclavado en la ESP32)
2026-11-04 Eventos ME_MIRA sostenido y SALUDO con filtro temporal (keepon/eventos.py)
    - ME_MIRA: se activa tras mirar mira_sostenida_s (0,5 s) seguidos y se suelta
    tras mira_suelta_s (0,3 s) sin mirar: un cuadro suelto no lo cambia.
    - SALUDO: la pose se asocia a la persona cuya caja contiene sus hombros; por
    mano levantada sobre el hombro se cuentan vaivenes laterales de la muñeca
    (amplitud en anchos de hombros). saludo_ciclos dentro de saludo_ventana_s →
    Person.wave_count += 1. Hasta que la mano baje no cuenta otro (un gesto, un
    evento). Cada pose se procesa una sola vez aunque el lazo vaya a 40 Hz.
    - Parámetros en config.yaml (eventos:). Cada evento va al log con marca de tiempo.
    - robo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
2026-11-04 Overlay de monitoreo T7 en el robot (keepon/overlay.py)
    - overlay.dibujar: personas con ID, objetivo (caja gruesa y error del control
    desde el centro óptico), ME_MIRA filtrado, SALUDO reciente, camiseta, pose,
    modo, STOP, dueño del cuello y del buzzer, ángulos comandados, y salud
    (Hz del lazo y de la percepción, edad del cuadro en rojo si pasa de 300 ms).
    - robot_vivo.py: Monitor publica el overlay en /keepon/overlay a ~10 Hz con su
    propia suscripción a la cámara (--sin-overlay lo apaga); tasas por segundo.
    - Eventos.saludo_reciente para mostrar el SALUDO durante 2 s.
    - tests/test_overlay.py.
    [eventos.py, overlay.py, robot_vivo.py]
2026-11-04 Inclinación de curiosidad (T3 d) en el seguimiento
    - Tracking: si el objetivo queda centrado (error filtrado del control dentro de
    error_max_deg) durante quieto_s, inclina el roll ±amp_deg (alterna el lado),
    lo sostiene sostener_s y vuelve a 0; si la persona se mueve, vuelve enseguida.
    Después espera espera_s. Yaw y pitch siguen a la persona (mismo dueño del cuello).
    - on_cancel: si otro comportamiento o el STOP toma el cuello estando inclinada,
    queda en el log y arranca la espera.
    - config.yaml: sección curiosidad (activa, 3 s, 4°, 15°, 2 s, 8 s).
    - tests/test_curiosidad.py: 5 casos.
    [behaviors.py, config.yaml]
2026-11-04 Curiosidad: "quieto" por la dirección de la persona, no por el error del control
    En el robot real nunca se inclinaba: el seguimiento oscila un poco y el error
    del control salía de ±4° todo el tiempo, reiniciando la cuenta. Ahora "quieto"
    es que la dirección de la persona (ángulo comandado del cuello + error en la
    imagen) no se aparte más de movimiento_max_deg (5°) de donde estaba al empezar
    a contar. Test de regresión con la cabeza oscilando ±6° alrededor de una
    persona quieta.
    Además:
    - SerialLink.max_desvio ya no cuenta los STATE que fuerzan resincronización
    (al arrancar fuera de HOME daba 66°); se informan aparte (resyncs).
    - robot_vivo: el ESTADO informa el tick más lar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
    [behaviors.py, config.yaml, link.py, robot_vivo.py]
2026-11-04 Modos de personalidad (T5) y evento SALIENDO
    - Robot.modo / set_modo: cambio en tiempo de ejecución, al log, confirmado con
    BEEP_<MODO> por el comportamiento OPERADOR (prioridad 0, sólo buzzer: no le
    quita el cuello al seguimiento).
    - Mode (prioridad 3) reacciona sobre la persona seguida:
    TIMIDO: si lo mira, desvía la mirada (costado con más lugar, abajo y algo de
    roll), la sostiene y vuelve a espiar con una curva suave.
    ATREVIDO: si lo mira, levanta el mentón 3 veces siguiéndola en yaw.
    MALEDUCADO: PIROPO al empezar cada salida (SALIENDO), cooldown global 40 s.
    NEUTRO: sólo el contacto visual.
    - Eventos: SALIENDO = cerca del borde y alejándose, o el cuello en su límit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
    [behaviors.py, config.yaml, eventos.py, robot.py, robot_vivo.py]
2026-11-04 robot_vivo: comando 'sonido NOMBRE' para probar el buzzer a pedido (OPERADOR, sólo buzzer)
    [behaviors.py, robot.py, robot_vivo.py]
2026-11-04 Buzzer al GPIO5 y pin configurable (buzzer.pin)
    Con la cabeza v6 armada el buzzer no sonaba en el GPIO10 aunque el firmware
    confirmaba DONE: el I/O del módulo pasa al GPIO5 (libre, sin función de
    arranque). El pin sale de config.yaml (buzzer.pin) a generado.h, así que el
    próximo cambio no toca el .ino. CLAUDE.md, HARDWARE, PENDIENTES y firmware/ al día.
    [config.yaml, generado.h, generar_firmware.py, keepon_fw.ino]
2026-11-04 Volumen del buzzer a 0.12 (a pedido, la mitad que antes)
    [config.yaml, generado.h]
2026-11-04 Firmware: watchdog y fin de sonido falsos por restar tiempos sin signo
    En la ESP32 las líneas se reciben con millis() y el paso del lazo usa su
    instante programado, que puede estar unos ms atrás. paso(40) con la última
    línea en 45 calculaba 40 − 45 sin signo (≈ 4·10⁹ ms) → ERR WATCHDOG aunque la
    Pi mandaba J a 40 Hz (visto el 03/11 con el robot real), y el mismo error podía
    dar un sonido por terminado apenas empezaba. Ahora las diferencias son con
    signo (dif_ms), lo que además aguanta la vuelta de millis() a los 49 días.
    El arnés tiene la orden M <ms> <línea> para recibir una línea en un instante
    exacto; test de regresión test_regresion_linea_recibida_despues_del_paso_pr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
    [nucleo.cpp]
2026-11-04 Arranque para la demo: servicio de usuario y comandos por SSH
    - robot_vivo.py: comandos también por el FIFO ~/keepon/run/comandos (corriendo
    como servicio no hay terminal); se registran en el log (COMANDO). Con SIGTERM
    (systemctl stop) termina el lazo y vuelve a HOME en vez de quedar congelado.
    - scripts/keepon (Pi): arrancar, parar, estado, log, modos y comandos, instalar,
    demo-on/demo-off (arranque al encender, desactivado por defecto porque la Pi
    se usa en otros proyectos).
    - scripts/keepon.service: systemd de usuario, reintenta si la ESP32 o la cámara
    no están.
    - scripts/k (notebook): lo mismo por SSH.
    - docs/PI.md: sección de la demo. Test del FIFO sin bloqueo.
    Co-Authore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
2026-11-04 Centro óptico provisorio en el centro de la imagen
    El control lleva la nariz al centro óptico (cx, cy). Se usaba el de una
    calibración de otra cámara, rotado 180° (210.5, 253.6): el robot centraba la
    nariz ~110 px a la izquierda (≈ 6,5°) y parecía no mirar a los ojos. Hasta
    calibrar esta cámara con un tablero, cx/cy = centro de la imagen y distorsión
    en cero; fx/fy siguen de la calibración anterior.
2026-11-04 Servicio keepon: parar no es una falla (SuccessExitStatus 130/143) y el filtro ignora SIGTERM
2026-11-04 Panel del celular (PWA) para comandar a Keepon
    - scripts/panel_web.py: servidor HTTP de la biblioteca estándar (puerto 8081)
    que sirve scripts/panel/ y dos rutas: GET /estado y POST /comando. Sólo
    acepta una lista cerrada (n/t/a/m, stop/resume/home, sonido X de config.yaml)
    y la escribe en el FIFO del robot; no sirve archivos fuera de scripts/panel/.
    - scripts/panel/: página para el celular (STOP fijo arriba, modos con el actual
    resaltado, Home/Resume, sonidos, estado en vivo, enlace al overlay),
    manifiesto e ícono para instalarla como app ("Agregar a pantalla de inicio").
    - robot_vivo.py publica el estado en ~/keepon/run/estado.json cada 0,5 s;
    robot_vivo.sh arranca el panel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
2026-11-04 Cierre del 03/11: bitácora, estado, pendientes y decisiones
    - docs/BITACORA.md (nuevo): la sesión del 03/11 y la historia de sesiones
    anteriores que estaba en ESTADO.md, sin cambios.
    - docs/ESTADO.md: foto del estado actual (v6 armado y calibrado, robot real con
    cámara, modos, overlay, servicio de demo, panel del celular; buzzer que se
    corta con los servos en movimiento).
    - docs/PENDIENTES.md: reordenado por prioridad (demo, guía, entregables, otros).
    - docs/DECISIONES.md: centro óptico provisorio, buzzer en GPIO5, fragmento de
    la polca, servicio no activado al encender, PWA, definición de "quieto".
2026-11-04 Panel del celular siempre prendido: encender y apagar a Keepon desde el teléfono
    - panel_web.py: comandos "arrancar" y "parar" en la lista cerrada (systemctl --user
    start/stop keepon, sin shell, con --no-block); /estado informa el estado del servicio.
    - keepon-panel.service: el panel como servicio de usuario propio (puerto 8081), que no
    toma la cámara ni la ESP32. 'keepon panel-on | panel-off'.
    - robot_vivo.sh: lanza el panel sólo si el servicio keepon-panel no está corriendo, y su
    'stop' no mata al panel del servicio.
    - index.html: botones Encender / Apagar (con confirmación) y estado arrancando/apagando.
    - PI.md: linger (activado el 04/11) y el panel como servicio.
    - 3 tests nue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
2026-11-04 Sonidos del operador: el último pedido gana
    Un sonido pedido mientras sonaba otro del operador se descartaba sin aviso: el árbitro lo tomaba
    como una renovación del mismo comportamiento y el pedido vencía al segundo. Ahora ConfirmaModo
    corta el que suena y en el ciclo siguiente arranca el nuevo (vale también para el beep de cambio
    de modo). Si un pedido se descarta igual (p. ej. con STOP), queda en el log.
    Tests de regresión en tests/test_modos.py.
2026-11-04 Buzzer al GPIO7
    En el GPIO5 el buzzer dejó de sonar con el robot andando, aunque el firmware tocaba cada sonido
    (DONE a tiempo). config.yaml buzzer.pin: 5 -> 7, generado.h regenerado y docs al día.
    [config.yaml, generado.h, keepon_fw.ino]
2026-11-04 Apagar: RESUME antes del HOME y esperar a que la cabeza llegue
    Con el STOP enclavado, al apagar la ESP32 rechazaba el HOME (ERR STOP_ACTIVE) y la cabeza quedaba
    donde estaba. Además el programa salía apenas mandaba HOME: el watchdog de 500 ms podía cortar la
    vuelta. ir_a_home_y_esperar() manda RESUME + HOME y sigue con PING/STATE hasta llegar (máx. 5 s).
    Test de regresión en tests/test_robot_vivo.py.
2026-11-04 Buzzer de vuelta al GPIO5 (revierte c1759c2)
    En el GPIO7 tampoco sonaba: el pin no era el problema.
    [config.yaml, generado.h, keepon_fw.ino]
2026-11-04 Volumen del buzzer desde el panel del celular
    - Protocolo: comando VOL seq PCT (0..100, se recorta con ACK CLIPPED; vale con STOP y en el sonido
    que está sonando; al reiniciarse la ESP32 vuelve a buzzer.volumen). fw 2.
    - sim_esp32 (especificación) y nucleo.cpp (copia) con VOL; el .ino ajusta el ciclo de trabajo
    también cuando cambia el volumen con la nota sonando. Arnés: orden V.
    - Robot: set_volumen() y comando "volumen N"; se manda en cada sesión nueva (y tras un reinicio
    de la ESP32). robot_vivo guarda el último en ~/keepon/run/volumen y lo publica en estado.json.
    - Panel: "volumen N" en la lista cerrada y barra de volumen en la app.
    - Tests de conformidad (firmware = simulado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
    [keepon_fw.ino, nucleo.cpp, nucleo.h, panel_web.py, protocol.py, robot.py, robot_vivo.py]
2026-11-04 Ángulo de mirada en el overlay y en el log, para validar looking_deg
    El modo tímido casi no reaccionaba: ME_MIRA aparecía 0 a 7 veces por corrida. El umbral
    perception.looking_deg (15°) nunca se validó (PENDIENTES 3). El overlay muestra ahora el ángulo
    cara→cámara de cada cara y la línea ESTADO resume el de la persona seguida (mínimo, mediana y
    cuántos quedaron bajo el umbral).
2026-11-04 Detector de camisetas Olimpia / Cerro con reglas de color y patrón
    - keepon/camiseta.py: torso desde los hombros de Pose; CERRO = columnas rojas y azules con un
    borde vertical; OLIMPIA = claro → franja oscura → claro, con blanco poco saturado. Filtro de
    6 cuadros para confirmar y 6 para soltar (T6 d).
    - Corre en el proceso de pose; Eventos lo filtra por persona y llena World.shirt (el
    comportamiento CAMISETA ya existía). Overlay: torso evaluado y clase cruda.
    - Umbrales en config.yaml, medidos con la NoIR sobre las camisetas reales.
    - pruebas_camisetas/grabar.sh y evaluar.py; resultados en el README: 0 % de falsos positivos
    con remeras lisas roja y azul marino, Cerro 98 %, Olim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
2026-11-04 Mirada 8° más abajo de la cara para que entre la camiseta
    Con la cara centrada, la cámara (±14° en vertical) no veía la camiseta de cerca. gaze.mirar_abajo_deg
    deja la cara ese ángulo por encima del centro óptico. El overlay marca ese punto. Test nuevo; los tests
    de curiosidad y modos siguen con la cara centrada (corrimiento 0).
2026-11-06 MG996R nuevos en pitch y roll, mirada por objetivo y Observador por miradas
    - Calibración de los dos MG996R nuevos: pitch centro 1500, signo −1, 1100/1800 µs;
    roll centro 1500, sin compensación de zona muerta.
    - Los servos vibran moviéndose lento: la mirada salta adonde está la persona (posición
    del cuello al sacar la foto + error) y queda quieta; el Observador va de punto en
    punto. vmax 180/120/120 °/s, amax 600/400/300 °/s². Modos viejos como respaldo.
    - kp y ema por eje; el simulador pasa la edad real de la imagen.
    - pruebas_servos/mover_servos.py para mover los servos en grados desde la Pi.
    - video/ en el .gitignore.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
    [behaviors.py, config.yaml, gaze.py, generado.h, mover_servos.py, robot.py, sim_scenario.py]
2026-11-07 README al día y checklist de la consigna (Markdown e interactivo)
    - README reescrito para quien llega de afuera: hardware real (ESP32-C3, MG996R),
    arquitectura, modelos con su fuente, instalación, ejecución, modos y STOP.
    - docs/CHECKLIST_TP.md: cada casilla de la consigna revisada contra el código.
    - docs/checklist_robotica_social.html: columna de Hector precargada con lo hecho
    y probado; enlaces a main; las marcas guardadas de Mathias se conservan.
2026-11-07 Informe técnico en cuaderno Colab (.ipynb) con diagramas, parámetros y resultados
    Celdas de texto con las secciones de la consigna (6.1) y diagramas incrustados; celdas de código ya
    ejecutadas que leen config.yaml, grafican los benchmarks, simulan la trayectoria y corren el escenario
    de 30 s. Quedan marcados los lugares a completar por el grupo (integrantes, aportes, video, latencia).
2026-11-07 Informe técnico: plantilla del grupo completada con el contenido del proyecto
    Informe_técnico.ipynb sigue la estructura de la plantilla (17 secciones) con los datos reales, los diagramas
    incrustados y las celdas de código ejecutadas. Reemplaza a Informe_Keepon_pro.ipynb. Quedan marcados
    los campos que completa el grupo (video, ZIP, fotos, contribuciones, latencia medida).
2026-11-07 Informe: figura con las camisetas de referencia (Olimpia, Cerro y prendas trampa)
2026-11-08 Diagrama del sistema: buzzer en el GPIO5 y MG996R nuevos en pitch y roll
    - Conexionado: el I/O del buzzer sale del GPIO5 (fila de arriba); pitch y roll con la foto de los MG996R
    nuevos (docs/Fotos/MG_996r_nuevo, recortada en diagrama_sistema/fotos/mg996r_nuevo.jpg) y sus datos.
    - Tablas, notas y diagrama de bloques sin el HS-7955TG; cámara en i2c@88000; modelo v6 R4.
    - pruebas_buzzer: README, sketch de prueba y simulador también en el GPIO5.
    [prueba_buzzer.ino]
2026-11-08 Informe v2: diagramas editables en draw.io (docs/informe/diagramas)
    Un .drawio por cada figura propia del informe (12) y por los demás diagramas de la guía (7), con cajas,
    textos y flechas editables. Generados desde los SVG de la guía con fuente/svg_a_drawio.py. Debajo de cada
    figura de Informe_técnico_v2.ipynb se indica su archivo editable.
2026-11-08 Curva S en todos los movimientos y Observador que centra la vista
    - Trayectoria (keepon/trajectory.py y su copia firmware/keepon_fw/nucleo.cpp): la posición del servo
    es el promedio del trapecio en una ventana de neck.suavizado_s (0,1 s). Jerk de yaw de 60000-104000
    a 12000 °/s³, sin pasar vmax/amax ni sobrepasar el objetivo. Cada movimiento dura 0,1 s más.
    - Espejo de SerialLink en pasos fijos de 10 ms, como el firmware (la ventana se cuenta en pasos).
    - Observador por miradas: quieto donde quedó → centro (HOME) → miradas, con roll de ±5° (Tabla 1).
    - Tests de jerk, retargets, frenada, resincronización y secuencia del Observador.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
2026-11-08 Roll: cero en 1554 µs y signo corregido (roll + = derecha vista desde atrás)
    Medido montado el 08/11: con 1500 µs la cabeza quedaba ~5° inclinada a la izquierda y roll + la
    inclinaba a la izquierda (el signo −1 venía del MG996R anterior, sin verificar).
2026-11-08 Roll: servo reemplazado, cero en 1500 µs
    MG996R nuevo del mismo tipo. Cero medido montado llegando desde la izquierda (−15° → 0). Tiene
    banda muerta (pasos de 3-5° no lo movían); falta medirlo llegando desde la derecha.
2026-11-08 Observador: transición de mínimo jerk entre miradas; roll más rápido (prueba)
    - Observador por miradas: yaw y pitch van de un punto al otro con s = 10τ³ − 15τ⁴ + 6τ⁵ en
    observer.transicion_s (1,0 s), sin tirones al arrancar ni al frenar; después quieto el resto de
    pausa_s (2,5 s). El roll va directo con el perfil del firmware (±5°: lento, la banda muerta del
    MG996R lo haría avanzar a saltitos). transicion_s = 0 vuelve al salto del 05/11.
    - Roll (PRUEBA en el robot, falta validar): vmax 250 °/s, amax 900 °/s², curva S 0,15 s. Medido
    el 08/11: sin curva S vibraba MÁS; vibra solo girando a la derecha en la zona negativa (−20/−15/−10
    → 0 por igual), con cu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
2026-11-08 Observador: búsqueda más lenta y suave (transición 1,6 s, pausa 3 s)
    Con 1,0 s el yaw se veía rápido al buscar. 30° de yaw: pico 35 °/s (antes 56). Ojo: el RDS3218
    vibraba por debajo de ~40 °/s (05/11): verificar montado.
2026-11-08 Observador "exploracion": barridos lentos, sacadas y roll, como pide la Tabla 1
    Centra la vista (si quedó donde estaba la última persona, primero la fija), barre de −45° a +45°
    sin pararse en el medio (20 °/s de media, mínimo jerk, roll 0) y cada 2 barridos hace una sacada
    rápida (perfil del firmware) a un punto de interés, que fija 1,5 s con roll ±5°. Antes ("miradas")
    iba de punto en punto con pausas: se veía "para y gira". "miradas" y "barrido" quedan de respaldo.
    Tests: tests/test_observador_exploracion.py (no se para en el medio, barrido lento sin saltos,
    sacadas rápidas y sostenidas cada 2 barridos, roll chico y siempre por 0, centrado suave después de
    seguir a alguien)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
2026-11-08 Observador: barrido a 25 °/s de media (con 20 el yaw vibraba)
    Medido montado el 08/11: con 20 °/s de media (pico 37,5) el RDS3218 vibraba barriendo. Con 25:
    pico 47 °/s, 90° en 3,6 s.
2026-11-08 HOME del operador: lleva a 0 0 0 y se queda hasta RESUME
    Bug (08/11): el botón HOME del panel no llevaba la cabeza a 0 0 0. robot_vivo.py mandaba "HOME"
    directo a la ESP32, por fuera del árbitro: en el ciclo siguiente el Observador o el seguimiento
    mandaban su J y lo pisaban (reproducido: 3 s después, el cuello en −20/6/4,8 con el Observador de
    dueño). Con un STOP enclavado, además, la ESP32 rechazaba el HOME (STOP_ACTIVE).
    Ahora Robot.home() es un comando del operador como STOP: detiene el árbitro, manda RESUME + HOME
    y la cabeza queda en HOME hasta RESUME. Un STOP sigue mandando (frena donde esté). El panel muestra
    "En HOME · tocar para RESUME". Tests de regresión en tests/test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
    [robot.py, robot_vivo.py]
2026-11-08 Botón "Ejes" para el video, polca una vez por aparición y tests del beep del modo
    - Ejes (panel / comando "ejes"): comportamiento EJES, prioridad 0 y sólo el cuello. Recorre yaw ±30,
    pitch +20/−15 y roll ±15 (ejes.secuencia, ~15 s, mínimo jerk en yaw y pitch), vuelve a HOME y
    retoman el Observador o el seguimiento. Desde HOME se reanuda solo; con STOP enclavado, no.
    - Polca/abucheo: cooldowns.CAMISETA_por_persona: null = una vez por aparición (el tracker no reusa
    IDs: quien vuelve después de ~1 s recibe otro). Antes, cada 25 s: en 90 s con la camiseta a la
    vista sonaban 4 polcas. Si un saludo la corta, no se repite.
    - Beep del modo: ya cortaba el sonido anterior (3a9e07c, 0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
2026-11-08 Informe técnico al día con el 08/11: curva S, roll, Observador "exploracion", HOME, Ejes y polca una vez
    Las dos versiones (Informe_técnico.ipynb y _v2) con los mismos cambios de texto: rama movimiento-suave,
    curva S y jerk, signo y servo nuevo del roll (vmax/amax en prueba), Observador de la Tabla 1, HOME y Ejes
    del operador (prioridad 0), polca y abucheo una vez por aparición, 257 tests, pruebas nuevas en 11.1 y la
    escena de Ejes en el video. Celdas ejecutadas de nuevo contra 1d35bc6 (signo del roll, cooldowns,
    trayectoria con curva S: 25° en 0,49 s; el escenario de 30 s no cambió).
2026-11-08 README de presentación: portada con el CAD, entregables, funciones, arquitectura y resultados
    - Portada con el render del v6 R4 e insignias; tabla de entregables (informe v3, guía PDF, checklist,
    diagramas), qué hace el robot, cómo funciona con el diagrama de arquitectura, prioridades, escenario
    simulado y resultados medidos. Imágenes en docs/img (sacadas del CAD y del informe; sin personas).
    - Al día con el 08/11: Observador "exploracion", curva S, HOME y Ejes, polca una vez, 257 tests.
    - El informe del usuario pasa de _v2 a _v3 (mismo contenido; referencias actualizadas).
    - Ayuda de keepon y k: comando "ejes".
2026-11-08 README: nombres de los integrantes en la portada
2026-11-08 El robot se llama Wall-E: README e informe (el proyecto y el repo siguen siendo Keepon pro)
2026-11-08 README: fotos de Wall-E armado en la portada (el CAD pasa a Hardware)
2026-11-08 Informe: fotos de Wall-E armado en la sección 3.1 (reemplazan el [Completar])
2026-11-08 Portadas del video (inicio y cierre) con Wall-E dibujado desde las medidas del CAD v6 R4
    scripts/portadas_video.py genera video/portadas/portada_{inicio,final}.{svg,png} (1920x1080, fuera de git).
2026-11-08 Diagrama de componentes reales (fotos, datos y conexiones) en el informe (Figura 3b) y el README
    Powerbank, Raspberry Pi 5, cámara NoIR, ESP32-C3, fuente de 6 V, RDS3218, dos MG996R y buzzer, con los
    cables de 6 V, 5 V, GND, PWM, USB serie y CSI. Se regenera con scripts/diagrama_componentes.py.
    [diagrama_componentes.py]
2026-11-08 Repo ordenado para un lector externo: docs/ por temas y mapa de lectura
    - docs/consigna/: enunciado (md y pdf) y checklist de la consigna.
    - docs/hardware/: fotos (Wall-E y componentes), diagrama eléctrico interactivo y hojas de datos.
    - docs/cad_anteriores/: diseños v1 a v4 (el v6 R4 vigente sigue en docs/diseno_v6/).
    - docs/revisiones/: revisiones de Codex.
    - docs/README.md: mapa de la documentación con un recorrido sugerido; README en cada carpeta nueva.
    - README: estructura del repositorio en árbol.
    - Referencias actualizadas en todo el repo (también comentarios del firmware, scripts del CAD, el informe
    y la guía), respetando los finales de línea. Sin cambios en el código del r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
    [0_ensamble_referencia.step, 1_base.step, 2_soporte_pan_U.step, 3_soporte_tilt_y_roll.step, 4_placa_cabeza_roll.step, 5_separador_pivote.step, bateria_lipo_3s.step, bornera_5v.step]
2026-11-08 Video de la demostración (youtu.be/raOJljv1mVU): miniatura en el README y reproductor en el informe
    - README: sección del video con miniatura (portada de Wall-E con botón de play) que abre YouTube, y fila en Entregables.
    - Informe (las dos versiones): miniatura con enlace en la portada, celda con el reproductor de YouTube (IFrame,
    se ve en Colab sin ejecutar), enlace y duración en la sección 13 y el video marcado en el checklist.
2026-11-08 Panel del celular en el README y el informe (7.5), con captura y botones explicados
    - scripts/captura_panel.py: levanta el panel real con un estado de ejemplo, lo captura con tamaño de celular
    (Chromium sin ventana) y arma docs/img/panel_celular.png (dos pantallas + qué hace cada grupo de botones).
    - README: sección "Panel del celular". Informe (las dos versiones): sección 7.5 con la tabla de botones y la figura.
    - Arreglo en la app: el botón Ejes mostraba "Ejesyaw, pitch y roll" (la regla del <small> era solo para los
    modos). Test de regresión en tests/test_panel_web.py.
    [captura_panel.py]
2026-11-08 Informe: contribuciones de cada integrante y uso de IA (Claude Code y revisiones de Codex)
2026-11-08 Informe: tabla de contribuciones sin las columnas de pruebas y documentación (no las pide la consigna)
2026-11-08 Informe: celdas ejecutadas de nuevo sobre la versión entregada
2026-11-08 Overlay de monitoreo en el informe (Figura 10) y el README, dibujado por keepon/overlay.py sobre una escena sintética
    scripts/figura_overlay.py llama a la función real dibujar() con dos siluetas (sin personas reales) y los datos de un
    momento típico (objetivo con ME_MIRA y camiseta de Olimpia, otra persona saludando, dueños de cuello y buzzer), y
    arma la figura con la explicación de cada elemento. Con esto el informe no tiene más [Completar].
    [figura_overlay.py]
2026-11-08 Guía PDF al día para la defensa: Wall-E, curva S, roll, Observador, HOME/Ejes, polca, figuras y preguntas probables
    - Portada con la foto del robot, integrantes, video y versión; 258 tests.
    - Curva S (cap. 6), roll con signo verificado y servo nuevo (cap. 5), Observador «exploracion», HOME enclavado y
    Ejes (caps. 1, 13 y 16), camiseta una vez por aparición, el beep del modo corta cualquier sonido (el último gana).
    - Fotos de Wall-E, diagrama de componentes, overlay y panel del celular; línea de tiempo con el 08/11.
    - Aportes de cada integrante y uso de IA; lo que falta, al día.
    - Capítulo 19 nuevo: 18 preguntas probables de la defensa con respuesta corta.
    - Informe: la limitació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
2026-11-09 Informe y guía: Tímido, Atrevido, Maleducado, dos personas, pérdida y STOP probados en el robot (video de las 8 pruebas)
    Antes figuraban solo en simulación. Tiempos reales del video en la sección 13 (0:10 ejes, 0:28 Observador,
    0:38 seguimiento, 1:05 saludo, 1:12 camisetas, 1:33 personalidades, 2:05 arbitraje, 2:15 pérdida y STOP).
    Queda pendiente validar el umbral de ME_MIRA con la cámara calibrada.
